kebag-logic/shish-lan/documentation/U1-LAN96455F-I_8MW_pin_out.md

# U1: LAN96455F-I/8MW

| Pin No | Pin Name | Connected to net |
| - | - | - |
| 1 | P2.A_P | /switch/switch_phys/RJ45_Connector_Port2/TRD1+_2 |
| 2 | P2.A_N | /switch/switch_phys/RJ45_Connector_Port2/TRD1-_2 |
| 3 | VDD_AL | /switch/switch_power/VDD_PHYS |
| 4 | P2.B_P | /switch/switch_phys/RJ45_Connector_Port2/TRD2+_2 |
| 5 | P2.B_N | /switch/switch_phys/RJ45_Connector_Port2/TRD2-_2 |
| 6 | VDD_AH | /switch/switch_power/VDDIO_PHY_AH |
| 7 | P2.C_P | /switch/switch_phys/RJ45_Connector_Port2/TRD3+_2 |
| 8 | P2.C_N | /switch/switch_phys/RJ45_Connector_Port2/TRD3-_2 |
| 9 | P2.D_P | /switch/switch_phys/RJ45_Connector_Port2/TRD4+_2 |
| 10 | P2.D_N | /switch/switch_phys/RJ45_Connector_Port2/TRD4-_2 |
| 11 | P3.A_P | /switch/switch_phys/RJ45_Connector_Port3/TRD1+_3 |
| 12 | P3.A_N | /switch/switch_phys/RJ45_Connector_Port3/TRD1-_3 |
| 13 | P3.B_P | /switch/switch_phys/RJ45_Connector_Port3/TRD2+_3 |
| 14 | P3.B_N | /switch/switch_phys/RJ45_Connector_Port3/TRD2-_3 |
| 15 | VDD_AL | /switch/switch_power/VDD_PHYS |
| 16 | VDD_AH | /switch/switch_power/VDDIO_PHY_AH |
| 17 | P3.C_P | /switch/switch_phys/RJ45_Connector_Port3/TRD3+_3 |
| 18 | P3.C_N | /switch/switch_phys/RJ45_Connector_Port3/TRD3-_3 |
| 19 | P3.D_P | /switch/switch_phys/RJ45_Connector_Port3/TRD4+_3 |
| 20 | P3.D_N | /switch/switch_phys/RJ45_Connector_Port3/TRD4-_3 |
| 21 | P4.A_P | n.c. |
| 22 | P4.A_N | n.c. |
| 23 | P4.B_P | n.c. |
| 24 | P4.B_N | n.c. |
| 25 | VDD_AH | /switch/switch_power/VDDIO_PHY_AH |
| 26 | P4.C_P | n.c. |
| 27 | P4.C_N | n.c. |
| 28 | VDD_AL | /switch/switch_power/VDD_PHYS |
| 29 | P4.D_P | n.c. |
| 30 | P4.D_N | n.c. |
| 31 | GPIO_43/SI_CLK/PHY0_LED1/SG0_LD/IRQ3/MAC_LED8/SD1/TMS | /switch/switch_gpios/PHY0_LED1 |
| 32 | VDD_IO_E | /switch/switch_power/VDDIO |
| 33 | GPIO_42/SI_nCS/PHY0_LED0/SG0_DI/IRQ2/MAC_LED7/SD0/NTRST | /switch/switch_gpios/PHY0_LED0 |
| 34 | GPIO_41/SI_DO/PHY1_LED1/SG0_DO/IRQ1/MAC_LED6/-/TDO|XMII_MODE0 | /switch/switch_gpios/XMII_MODE0 |
| 35 | GPIO_40/SI_DI/PHY1_LED0/SG0_CLK/-/MAC_LED5/-/TCK|SD_MODE1 | /switch/switch_gpios/SD_MODE1 |
| 36 | GPIO_39/UART_TXD/PHY2_LED1/-/-/MAC_LED4/-/TDI|SD_MODE0 | /switch/switch_gpios/SD_MODE0 |
| 37 | VDD | /switch/1V15_BUCK-OUT |
| 38 | GPIO_38/-/PHY2_LED0/PHY0_LED0/-/MAC_LED3/-/-|XMII_MODE1 | /switch/switch_gpios/XMII_MODE1 |
| 39 | VDD_IO_E | /switch/switch_power/VDDIO |
| 40 | GPIO_37/PTP1/PHY3_LED1/PHY1_LED0/-/MAC_LED2/-/-|GPIO_MODE1 | /switch/switch_gpios/GPIO_MODE1 |
| 41 | GPIO_36/PTP0/PHY3_LED0/PHY2_LED0/-/MAC_LED1/-/-|GPIO_MODE0 | /switch/switch_gpios/GPIO_MODE0 |
| 42 | GPIO_35/RCLK1/PHY4_LED1/PHY3_LED0/-/MAC_LED0/-/-|LOOP_EN | /switch/switch_gpios/LOOP_EN |
| 43 | GPIO_34/RCLK0/PHY4_LED0/PHY4_LED0/-/-/-/-|JTAG_EN | /switch/switch_gpios/JTAG_EN |
| 44 | VDD_AHS | /switch/switch_power/VDDIO_PHY_AHS |
| 45 | S0.CLKP | n.c. |
| 46 | S0.TX_N | n.c. |
| 47 | VDD_ALS0 | /switch/switch_power/VDD_SERDES |
| 48 | S0.TX_P | n.c. |
| 49 | S0.RX_N | n.c. |
| 50 | S0.RX_P | n.c. |
| 51 | RESREF | n.c. |
| 52 | VDD_AHS | /switch/switch_power/VDDIO_PHY_AHS |
| 53 | S1.TX_N | n.c. |
| 54 | VDD_ALS1 | /switch/switch_power/VDD_SERDES |
| 55 | S1.TX_P | n.c. |
| 56 | S1.RX_N | n.c. |
| 57 | S1.RX_P | n.c. |
| 58 | VDD_IO_D | /switch/switch_power/VDDIO |
| 59 | VDD | /switch/1V15_BUCK-OUT |
| 60 | GPIO_33/PTP3/IRQ0/|EEPROM_SIZE | /switch/switch_gpios/EEPROM_SIZE |
| 61 | GPIO_32/PTP2/I2C0_SCL1/-/-/-/-/- | /switch/switch_gpios/PTP2 |
| 62 | GPIO_31/PTP1/I2C0_SCL0/UART_TXD/-/-/-/- | /switch/switch_gpios/PTP1 |
| 63 | GPIO_30/PTP0/I2C0_SDA/UART_RXD/-/-/-/- | /switch/switch_gpios/PTP0 |
| 64 | GPIO_29/RCLK1/MIIM0_MDIO/-/-/-/-/- | /switch/switch_gpios/SYNCE_1 |
| 65 | GPIO_28/RCLK0/MIIM0_MDC/-/-/-/-/-|MGMT_MODE1 | /switch/switch_gpios/MGMT_MODE1 |
| 66 | GPIO_27/RGMII0_TXD3/-/-/-/-/-/-|MGMT_MODE0 | /switch/switch_gpios/MGMT_MODE0 |
| 67 | GPIO_26/RGMII0_TXD2/-/-/-/-/-/-|BOOT_MODE2 | /switch/switch_gpios/BOOT_MODE2 |
| 68 | GPIO_25/RGMII0_TXD1/-/-/-/-/-/-|BOOT_MODE1 | /switch/switch_gpios/BOOT_MODE1 |
| 69 | VDD_IO_C | /switch/switch_power/VDDIO |
| 70 | GPIO_24/RGMII0_TXD0/-/-/-/-/-/-|BOOT_MODE0 | /switch/switch_gpios/BOOT_MODE0 |
| 71 | GPIO_23/RGMII0_TXCTL-TX_DV/-/-/-/-/-/-|SD_125M | /switch/switch_gpios/SD_125M |
| 72 | GPIO_22/RGMII0_TXC-REFCLK/-/-/-/-/-/-|GPIO_EN | /switch/switch_gpios/SGPIO_EN |
| 73 | VDD | /switch/1V15_BUCK-OUT |
| 74 | GPIO_21/RGMII0_RXCTL-CRS_DV | /switch/switch_gpios/RGMII0.RX_CTLR |
| 75 | GPIO_20/RGMII0_RXC-REFCLK | /switch/switch_gpios/RGMII0.RX_CLK |
| 76 | GPIO_19/RGMII0_RXD3 | /switch/switch_gpios/RGMII0.RXD3 |
| 77 | VDD_IO_C | /switch/switch_power/VDDIO |
| 78 | GPIO_18/RGMII0_RXD2-RXER | /switch/switch_gpios/RGMII0.RXD2 |
| 79 | GPIO_17/RGMII0_RXD1 | /switch/switch_gpios/RGMII0.RXD1 |
| 80 | GPIO_16/RGMII0_RXD0 | /switch/switch_gpios/RGMII0.RXD0 |
| 81 | GPIO_15/RGMII1_TXD3/I2C0_SCL13/-/PTP3/-/-/-|SFP_EN | /switch/switch_gpios/SFP_EN |
| 82 | GPIO_14/RGMII1_TXD2/I2C0_SCL12/-/PTP2/-/MAC_LED5/-/-|_CUPHY_MODE | /switch/switch_gpios/CUPHY_MODE |
| 83 | GPIO_13/RGMII1_TXD1/I2C0_SCL11/-/PTP1/MAC_LED6/-/-|LED_MODE | /switch/switch_gpios/LED_MODE |
| 84 | VDD_IO_B | /switch/switch_power/VDDIO |
| 85 | GPIO_12/RGMII1_TXD0/I2C0_SCL10/MIIM1_MDIO/PTP0/-/-/-|EEE_EN | /switch/switch_gpios/EEE_EN |
| 86 | GPIO_11/RGMII1_TXCTL-TX_DV/I2C0_SCL9/MIIM1_MDC/-/IRQ3/-/-|_FLOW_EN | /switch/switch_gpios/FLOW_EN |
| 87 | GPIO_10/RGMII1_TXC-REFCLK/I2C0_SCL8/RCLK1/SG0_LD/IRQ2/UART_TXD/-|_E2E_CLOCK_EN | /switch/switch_gpios/E2E_CLOCK_EN |
| 88 | VDD | /switch/1V15_BUCK-OUT |
| 89 | GPIO_9/RGMII1_RXCTL-CRS_DV/I2C0_SCL7/RCLK0/SG0_DI/IRQ1/UART_RXD/- | /controller/RGMII1_SWITCH_STM.RXCTL-CRS_DV |
| 90 | GPIO_8/RGMII1_RXC-REFCLK/I2C0_SCL6/SD1/SG0_DO/MIIM1_MDIO/-/- | /controller/RGMII1_SWITCH_STM.RX_CLK |
| 91 | GPIO_7/RGMII1_RXD3/I2C0_SCL5/SD0/SG0_CLK/MIIM1_MDC/SI_SLV_CLK/- | /controller/RGMII1_SWITCH_STM.RXD3 |
| 92 | VDD_IO_B | /switch/switch_power/VDDIO |
| 93 | GPIO_6/RGMII1_RXD2-RXER/I2C0_SCL4/-/-/-/SI_SLV_nCS/- | /controller/RGMII1_SWITCH_STM.RXD2 |
| 94 | GPIO_5/RGMII1_RXD1/I2C0_SCL3/I2C1_SCL/-/-/SI_SLV_DO/- | /controller/RGMII1_SWITCH_STM.RXD1 |
| 95 | GPIO_4/RGMII1_RXD0/I2C0_SCL2/I2C1_SDA/-/-/SI_SVL_DI/- | /controller/RGMII1_SWITCH_STM.RXD0 |
| 96 | VDD_IO_A | /switch/switch_power/VDDIO |
| 97 | GPIO_3/SI_CLK//SI_SLV_CLK/I2C1_SCL/MIIM_SLV_MDIO/-/-/- | <unnamed> |
| 98 | GPIO_2/SI_nCS/SI_SLV_nCS/I2C1_SDA/-/-/-/- | /controller/SPI2_STM_SWITCH.nCS |
| 99 | GPIO_1/SI_DO/SI_SLV_DO/I2C_SLV_SCL/MIIM_SLV_MDC/UART_TXD/MIIM_MDIO/- | <unnamed> |
| 100 | GPIO_0/SI_DI/SI_SLV_DI/I2C_SLV_SDA/MIIM_SLV_ADDR/UART_RXD/MIIM1_MDC/- | <unnamed> |
| 101 | nRST | /switch/nRST_STM_TO_SWITCH |
| 102 | P0.A_P | /switch/switch_phys/RJ45_Connector_Port0/TRD1+_0 |
| 103 | P0.A_N | /switch/switch_phys/RJ45_Connector_Port0/TRD1-_0 |
| 104 | VDD_AL | /switch/switch_power/VDD_PHYS |
| 105 | P0.B_P | /switch/switch_phys/RJ45_Connector_Port0/TRD2+_0 |
| 106 | P0.B_N | /switch/switch_phys/RJ45_Connector_Port0/TRD2-_0 |
| 107 | VDD_AH | /switch/switch_power/VDDIO_PHY_AH |
| 108 | P0.C_P | /switch/switch_phys/RJ45_Connector_Port0/TRD3+_0 |
| 109 | P0.C_N | /switch/switch_phys/RJ45_Connector_Port0/TRD3-_0 |
| 110 | P0.D_P | /switch/switch_phys/RJ45_Connector_Port0/TRD4+_0 |
| 111 | P0.D_N | /switch/switch_phys/RJ45_Connector_Port0/TRD4-_0 |
| 112 | P1.A_P | /switch/switch_phys/RJ45_Connector_Port1/TRD1+_1 |
| 113 | P1.A_N | /switch/switch_phys/RJ45_Connector_Port1/TRD1-_1 |
| 114 | P1.B_P | /switch/switch_phys/RJ45_Connector_Port1/TRD2+_1 |
| 115 | P1.B_N | /switch/switch_phys/RJ45_Connector_Port1/TRD2-_1 |
| 116 | VDD_AH | /switch/switch_power/VDDIO_PHY_AH |
| 117 | P1.C_P | /switch/switch_phys/RJ45_Connector_Port1/TRD3+_1 |
| 118 | P1.C_N | /switch/switch_phys/RJ45_Connector_Port1/TRD3-_1 |
| 119 | VDD_AL | /switch/switch_power/VDD_PHYS |
| 120 | P1.D_P | /switch/switch_phys/RJ45_Connector_Port1/TRD4+_1 |
| 121 | P1.D_N | /switch/switch_phys/RJ45_Connector_Port1/TRD4-_1 |
| 122 | VDD | /switch/1V15_BUCK-OUT |
| 123 | XO | Net-(U1A-XO) |
| 124 | XI | Net-(U1A-XI) |
| 125 | RTN_PLL | Net-(U1A-RTN_PLL) |
| 126 | VDD_PLL | Net-(U1A-VDD_PLL) |
| 127 | ISET | Net-(U1C-ISET) |
| 128 | VDD_AH | /switch/switch_power/VDDIO_PHY_AH |
| EPAD | GND_PAD | GND |
