kebag-logic/shish-lan/documentation/U4-STM32H742VGT6_pin_out.md

# U4: STM32H742VGT6

| Pin No | Pin Name | Connected to net |
| - | - | - |
| 1 | PE2 | /controller/debug_header/P3 |
| 2 | PE3 | /controller/debug_header/P4 |
| 3 | PE4 | /controller/debug_header/P5 |
| 4 | PE5 | /controller/debug_header/P6 |
| 5 | PE6 | /controller/debug_header/P7 |
| 6 | VBAT | Net-(U4-VBAT) |
| 7 | PC13 | n.c. |
| 8 | PC14 | n.c. |
| 9 | PC15 | n.c. |
| 10 | VSS | GND |
| 11 | VDD | Net-(U4-VBAT) |
| 12 | PH0 | /controller/xtal_stm/Pin1 |
| 13 | PH1 | /controller/xtal_stm/Pin2 |
| 14 | NRST | /controller/RST_STM_JTAG |
| 15 | PC0 | n.c. |
| 16 | PC1 | /controller/MIIM0_STM_SWITCH.SLV_MDC |
| 17 | PC2_C | n.c. |
| 18 | PC3_C | n.c. |
| 19 | VSSA | GND |
| 20 | VREF+ | +3V3 |
| 21 | VDDA | Net-(U4-VBAT) |
| 22 | PA0 | n.c. |
| 23 | PA1 | /controller/RGMII1_SWITCH_STM.TXC-REFCLK |
| 24 | PA2 | /controller/MIIM0_STM_SWITCH.SLV_MDIO |
| 25 | PA3 | n.c. |
| 26 | VSS | GND |
| 27 | VDD | Net-(U4-VBAT) |
| 28 | PA4 | /controller/I2S3_WS |
| 29 | PA5 | n.c. |
| 30 | PA6 | n.c. |
| 31 | PA7 | /controller/RGMII1_SWITCH_STM.RXCTL-CRS_DV |
| 32 | PC4 | /controller/RGMII1_SWITCH_STM.TXD0 |
| 33 | PC5 | /controller/RGMII1_SWITCH_STM.TXD1 |
| 34 | PB0 | n.c. |
| 35 | PB1 | n.c. |
| 36 | PB2 | /controller/I2S3_SDO |
| 37 | PE7 | /controller/debug_header/P8 |
| 38 | PE8 | /controller/debug_header/P9 |
| 39 | PE9 | /controller/debug_header/P10 |
| 40 | PE10 | /controller/debug_header/P11 |
| 41 | PE11 | /controller/debug_header/P12 |
| 42 | PE12 | /controller/debug_header/P13 |
| 43 | PE13 | /controller/debug_header/P14 |
| 44 | PE14 | /controller/debug_header/P15 |
| 45 | PE15 | /controller/debug_header/P16 |
| 46 | PB10 | n.c. |
| 47 | PB11 | Net-(U4-PB11) |
| 48 | VCAP | Net-(C81-Pad2) |
| 49 | VSS | GND |
| 50 | VDD | Net-(U4-VBAT) |
| 51 | PB12 | Net-(U4-PB12) |
| 52 | PB13 | Net-(U4-PB13) |
| 53 | PB14 | /controller/SPI2_STM_SWITCH.MISO |
| 54 | PB15 | /controller/SPI2_STM_SWITCH.MOSI |
| 55 | PD8 | n.c. |
| 56 | PD9 | n.c. |
| 57 | PD10 | n.c. |
| 58 | PD11 | n.c. |
| 59 | PD12 | n.c. |
| 60 | PD13 | n.c. |
| 61 | PD14 | n.c. |
| 62 | PD15 | n.c. |
| 63 | PC6 | n.c. |
| 64 | PC7 | /controller/I2S3_MCK |
| 65 | PC8 | n.c. |
| 66 | PC9 | n.c. |
| 67 | PA8 | n.c. |
| 68 | PA9 | /controller/USART1_STM_SWITCH.TX |
| 69 | PA10 | /controller/USART1_STM_SWITCH.RX |
| 70 | PA11 | /controller/SPI2_STM_SWITCH.nCS |
| 71 | PA12 | /controller/SPI2_STM_SWITCH.CLK |
| 72 | PA13 | /controller/SWDIO_TMS_JTM_JTAG |
| 73 | VCAP | Net-(C83-Pad2) |
| 74 | VSS | GND |
| 75 | VDD | Net-(U4-VBAT) |
| 76 | PA14 | /controller/SWCLK_TCLK_STM_JTAG |
| 77 | PA15 | /controller/TDI_STM_JTAG |
| 78 | PC10 | /controller/I2S3_CK |
| 79 | PC11 | /controller/I2S_SDI |
| 80 | PC12 | n.c. |
| 81 | PD0 | /switch/EN-1V15_STM_TO_BUCK |
| 82 | PD1 | /switch/EN-2V5_STM_TO_BUCK |
| 83 | PD2 | /switch/nRST_STM_TO_SWITCH |
| 84 | PD3 | /switch/IRQ0_SWITCH_TO_STM |
| 85 | PD4 | n.c. |
| 86 | PD5 | n.c. |
| 87 | PD6 | n.c. |
| 88 | PD7 | n.c. |
| 89 | PB3 | /controller/SWO_TDO_STM_JTAG |
| 90 | PB4 | /controller/TRST_STM_JTAG |
| 91 | PB5 | n.c. |
| 92 | PB6 | /controller/I2C1.SCL |
| 93 | PB7 | /controller/I2C1.SDA |
| 94 | BOOT0 | Net-(J6-Pin_2) |
| 95 | PB8 | n.c. |
| 96 | PB9 | n.c. |
| 97 | PE0 | /controller/debug_header/P1 |
| 98 | PE1 | /controller/debug_header/P2 |
| 99 | VSS | GND |
| 100 | VDD | Net-(U4-VBAT) |
