kebag-logic/shish-lan/documentation/current_consumption.md

| Identifier | Name | I_DD_1V15_max_A | I_DD_AH25_2V5_max_A | I_DD_AH33_3V3_max_A | I_DD_ALSx_1V15_max_A | I_DD_AL_1V15_max_A | I_DD_IO25_2V5_max_A | I_DD_IO33_3V3_max_A | I_DD_IOD | I_DD_max_A | I_OUT_A | I_VIN_A |
|---|---|---|---|---|---|---|---|---|---|---|---|---|
| U1 | LAN96455F-I/8MW | 0.935 | 0.475 | 0.505 | 0.025 | 0.4 | 0.045 | 0.075 | 0.005 |  |  |  |
| U2 | TPS564257DRLR |  |  |  |  |  |  |  |  |  | 4.0 | 0.00037 |
| U3 | TPS564257DRLR |  |  |  |  |  |  |  |  |  | 4.0 | 0.00037 |
| U4 | STM32H742VGT6 |  |  |  |  |  |  |  |  | 0.544 |  |  |
| U5 | TPS564257DRLR |  |  |  |  |  |  |  |  |  | 4.0 | 0.00037 |
| Sum |  | 0.935 | 0.475 | 0.505 | 0.025 | 0.4 | 0.045 | 0.075 | 0.005 | 0.544 | 12.0 | 0.00111 |
