kebag-logic/shish-lan/documentation/pcb.pdf

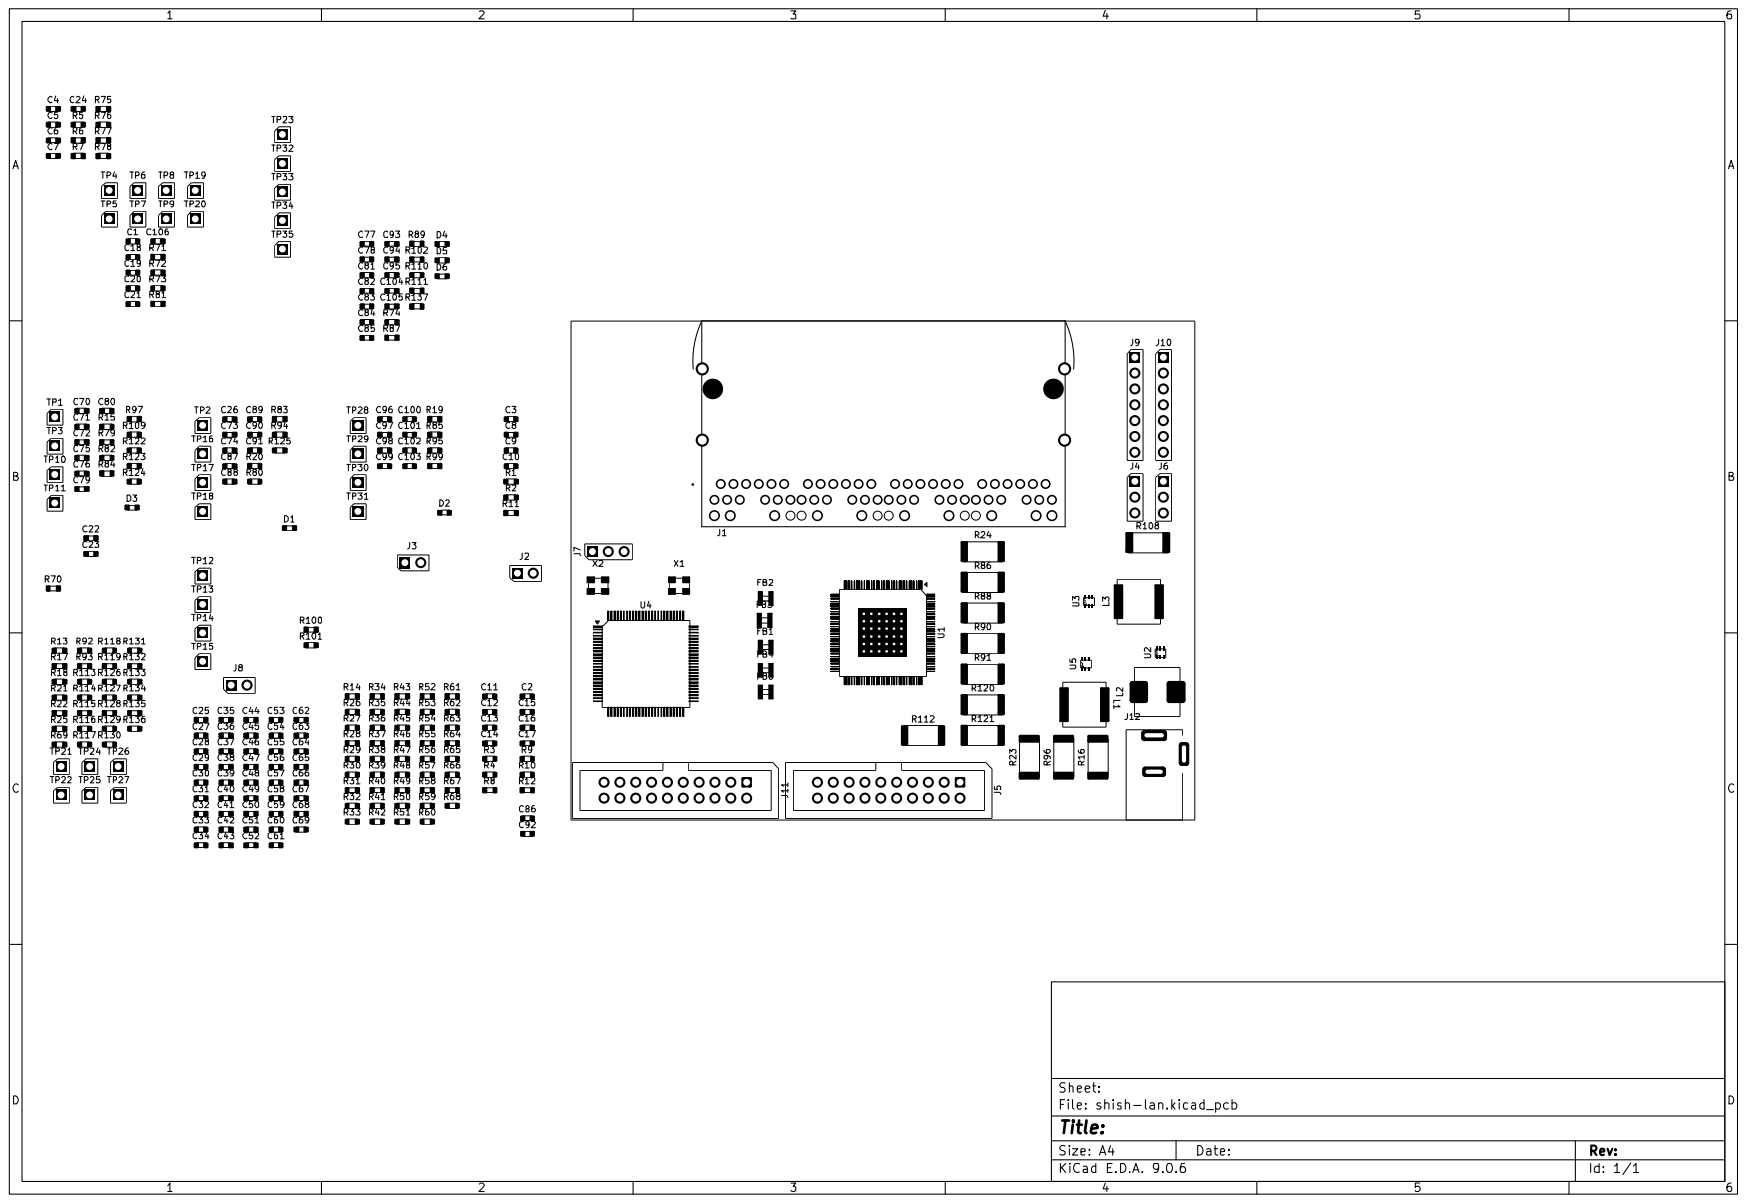
[picture p4: page 1]
