kebag-logic/shish-lan/shish-lan.kicad_pcb

## KiCad design shish-lan.kicad_pcb (2026-09-29)

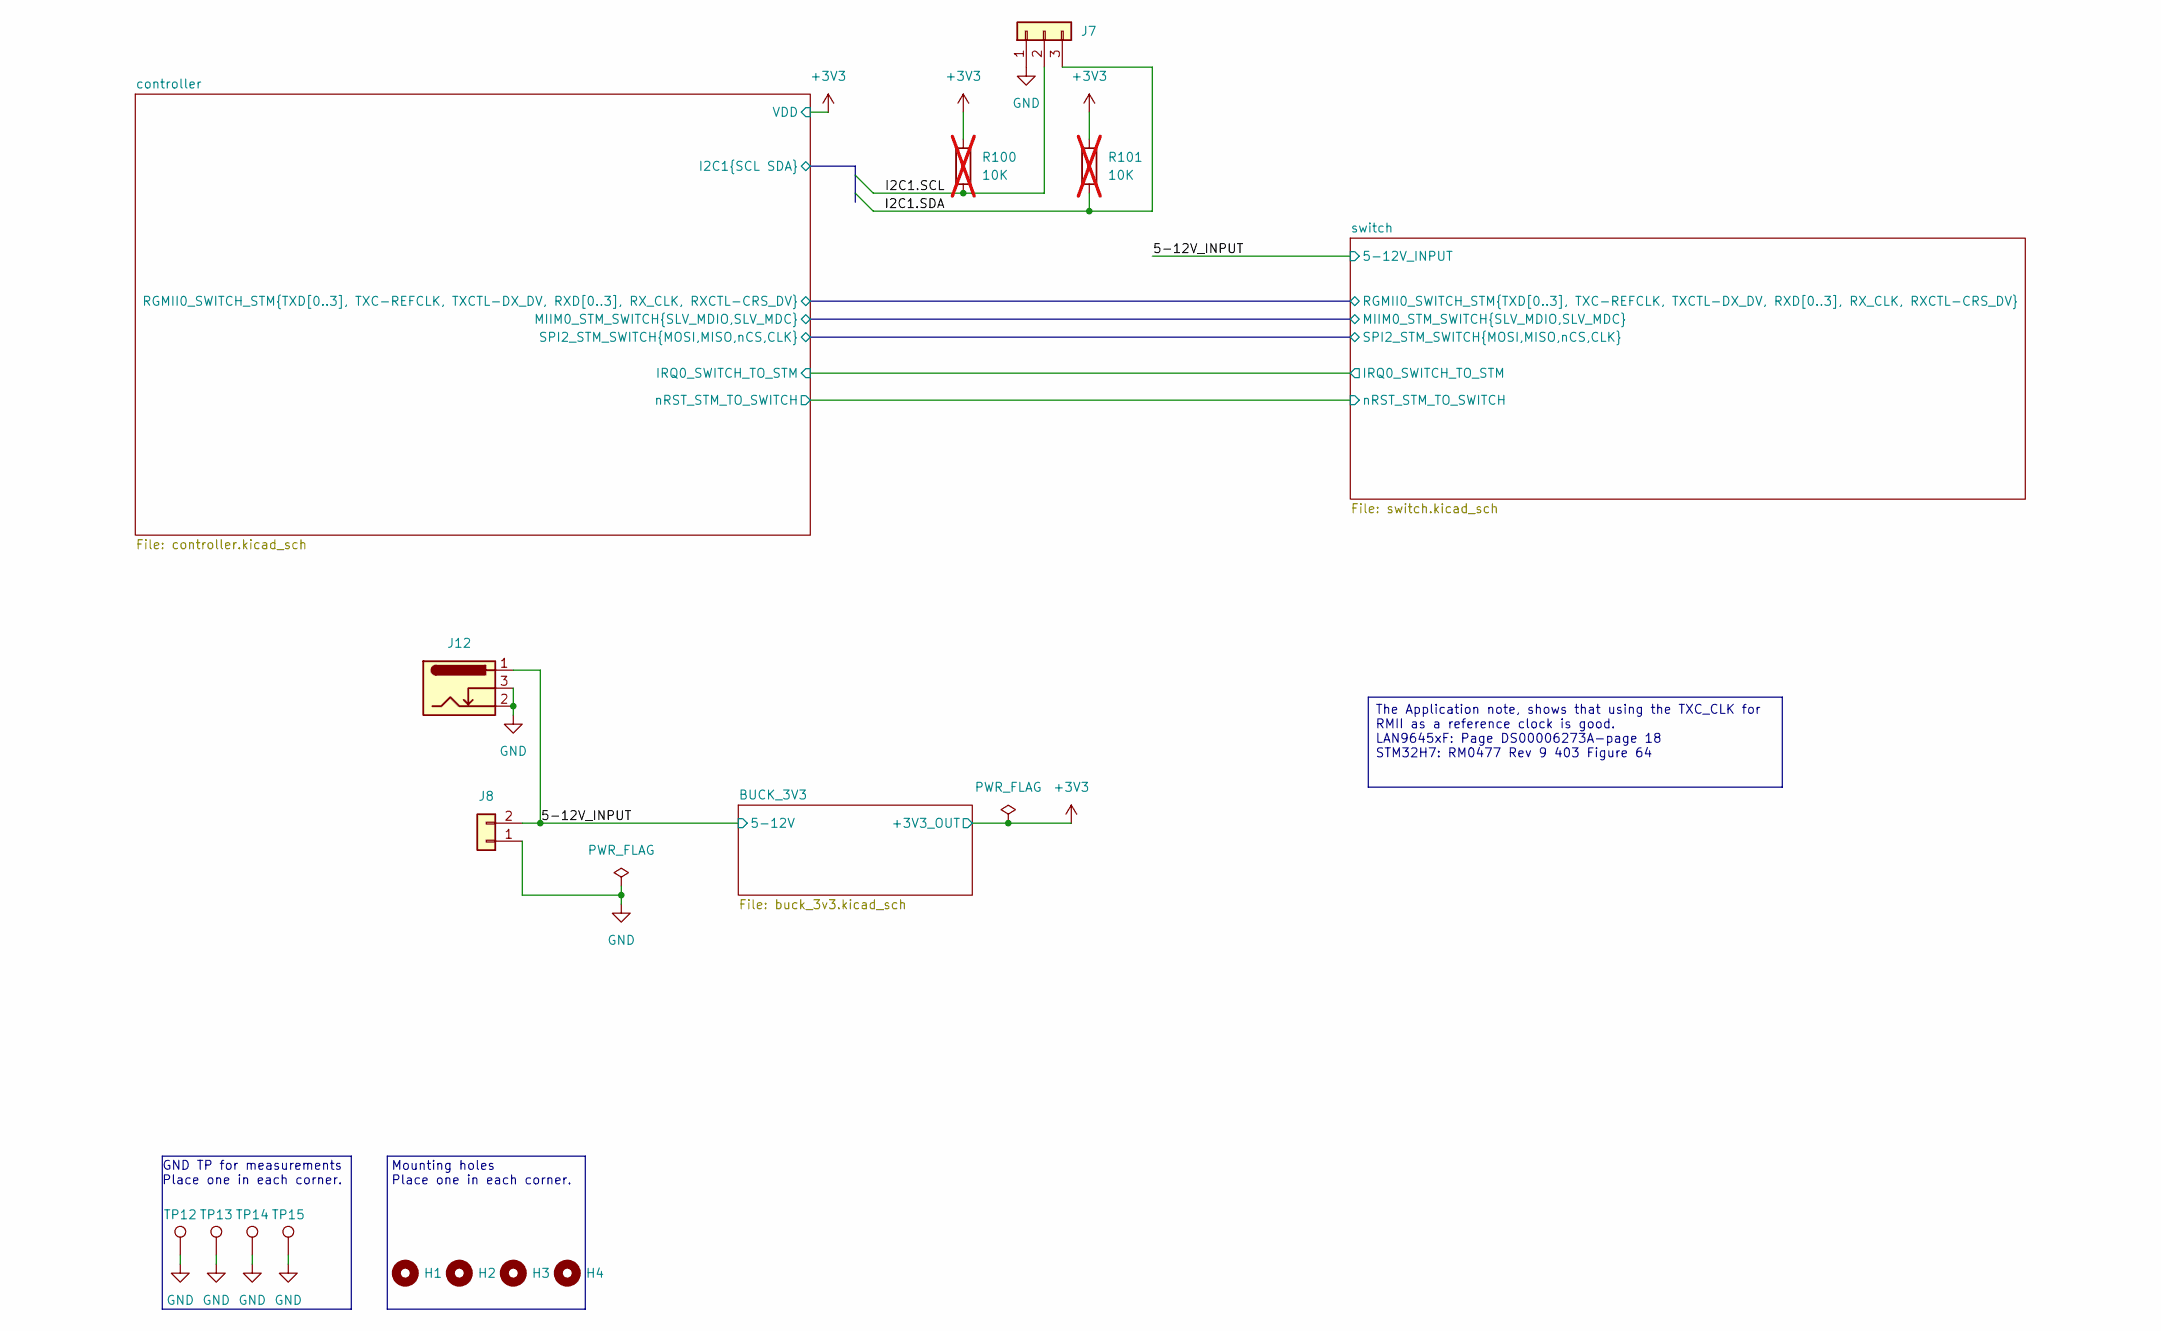
[picture p5: schematic shish-lan.kicad_sch, TOP level overview]

Parts:
H1, H2, H3, H4: MountingHole_M3; MountingHole_3.2mm_M3_Pad
J7: Header_03x01_2.54mm_0mm_Straight; 03x01_2.54mm_Header; MPN 87224-3; Mouser 571-872243
J8: Header_02x01_2.54mm_0mm_Straight; 02x01_2.54mm_Header; MPN 87224-2; Mouser 571-872242
J12: DC-Jack_Wuerth_694108301002; MPN 694108301002; Mouser 710-694108301002
R100, R101: 10K; R_0603; Tolerance_in_pct 5; MPN CRCW060310K0JNEC; Mouser 71-CRCW060310K0JNEC; not fitted
TP12, TP13, TP14, TP15: TestPoint

Connections:
+3V3: R100.1, R101.1; also elsewhere on the board
/5-12V_INPUT: J8.2, J12.1; also elsewhere on the board
/controller/I2C1.SCL: J7.2, R100.2; also elsewhere on the board
/controller/I2C1.SDA: J7.3, R101.2; also elsewhere on the board
GND: J7.1, J8.1, J12.2, J12.3, TP12.1 (1_1), TP13.1 (1_1), TP14.1 (1_1), TP15.1 (1_1); also elsewhere on the board

Notes on the sheet:
Mounting holes Place one in each corner.
GND TP for measurements Place one in each corner.
The Application note, shows that using the TXC_CLK for RMII as a reference clock is good. LAN9645xF: Page DS00006273A-page 18 STM32H7: RM0477 Rev 9 403 Figure 64

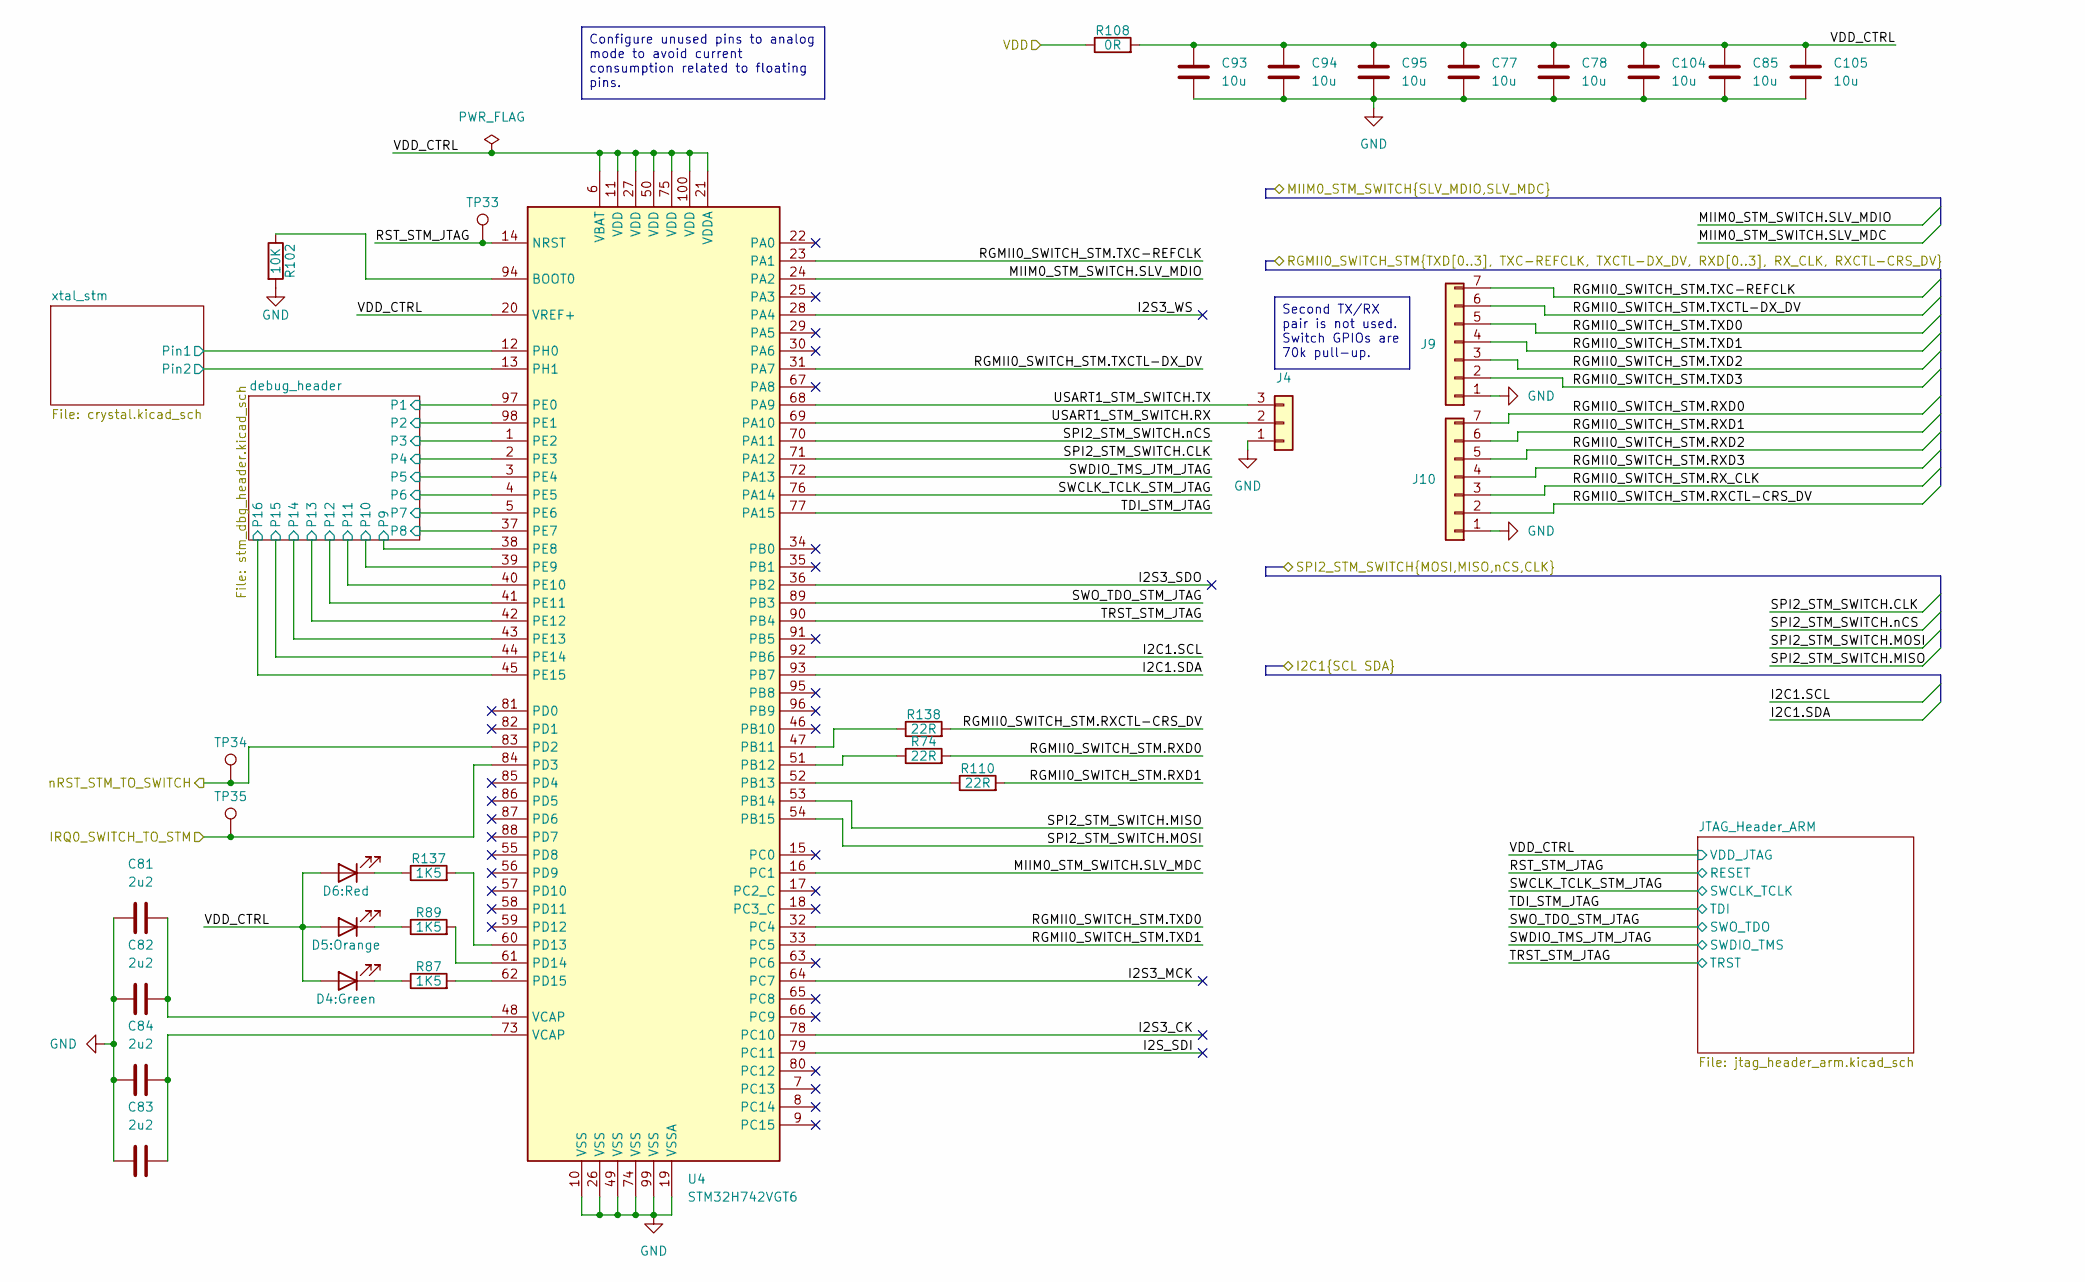
[picture p6: schematic controller.kicad_sch]

Parts:
C77, C78, C85, C93, C94, C95, C104, C105: 10u; C_0603; Voltage_in_V 25; Tolerance_in_pct 20; MPN CL10A106MA8NRNC; Mouser 187-CL10A106MA8NRNC
C81, C82, C83, C84: 2u2; C_0603; Voltage_in_V 35; Tolerance_in_pct 20; MPN GRM188R6YA225MA12D; Mouser 81-GRM188R6YA225MA2D
D4: LED_{color}_{U_F}_{I_F}; LED_0603; MPN LTST-C190GKT; Mouser 859-LTST-C190GKT
D5: LED_{color}_{U_F}_{I_F}; LED_0603; MPN LTST-C190KFKT; Mouser 859-LTST-C190KFKT
D6: LED_{color}_{U_F}_{I_F}; LED_0603; MPN LTST-C194KRKT; Mouser 859-LTST-C194KRKT
J4: Header_03x01_2.54mm_0mm_Straight; 03x01_2.54mm_Header; MPN 87224-3; Mouser 571-872243
J9, J10: Header_07x01_2.54mm_0mm_Straight; 07x01_2.54mm_Header; MPN TLW-107-06-G-S; Mouser 200-TLW10706GS
R74, R110, R138: 22R; R_0603; Tolerance_in_pct 1; MPN RC0603FR-1022RL; Mouser 603-RC0603FR-1022RL
R87, R89, R137: 1K5; R_0603; Tolerance_in_pct 5; MPN AC0603JR-071K5L; Mouser 603-AC0603JR-071K5L
R102: 10K; R_0603; Tolerance_in_pct 5; MPN CRCW060310K0JNEC; Mouser 71-CRCW060310K0JNEC
R108: 0R; R_2512; Tolerance_in_pct 5; MPN CRF2512-J/-000ELF; Mouser 652-CRF2512-J-000ELF
TP33, TP34, TP35: TestPoint
U4: STM32H742VGT6; LQFP-100_14x14mm_P0.5mm; MPN STM32H742VGT6; Mouser 511-STM32H742VGT6

Connections:
+3V3: R108.1; also elsewhere on the board
/controller/I2C1.SCL: U4.92 (PB6); also elsewhere on the board
/controller/I2C1.SDA: U4.93 (PB7); also elsewhere on the board
/controller/I2S3_CK: U4.78 (PC10)
/controller/I2S3_MCK: U4.64 (PC7)
/controller/I2S3_SDO: U4.36 (PB2)
/controller/I2S3_WS: U4.28 (PA4)
/controller/I2S_SDI: U4.79 (PC11)
/controller/MIIM0_STM_SWITCH.SLV_MDC: U4.16 (PC1); also elsewhere on the board
/controller/MIIM0_STM_SWITCH.SLV_MDIO: U4.24 (PA2); also elsewhere on the board
/controller/RGMII0_SWITCH_STM.RXCTL-CRS_DV: J10.2, R138.2; also elsewhere on the board
/controller/RGMII0_SWITCH_STM.RXD0: J10.7 (Pin_3), R74.2; also elsewhere on the board
/controller/RGMII0_SWITCH_STM.RXD1: J10.6 (Pin_3), R110.2; also elsewhere on the board
/controller/RGMII0_SWITCH_STM.RXD2: J10.5 (Pin_2); also elsewhere on the board
/controller/RGMII0_SWITCH_STM.RXD3: J10.4 (Pin_1); also elsewhere on the board
/controller/RGMII0_SWITCH_STM.RX_CLK: J10.3; also elsewhere on the board
/controller/RGMII0_SWITCH_STM.TXC-REFCLK: J9.7 (Pin_3), U4.23 (PA1); also elsewhere on the board
/controller/RGMII0_SWITCH_STM.TXCTL-DX_DV: J9.6 (Pin_3), U4.31 (PA7); also elsewhere on the board
/controller/RGMII0_SWITCH_STM.TXD0: J9.5 (Pin_2), U4.32 (PC4); also elsewhere on the board
/controller/RGMII0_SWITCH_STM.TXD1: J9.4 (Pin_1), U4.33 (PC5); also elsewhere on the board
/controller/RGMII0_SWITCH_STM.TXD2: J9.3; also elsewhere on the board
/controller/RGMII0_SWITCH_STM.TXD3: J9.2; also elsewhere on the board
/controller/RST_STM_JTAG: TP33.1 (1_1), U4.14 (NRST); also elsewhere on the board
/controller/SPI2_STM_SWITCH.CLK: U4.71 (PA12); also elsewhere on the board
/controller/SPI2_STM_SWITCH.MISO: U4.53 (PB14); also elsewhere on the board
/controller/SPI2_STM_SWITCH.MOSI: U4.54 (PB15); also elsewhere on the board
/controller/SPI2_STM_SWITCH.nCS: U4.70 (PA11); also elsewhere on the board
/controller/SWCLK_TCLK_STM_JTAG: U4.76 (PA14); also elsewhere on the board
/controller/SWDIO_TMS_JTM_JTAG: U4.72 (PA13); also elsewhere on the board
/controller/SWO_TDO_STM_JTAG: U4.89 (PB3); also elsewhere on the board
/controller/TDI_STM_JTAG: U4.77 (PA15); also elsewhere on the board
/controller/TRST_STM_JTAG: U4.90 (PB4); also elsewhere on the board
/controller/USART1_STM_SWITCH.RX: J4.2, U4.69 (PA10)
/controller/USART1_STM_SWITCH.TX: J4.3, U4.68 (PA9)
/controller/VDD_CTRL: C77.1, C78.1, C85.1, C93.1, C94.1, C95.1, C104.1, C105.1, D4.2 (A), D5.2 (A), D6.2 (A), R108.2, U4.6 (VBAT), U4.11 (VDD), U4.20 (VREF+), U4.21 (VDDA), U4.27 (VDD), U4.50 (VDD), U4.75 (VDD), U4.100 (VDD); also elsewhere on the board
/controller/debug_header/P1: U4.97 (PE0); also elsewhere on the board
/controller/debug_header/P2: U4.98 (PE1); also elsewhere on the board
/controller/debug_header/P3: U4.1 (PE2); also elsewhere on the board
/controller/debug_header/P4: U4.2 (PE3); also elsewhere on the board
/controller/debug_header/P5: U4.3 (PE4); also elsewhere on the board
/controller/debug_header/P6: U4.4 (PE5); also elsewhere on the board
/controller/debug_header/P7: U4.5 (PE6); also elsewhere on the board
/controller/debug_header/P8: U4.37 (PE7); also elsewhere on the board
/controller/debug_header/P9: U4.38 (PE8); also elsewhere on the board
/controller/debug_header/P10: U4.39 (PE9); also elsewhere on the board
/controller/debug_header/P11: U4.40 (PE10); also elsewhere on the board
/controller/debug_header/P12: U4.41 (PE11); also elsewhere on the board
/controller/debug_header/P13: U4.42 (PE12); also elsewhere on the board
/controller/debug_header/P14: U4.43 (PE13); also elsewhere on the board
/controller/debug_header/P15: U4.44 (PE14); also elsewhere on the board
/controller/debug_header/P16: U4.45 (PE15); also elsewhere on the board
/controller/xtal_stm/Pin1: U4.12 (PH0); also elsewhere on the board
/controller/xtal_stm/Pin2: U4.13 (PH1); also elsewhere on the board
/switch/IRQ0_SWITCH_TO_STM: TP35.1 (1_1), U4.84 (PD3); also elsewhere on the board
/switch/nRST_STM_TO_SWITCH: TP34.1 (1_1), U4.83 (PD2); also elsewhere on the board
GND: C77.2, C78.2, C81.1, C82.1, C83.1, C84.1, C85.2, C93.2, C94.2, C95.2, C104.2, C105.2, J4.1, J9.1, J10.1, R102.2, U4.10 (VSS), U4.19 (VSSA), U4.26 (VSS), U4.49 (VSS), U4.74 (VSS), U4.99 (VSS); also elsewhere on the board
unnamed: C81.2, C82.2, U4.48 (VCAP)
unnamed: C83.2, C84.2, U4.73 (VCAP)
unnamed: D4.1 (K), R87.1
unnamed: D5.1 (K), R89.1
unnamed: D6.1 (K), R137.1
unnamed: R102.1, U4.94 (BOOT0)
unnamed: R138.1, U4.47 (PB11)
unnamed: R74.1, U4.51 (PB12)
unnamed: R110.1, U4.52 (PB13)
unnamed: R137.2, U4.60 (PD13)
unnamed: R89.2, U4.61 (PD14)
unnamed: R87.2, U4.62 (PD15)

Notes on the sheet:
Second TX/RX pair is not used. Switch GPIOs are 70k pull-up.
Configure unused pins to analog mode to avoid current consumption related to floating pins.

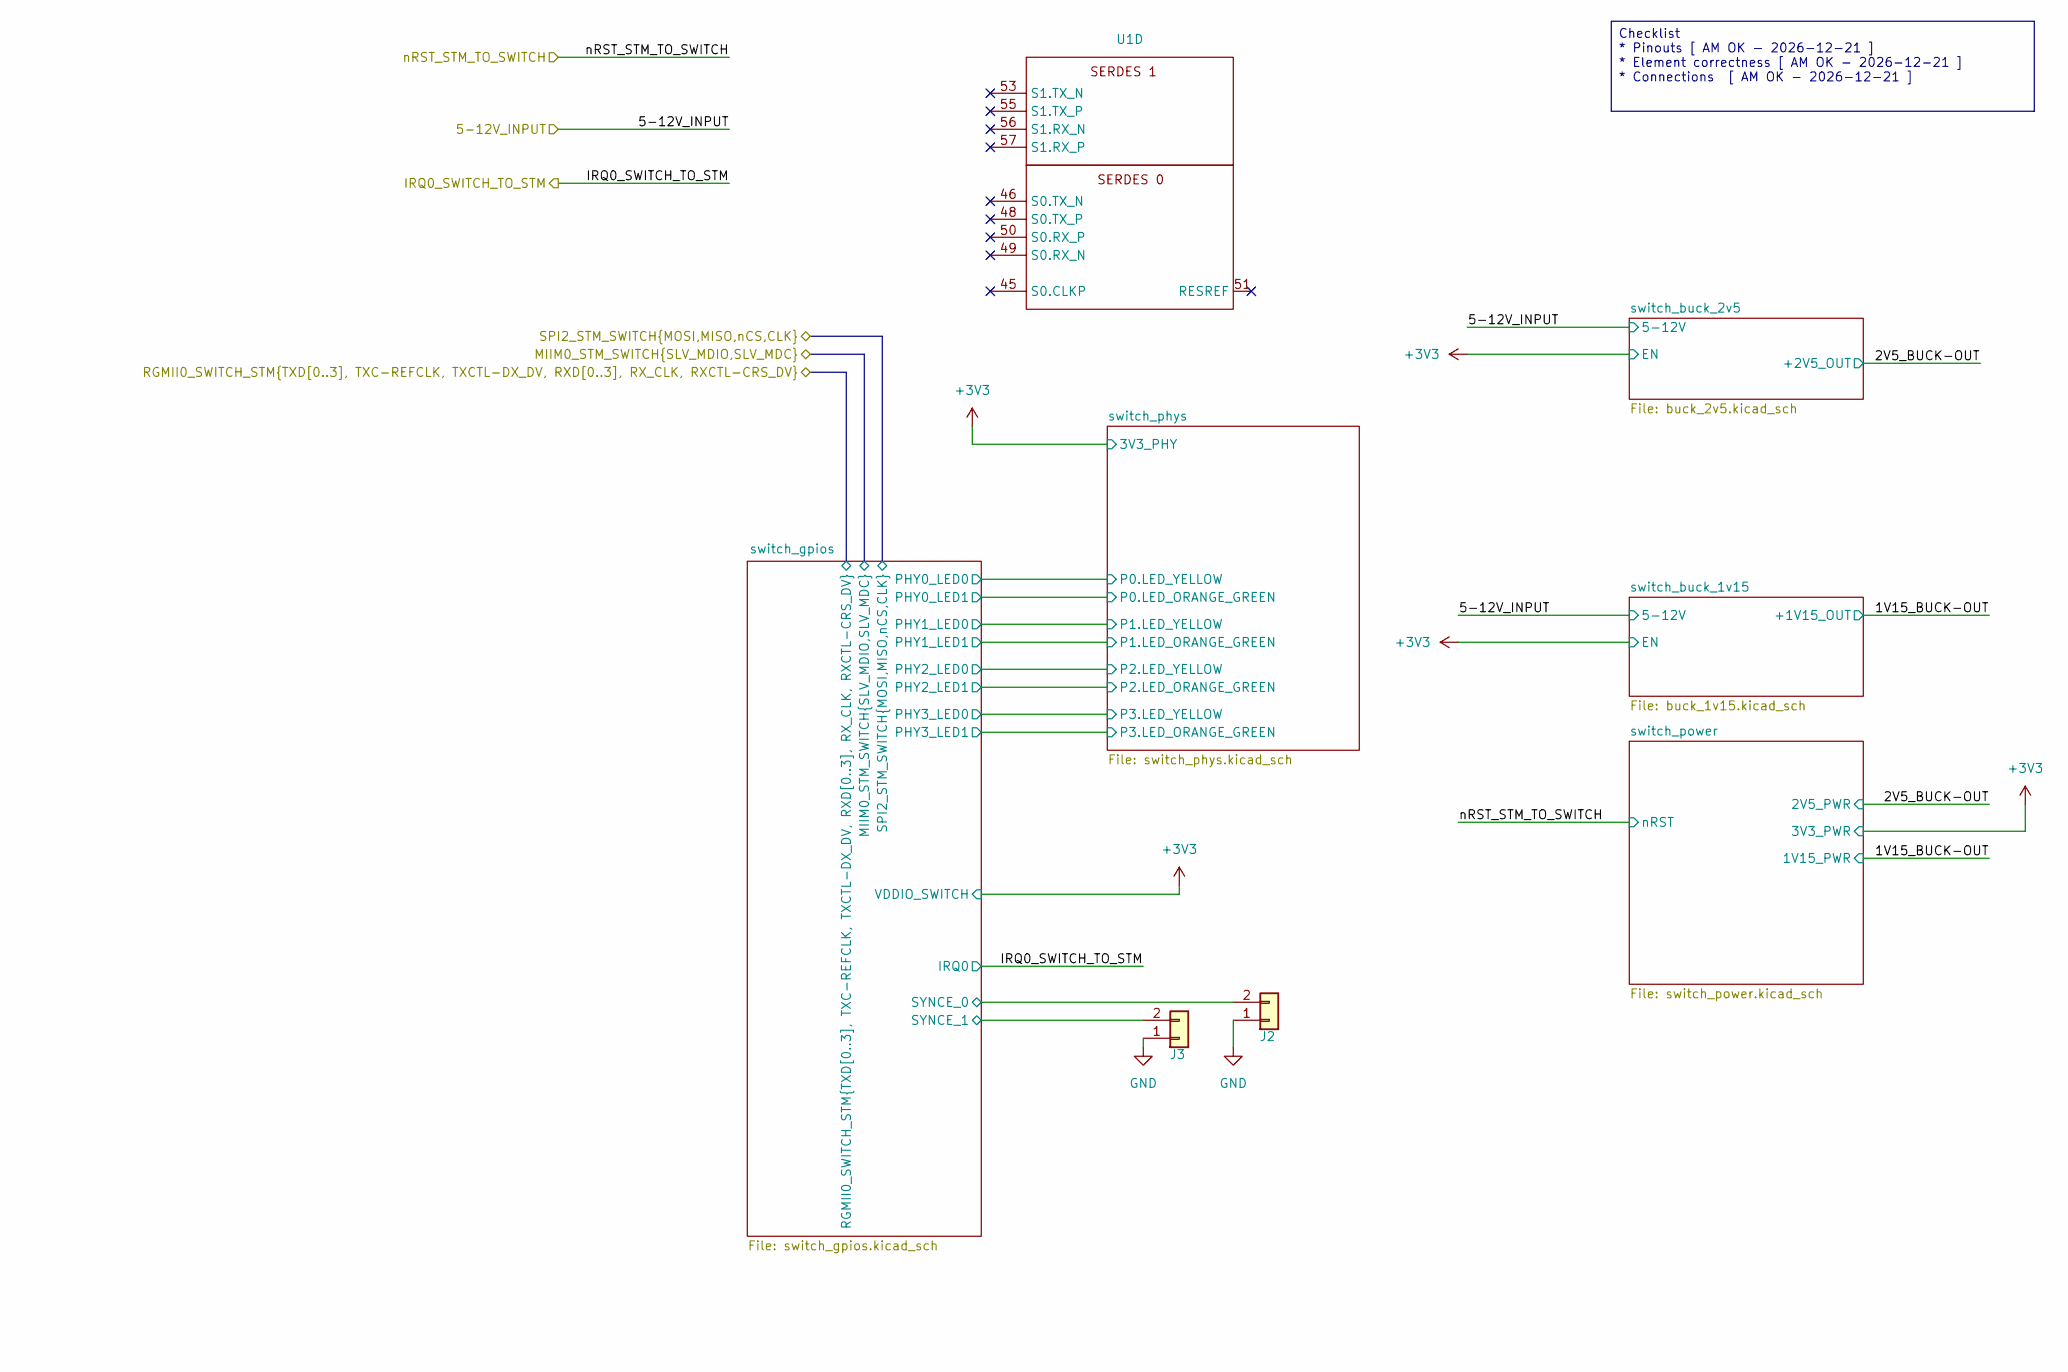
[picture p7: schematic switch.kicad_sch, Switch Top Level]

Parts:
J2, J3: Header_02x01_2.54mm_0mm_Straight; 02x01_2.54mm_Header; MPN 87224-2; Mouser 571-872242
U1: LAN96455F-I/8MW; TQFP-128_14x14mm_P0.4mm; MPN LAN96455F-I/8MW; Mouser 579-LAN96455FI8MW

Connections:
/switch/switch_gpios/SYNCE_0: J2.2; also elsewhere on the board
/switch/switch_gpios/SYNCE_1: J3.2; also elsewhere on the board
GND: J2.1, J3.1; also elsewhere on the board

Notes on the sheet:
Checklist * Pinouts [ AM OK - 2026-12-21 ] * Element correctness [ AM OK - 2026-12-21 ] * Connections [ AM OK - 2026-12-21 ]

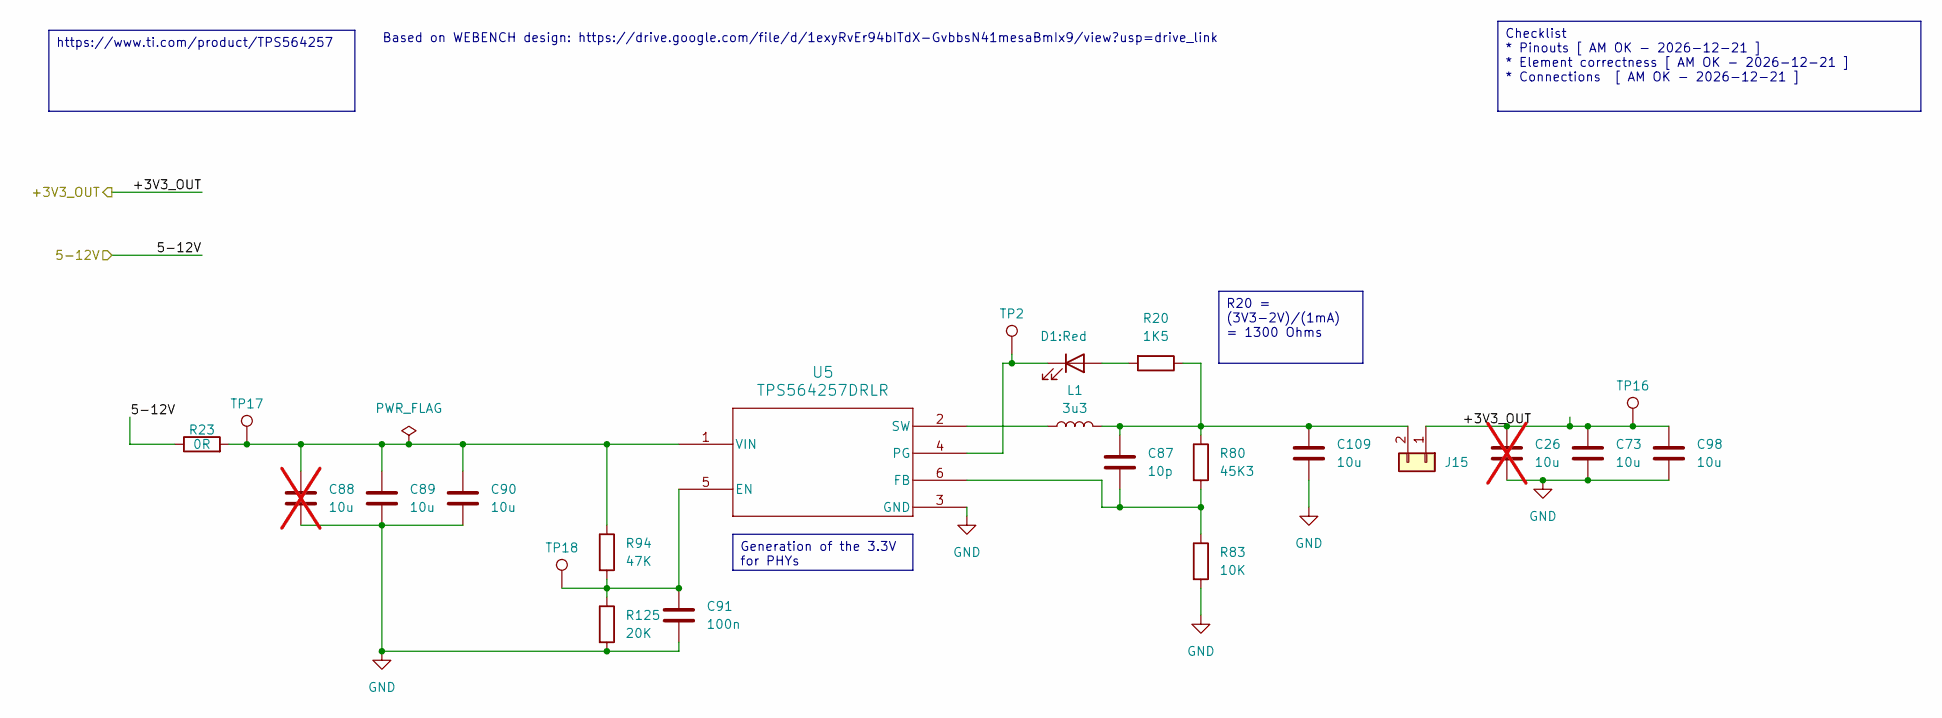
[picture p8: schematic buck_3v3.kicad_sch, Switch 3V3 Power Rail]

Parts:
C26, C88: 10u; C_0603; Voltage_in_V 25; Tolerance_in_pct 20; MPN CL10A106MA8NRNC; Mouser 187-CL10A106MA8NRNC; not fitted
C73, C89, C90, C98, C109: 10u; C_0603; Voltage_in_V 25; Tolerance_in_pct 20; MPN CL10A106MA8NRNC; Mouser 187-CL10A106MA8NRNC
C87: 10p; C_0603; Voltage_in_V 25; Tolerance_in_pct 5; MPN CC0603JRNPO8BN100; Mouser 603-CC0603JRNP8BN100
C91: 100n; C_0603; Voltage_in_V 50; Tolerance_in_pct 10; MPN CL10B104KB8NNNC; Mouser 187-CL10B104KB8NNNC
D1: LED_{color}_{U_F}_{I_F}; LED_0603; MPN LTST-C194KRKT; Mouser 859-LTST-C194KRKT
J15: Header_02x01_2.54mm_0mm_Straight; 02x01_2.54mm_Header; MPN 87224-2; Mouser 571-872242
L1: 3u3; EXLA1V0603; Tolerance_in_pct 20; MPN EXLA1V0603-3R3-R; Digikey 283-EXLA1V0603-3R3-RCT-ND
R20: 1K5; R_0603; Tolerance_in_pct 5; MPN AC0603JR-071K5L; Mouser 603-AC0603JR-071K5L
R23: 0R; R_2512; Tolerance_in_pct 5; MPN CRF2512-J/-000ELF; Mouser 652-CRF2512-J-000ELF
R80: 45K3; R_0603; Tolerance_in_pct 1; MPN RC0603FR-0745K3L; Mouser 603-RC0603FR-0745K3L
R83: 10K; R_0603; Tolerance_in_pct 1; MPN RC0603FR-0710KL; Mouser 603-RC0603FR-0710KL
R94: 47K; R_0603; Tolerance_in_pct 1; MPN RC0603FR-0747KP; Mouser 603-RC0603FR-0747KP
R125: 20K; R_0603; Tolerance_in_pct 1; MPN RC0603FR-1320KL; Mouser 603-RC0603FR-1320KL
TP2, TP16, TP17, TP18: TestPoint
U5: TPS564257DRLR; SOT-563; MPN TPS564257DRLR; Mouser 595-TPS564257DRLR

Connections:
+3V3: C26.1, C73.1, C98.1, J15.1, TP16.1 (1_1); also elsewhere on the board
/5-12V_INPUT: R23.1; also elsewhere on the board
GND: C26.2, C73.2, C88.2, C89.2, C90.2, C91.2, C98.2, C109.2, R83.2, R125.2, U5.3 (GND); also elsewhere on the board
unnamed: D1.2 (A), R20.2
unnamed: D1.1 (K), TP2.1 (1_1), U5.4 (PG)
unnamed: C87.1, C109.1, J15.2, L1.2, R20.1, R80.1
unnamed: C91.1, R94.2, R125.1, TP18.1 (1_1), U5.5 (EN)
unnamed: C87.2, R80.2, R83.1, U5.6 (FB)
unnamed: L1.1, U5.2 (SW)
unnamed: C88.1, C89.1, C90.1, R23.2, R94.1, TP17.1 (1_1), U5.1 (VIN)

Notes on the sheet:
Based on WEBENCH design: https://drive.google.com/file/d/1exyRvEr94bITdX-GvbbsN41mesaBmIx9/view?usp=drive_link
R20 = (3V3-2V)/(1mA) = 1300 Ohms
https://www.ti.com/product/TPS564257
Checklist * Pinouts [ AM OK - 2026-12-21 ] * Element correctness [ AM OK - 2026-12-21 ] * Connections [ AM OK - 2026-12-21 ]
Generation of the 3.3V for PHYs

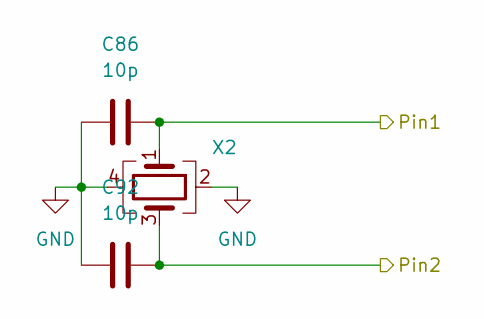
[picture p9: schematic crystal.kicad_sch, Oscillator 25MHz]

Parts:
C86, C92: 10p; C_0603; Voltage_in_V 25; Tolerance_in_pct 5; MPN CC0603JRNPO8BN100; Mouser 603-CC0603JRNP8BN100
X2: 25M; VXM7; MPN VXM7-9032-25M0000000; Digikey 150-VXM7-9032-25M0000000CT-ND

Connections:
/controller/xtal_stm/Pin1: C86.1, X2.1; also elsewhere on the board
/controller/xtal_stm/Pin2: C92.1, X2.3; also elsewhere on the board
GND: C86.2, C92.2, X2.2, X2.4; also elsewhere on the board

Parts of its further copies:
C22, C23: 10p; C_0603; Voltage_in_V 25; Tolerance_in_pct 5; MPN CC0603JRNPO8BN100; Mouser 603-CC0603JRNP8BN100
X1: 25M; VXM7; MPN VXM7-9032-25M0000000; Digikey 150-VXM7-9032-25M0000000CT-ND

Connections of its further copies:
/switch/switch_power/xtal_switch/Pin1: C22.1, X1.1; also elsewhere on the board
/switch/switch_power/xtal_switch/Pin2: C23.1, X1.3; also elsewhere on the board
GND: C22.2, C23.2, X1.2, X1.4; also elsewhere on the board

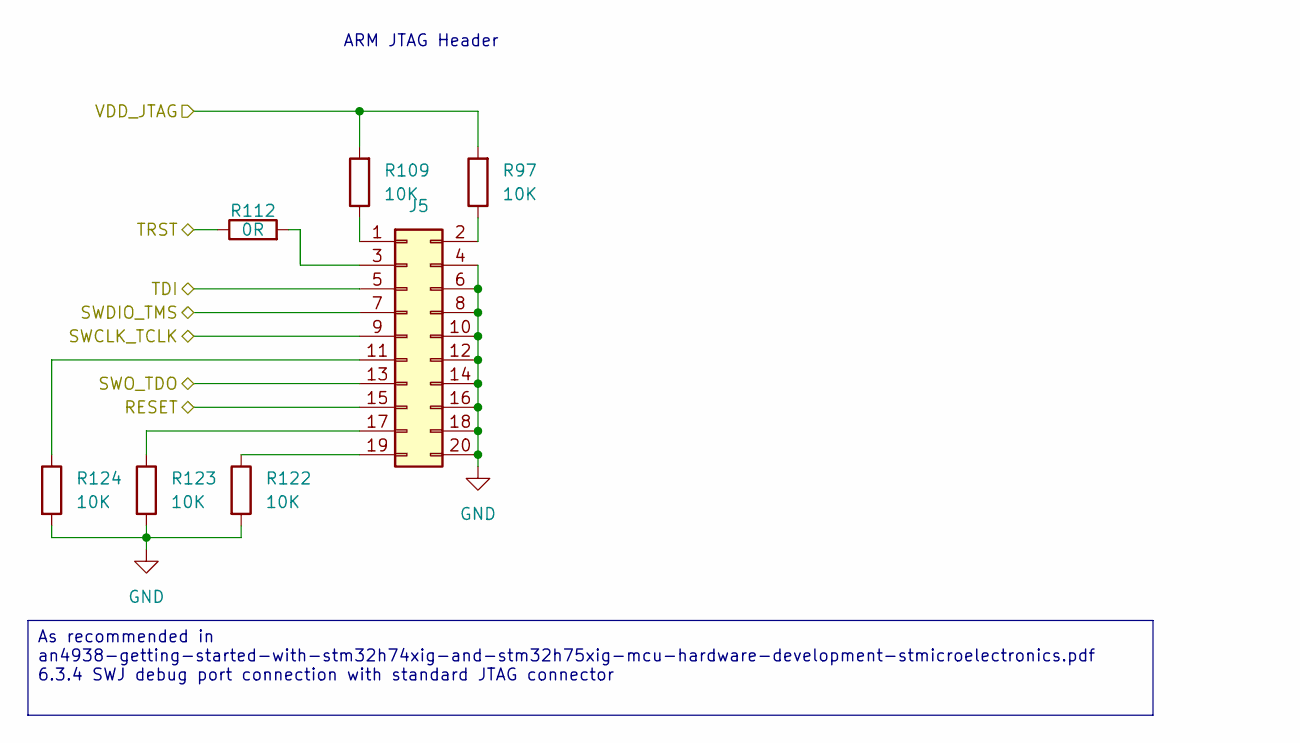
[picture p10: schematic jtag_header_arm.kicad_sch, STM32 JTAG Header]

Parts:
J5: Header_10x02_2.54mm_2.54mm_Straight; 10x02_2.54mm_Header; MPN BHR-20-VUA; Mouser 737-BHR-20-VUA
R97, R109, R122, R123, R124: 10K; R_0603; Tolerance_in_pct 5; MPN CRCW060310K0JNEC; Mouser 71-CRCW060310K0JNEC
R112: 0R; R_0603; Tolerance_in_pct 5; MPN RC0603JR-070RP; Mouser 603-RC0603JR-070RP

Connections:
/controller/RST_STM_JTAG: J5.15; also elsewhere on the board
/controller/SWCLK_TCLK_STM_JTAG: J5.9; also elsewhere on the board
/controller/SWDIO_TMS_JTM_JTAG: J5.7; also elsewhere on the board
/controller/SWO_TDO_STM_JTAG: J5.13; also elsewhere on the board
/controller/TDI_STM_JTAG: J5.5; also elsewhere on the board
/controller/TRST_STM_JTAG: R112.1; also elsewhere on the board
/controller/VDD_CTRL: R97.2, R109.2; also elsewhere on the board
GND: J5.4, J5.6, J5.8, J5.10, J5.12, J5.14, J5.16, J5.18, J5.20, R122.2, R123.2, R124.2; also elsewhere on the board
unnamed: J5.1, R109.1
unnamed: J5.2, R97.1
unnamed: J5.3, R112.2
unnamed: J5.11, R124.1
unnamed: J5.17, R123.1
unnamed: J5.19, R122.1

Notes on the sheet:
ARM JTAG Header
As recommended in an4938-getting-started-with-stm32h74xig-and-stm32h75xig-mcu-hardware-development-stmicroelectronics.pdf 6.3.4 SWJ debug port connection with standard JTAG connector

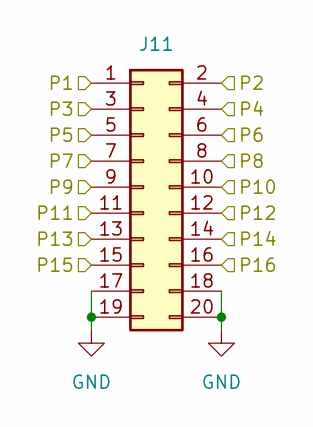
[picture p11: schematic stm_dbg_header.kicad_sch]

Parts:
J11: Header_10x02_2.54mm_2.54mm_Straight; 10x02_2.54mm_Header; MPN BHR-20-VUA; Mouser 737-BHR-20-VUA

Connections:
/controller/debug_header/P1: J11.1; also elsewhere on the board
/controller/debug_header/P2: J11.2; also elsewhere on the board
/controller/debug_header/P3: J11.3; also elsewhere on the board
/controller/debug_header/P4: J11.4; also elsewhere on the board
/controller/debug_header/P5: J11.5; also elsewhere on the board
/controller/debug_header/P6: J11.6; also elsewhere on the board
/controller/debug_header/P7: J11.7; also elsewhere on the board
/controller/debug_header/P8: J11.8; also elsewhere on the board
/controller/debug_header/P9: J11.9; also elsewhere on the board
/controller/debug_header/P10: J11.10; also elsewhere on the board
/controller/debug_header/P11: J11.11; also elsewhere on the board
/controller/debug_header/P12: J11.12; also elsewhere on the board
/controller/debug_header/P13: J11.13; also elsewhere on the board
/controller/debug_header/P14: J11.14; also elsewhere on the board
/controller/debug_header/P15: J11.15; also elsewhere on the board
/controller/debug_header/P16: J11.16; also elsewhere on the board
GND: J11.17, J11.18, J11.19, J11.20; also elsewhere on the board

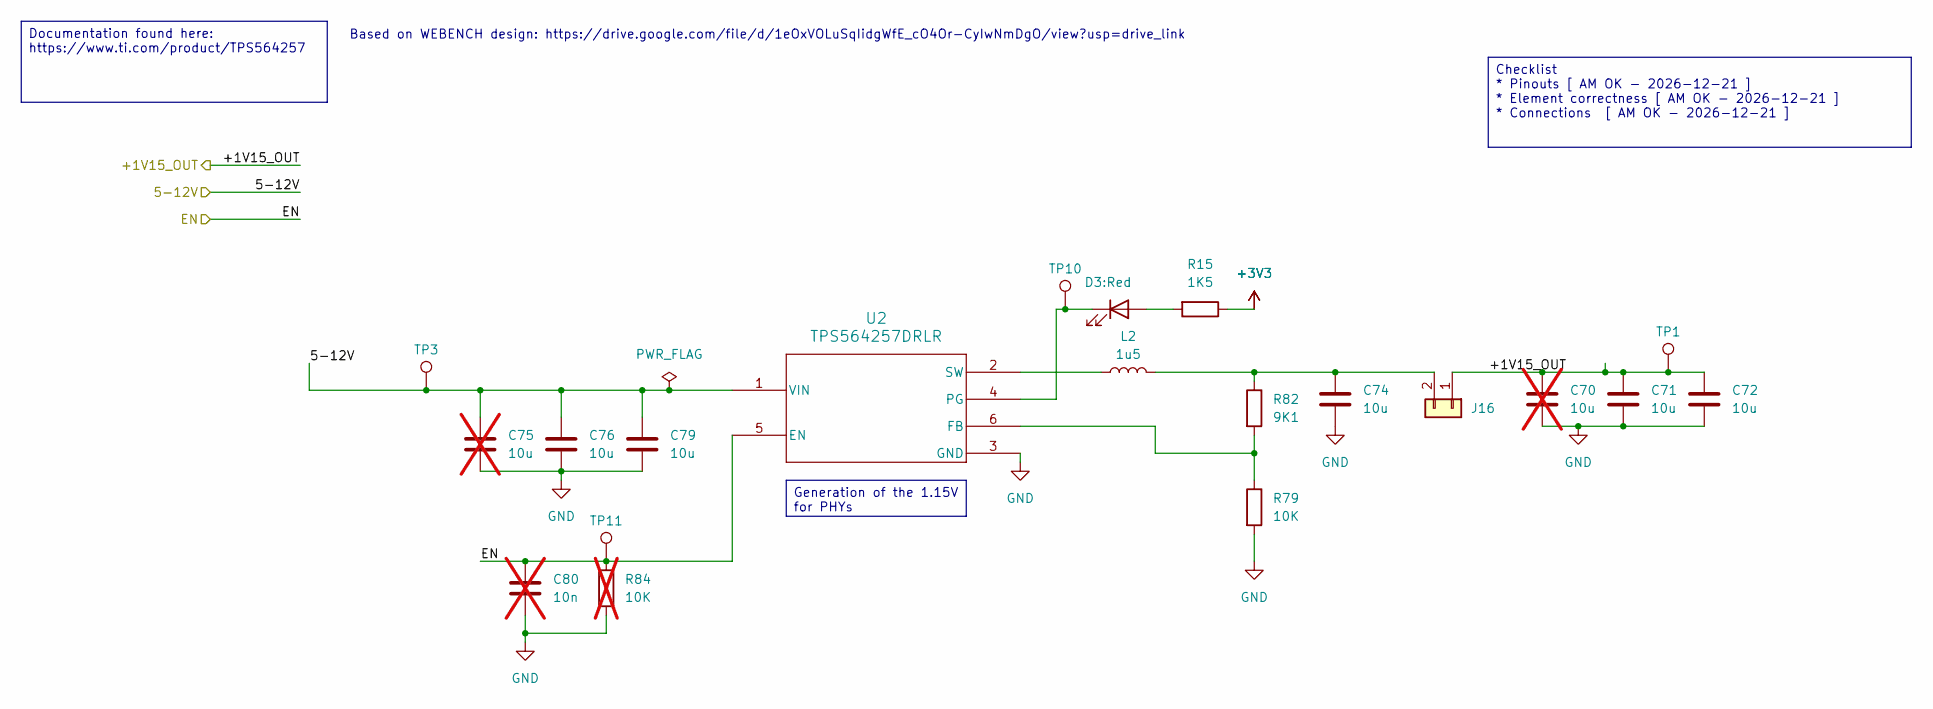
[picture p12: schematic buck_1v15.kicad_sch, Switch 1V15 Power Rail]

Parts:
C70, C75: 10u; C_0603; Voltage_in_V 25; Tolerance_in_pct 20; MPN CL10A106MA8NRNC; Mouser 187-CL10A106MA8NRNC; not fitted
C71, C72, C74, C76, C79: 10u; C_0603; Voltage_in_V 25; Tolerance_in_pct 20; MPN CL10A106MA8NRNC; Mouser 187-CL10A106MA8NRNC
C80: 10n; C_0603; Voltage_in_V 50; Tolerance_in_pct 10; MPN CL10B103KB8WPND; Mouser 187-CL10B103KB8WPND; not fitted
D3: LED_{color}_{U_F}_{I_F}; LED_0603; MPN LTST-C194KRKT; Mouser 859-LTST-C194KRKT
J16: Header_02x01_2.54mm_0mm_Straight; 02x01_2.54mm_Header; MPN 87224-2; Mouser 571-872242
L2: 1u5; SRP7050WA-1R5M; Tolerance_in_pct 20; MPN SRP7050WA-1R5M; Digikey 118-SRP7050WA-1R5MCT-ND
R15: 1K5; R_0603; Tolerance_in_pct 5; MPN AC0603JR-071K5L; Mouser 603-AC0603JR-071K5L
R79: 10K; R_0603; Tolerance_in_pct 5; MPN CRCW060310K0JNEC; Mouser 71-CRCW060310K0JNEC
R82: 9K1; R_0603; Tolerance_in_pct 1; MPN RC0603FR-079K1L; Mouser 603-RC0603FR-079K1L
R84: 10K; R_0603; Tolerance_in_pct 5; MPN CRCW060310K0JNEC; Mouser 71-CRCW060310K0JNEC; not fitted
TP1, TP3, TP10, TP11: TestPoint
U2: TPS564257DRLR; SOT-563; MPN TPS564257DRLR; Mouser 595-TPS564257DRLR

Connections:
+3V3: C80.1, R15.1, R84.1, TP11.1 (1_1), U2.5 (EN); also elsewhere on the board
/5-12V_INPUT: C75.1, C76.1, C79.1, TP3.1 (1_1), U2.1 (VIN); also elsewhere on the board
/switch/1V15_BUCK-OUT: C70.1, C71.1, C72.1, J16.1, TP1.1 (1_1); also elsewhere on the board
GND: C70.2, C71.2, C72.2, C74.2, C75.2, C76.2, C79.2, C80.2, R79.2, R84.2, U2.3 (GND); also elsewhere on the board
unnamed: D3.2 (A), R15.2
unnamed: D3.1 (K), TP10.1 (1_1), U2.4 (PG)
unnamed: C74.1, J16.2, L2.2, R82.1
unnamed: R79.1, R82.2, U2.6 (FB)
unnamed: L2.1, U2.2 (SW)

Notes on the sheet:
Based on WEBENCH design: https://drive.google.com/file/d/1eOxVOLuSqIidgWfE_cO4Or-CyIwNmDgO/view?usp=drive_link
Documentation found here: https://www.ti.com/product/TPS564257
Generation of the 1.15V for PHYs
Checklist * Pinouts [ AM OK - 2026-12-21 ] * Element correctness [ AM OK - 2026-12-21 ] * Connections [ AM OK - 2026-12-21 ]
