kebag-logic/shish-lan/shish-lan.kicad_pcb

## KiCad design shish-lan.kicad_pcb (continued)

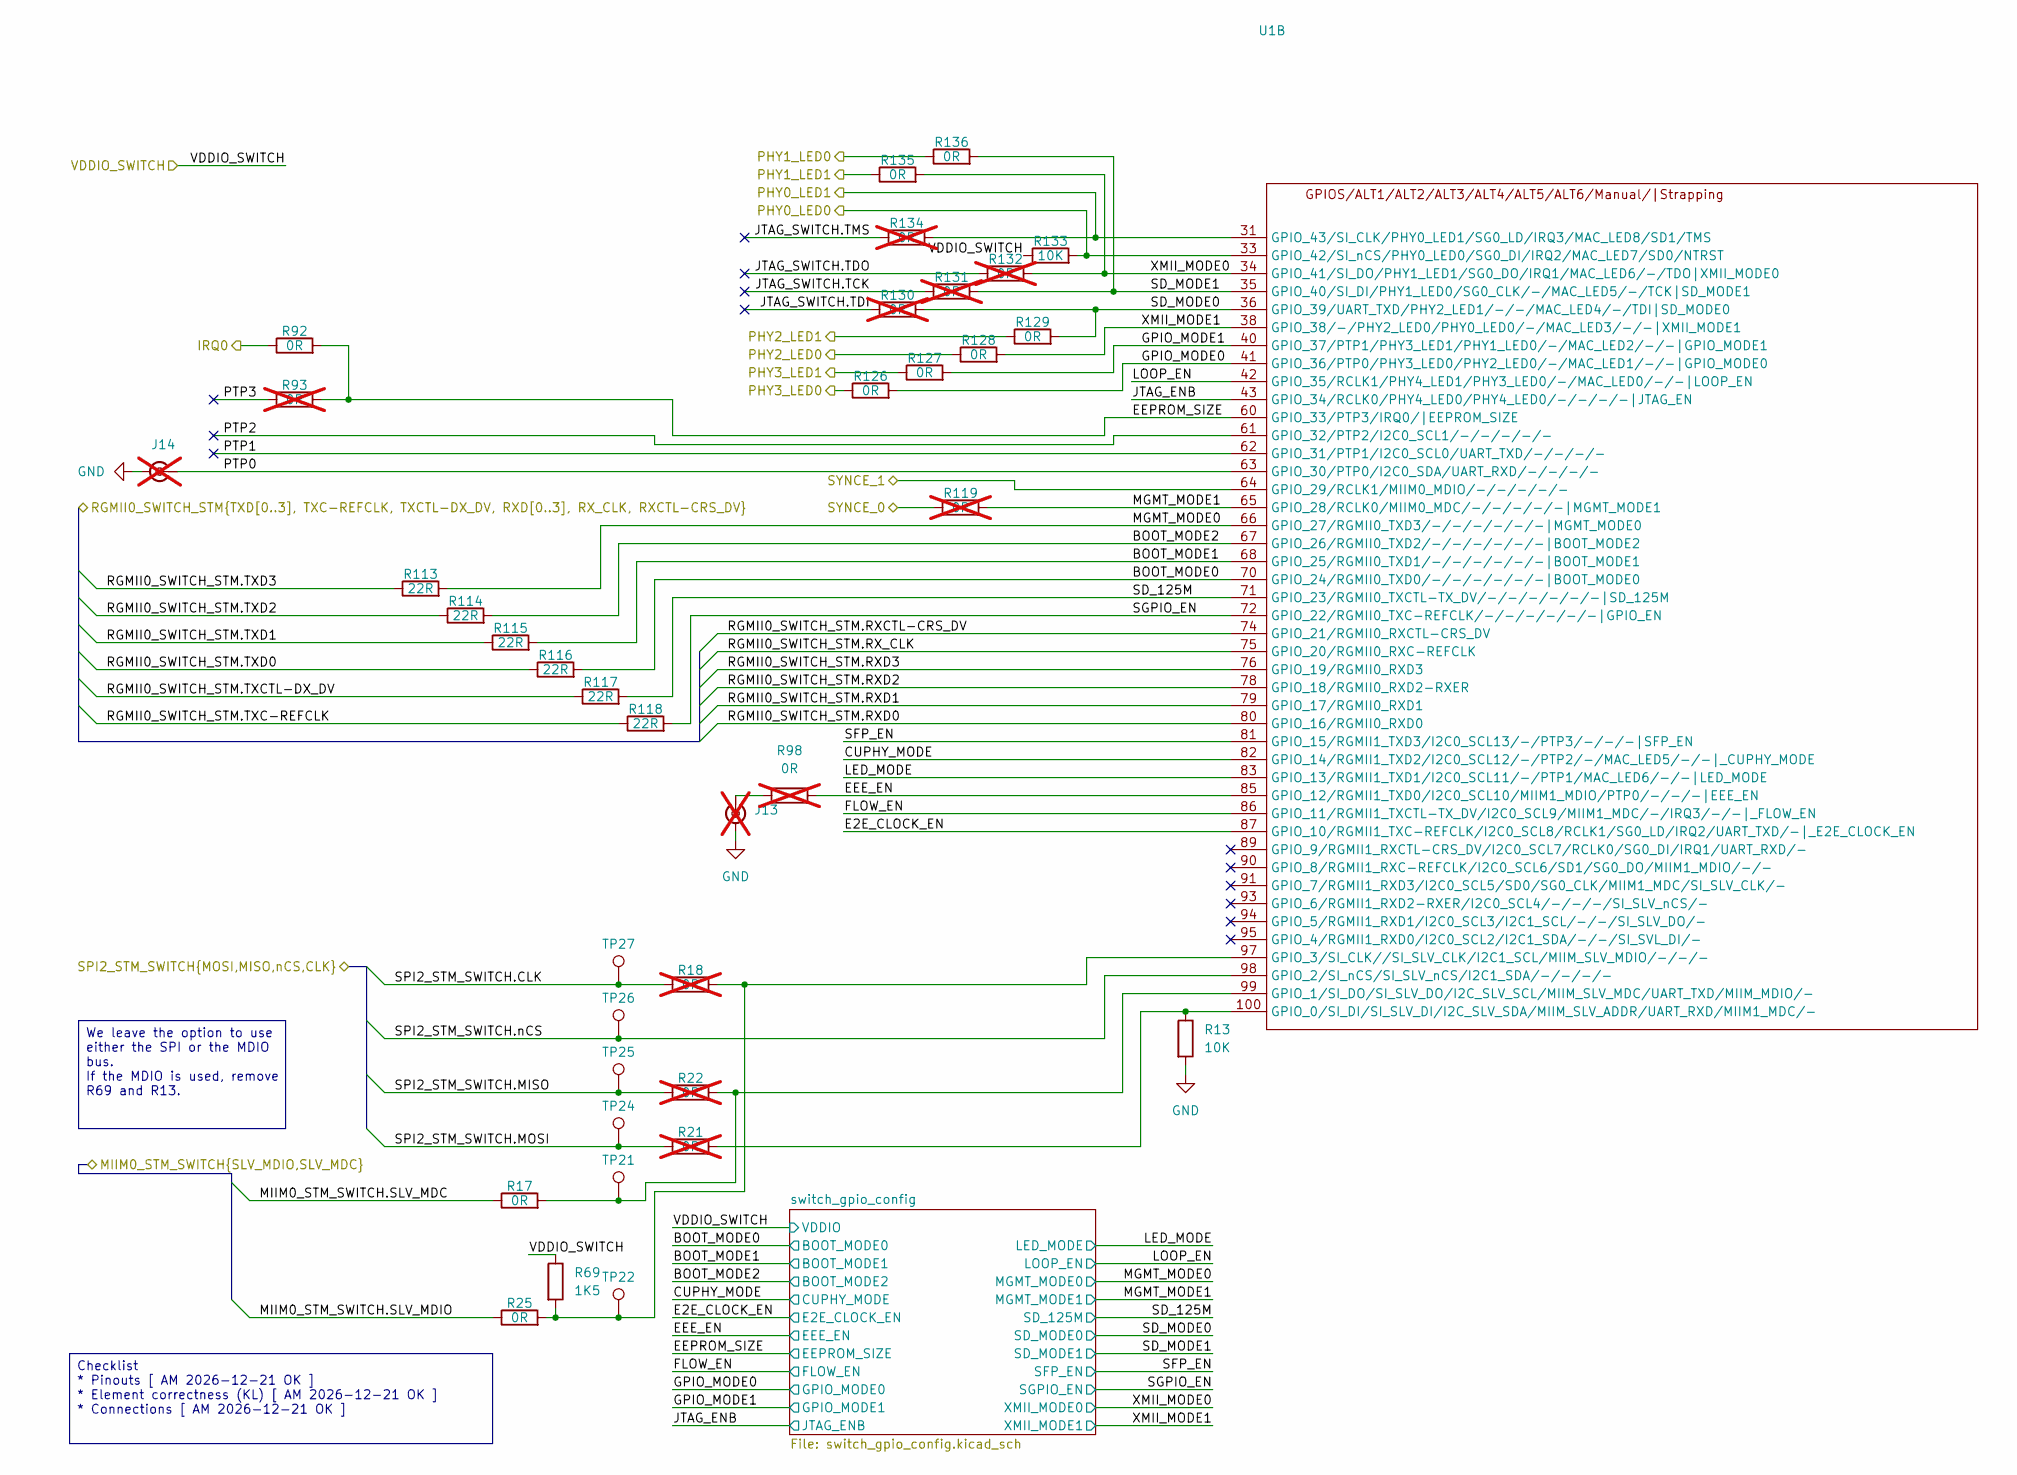
[picture p13: schematic switch_gpios.kicad_sch, Switch GPIOs and Strapping]

Parts:
J13, J14: SMA; SMA_Right_Angle; MPN RFPC-SMA27-F; Mouser 640-RFPCSMA27F; not fitted
R13, R133: 10K; R_0603; Tolerance_in_pct 5; MPN CRCW060310K0JNEC; Mouser 71-CRCW060310K0JNEC
R17, R25, R92, R126, R127, R128, R129, R135, R136: 0R; R_0603; Tolerance_in_pct 5; MPN RC0603JR-070RP; Mouser 603-RC0603JR-070RP
R18, R21, R22, R93, R98, R119, R130, R131, R132, R134: 0R; R_0603; Tolerance_in_pct 5; MPN RC0603JR-070RP; Mouser 603-RC0603JR-070RP; not fitted
R69: 1K5; R_0603; Tolerance_in_pct 5; MPN AC0603JR-071K5L; Mouser 603-AC0603JR-071K5L
R113, R114, R115, R116, R117, R118: 22R; R_0603; Tolerance_in_pct 1; MPN RC0603FR-1022RL; Mouser 603-RC0603FR-1022RL
TP21, TP22, TP24, TP25, TP26, TP27: TestPoint
U1: LAN96455F-I/8MW; TQFP-128_14x14mm_P0.4mm; MPN LAN96455F-I/8MW; Mouser 579-LAN96455FI8MW

Connections:
+3V3: R69.1, R133.1; also elsewhere on the board
/controller/MIIM0_STM_SWITCH.SLV_MDC: R17.1; also elsewhere on the board
/controller/MIIM0_STM_SWITCH.SLV_MDIO: R25.1; also elsewhere on the board
/controller/RGMII0_SWITCH_STM.RXCTL-CRS_DV: U1.74 (GPIO_21/RGMII0_RXCTL-CRS_DV); also elsewhere on the board
/controller/RGMII0_SWITCH_STM.RXD0: U1.80 (GPIO_16/RGMII0_RXD0); also elsewhere on the board
/controller/RGMII0_SWITCH_STM.RXD1: U1.79 (GPIO_17/RGMII0_RXD1); also elsewhere on the board
/controller/RGMII0_SWITCH_STM.RXD2: U1.78 (GPIO_18/RGMII0_RXD2-RXER); also elsewhere on the board
/controller/RGMII0_SWITCH_STM.RXD3: U1.76 (GPIO_19/RGMII0_RXD3); also elsewhere on the board
/controller/RGMII0_SWITCH_STM.RX_CLK: U1.75 (GPIO_20/RGMII0_RXC-REFCLK); also elsewhere on the board
/controller/RGMII0_SWITCH_STM.TXC-REFCLK: R118.1; also elsewhere on the board
/controller/RGMII0_SWITCH_STM.TXCTL-DX_DV: R117.1; also elsewhere on the board
/controller/RGMII0_SWITCH_STM.TXD0: R116.1; also elsewhere on the board
/controller/RGMII0_SWITCH_STM.TXD1: R115.1; also elsewhere on the board
/controller/RGMII0_SWITCH_STM.TXD2: R114.1; also elsewhere on the board
/controller/RGMII0_SWITCH_STM.TXD3: R113.1; also elsewhere on the board
/controller/SPI2_STM_SWITCH.CLK: R18.1, TP27.1 (1_1); also elsewhere on the board
/controller/SPI2_STM_SWITCH.MISO: R22.1, TP25.1 (1_1); also elsewhere on the board
/controller/SPI2_STM_SWITCH.MOSI: R21.1, TP24.1 (1_1); also elsewhere on the board
/controller/SPI2_STM_SWITCH.nCS: TP26.1 (1_1), U1.98 (GPIO_2/SI_nCS/SI_SLV_nCS/I2C1_SDA/-/-/-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); also elsewhere on the board
/switch/IRQ0_SWITCH_TO_STM: R92.1; also elsewhere on the board
/switch/switch_gpios/BOOT_MODE0: R116.2, U1.70 (GPIO_24/RGMII0_TXD0/-/-/-/-/-/-|BOOT_MO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); also elsewhere on the board
/switch/switch_gpios/BOOT_MODE1: R115.2, U1.68 (GPIO_25/RGMII0_TXD1/-/-/-/-/-/-|BOOT_MO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); also elsewhere on the board
/switch/switch_gpios/BOOT_MODE2: R114.2, U1.67 (GPIO_26/RGMII0_TXD2/-/-/-/-/-/-|BOOT_MO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); also elsewhere on the board
/switch/switch_gpios/CUPHY_MODE: U1.82 (GPIO_14/RGMII1_TXD2/I2C0_SCL12/-/PTP2/-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); also elsewhere on the board
/switch/switch_gpios/E2E_CLOCK_EN: U1.87 (GPIO_10/RGMII1_TXC-REFCLK/I2C0_SCL8/RCL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); also elsewhere on the board
/switch/switch_gpios/EEE_EN: R98.2, U1.85 (GPIO_12/RGMII1_TXD0/I2C0_SCL10/MIIM1_MD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); also elsewhere on the board
/switch/switch_gpios/EEPROM_SIZE: R92.2, R93.2, U1.60 (GPIO_33/PTP3/IRQ0/|EEPROM_SIZE); also elsewhere on the board
/switch/switch_gpios/FLOW_EN: U1.86 (GPIO_11/RGMII1_TXCTL-TX_DV/I2C0_SCL9/MI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); also elsewhere on the board
/switch/switch_gpios/GPIO_MODE0: R126.2, U1.41 (GPIO_36/PTP0/PHY3_LED0/PHY2_LED0/-/MAC_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); also elsewhere on the board
/switch/switch_gpios/GPIO_MODE1: R127.2, U1.40 (GPIO_37/PTP1/PHY3_LED1/PHY1_LED0/-/MAC_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); also elsewhere on the board
/switch/switch_gpios/JTAG_ENB: U1.43 (GPIO_34/RCLK0/PHY4_LED0/PHY4_LED0/-/-/-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); also elsewhere on the board
/switch/switch_gpios/JTAG_SWITCH.TCK: R131.1
/switch/switch_gpios/JTAG_SWITCH.TDI: R130.1
/switch/switch_gpios/JTAG_SWITCH.TDO: R132.1
/switch/switch_gpios/JTAG_SWITCH.TMS: R134.1
/switch/switch_gpios/LED_MODE: U1.83 (GPIO_13/RGMII1_TXD1/I2C0_SCL11/-/PTP1/M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); also elsewhere on the board
/switch/switch_gpios/LOOP_EN: U1.42 (GPIO_35/RCLK1/PHY4_LED1/PHY3_LED0/-/MAC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); also elsewhere on the board
/switch/switch_gpios/MGMT_MODE0: R113.2, U1.66 (GPIO_27/RGMII0_TXD3/-/-/-/-/-/-|MGMT_MO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); also elsewhere on the board
/switch/switch_gpios/MGMT_MODE1: R119.2, U1.65 (GPIO_28/RCLK0/MIIM0_MDC/-/-/-/-/-|MGMT_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); also elsewhere on the board
/switch/switch_gpios/PHY0_LED0: R133.2, U1.33 (GPIO_42/SI_nCS/PHY0_LED0/SG0_DI/IRQ2/MA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); also elsewhere on the board
/switch/switch_gpios/PHY0_LED1: R134.2, U1.31 (GPIO_43/SI_CLK/PHY0_LED1/SG0_LD/IRQ3/MA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); also elsewhere on the board
/switch/switch_gpios/PHY1_LED0: R136.1; also elsewhere on the board
/switch/switch_gpios/PHY1_LED1: R135.1; also elsewhere on the board
/switch/switch_gpios/PHY2_LED0: R128.1; also elsewhere on the board
/switch/switch_gpios/PHY2_LED1: R129.1; also elsewhere on the board
/switch/switch_gpios/PHY3_LED0: R126.1; also elsewhere on the board
/switch/switch_gpios/PHY3_LED1: R127.1; also elsewhere on the board
/switch/switch_gpios/PTP0: J14.1 (In), U1.63 (GPIO_30/PTP0/I2C0_SDA/UART_RXD/-/-/-/-)
/switch/switch_gpios/PTP1: U1.62 (GPIO_31/PTP1/I2C0_SCL0/UART_TXD/-/-/-/-)
/switch/switch_gpios/PTP2: U1.61 (GPIO_32/PTP2/I2C0_SCL1/-/-/-/-/-)
/switch/switch_gpios/PTP3: R93.1
/switch/switch_gpios/SD_125M: R117.2, U1.71 (GPIO_23/RGMII0_TXCTL-TX_DV/-/-/-/-/-/-|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); also elsewhere on the board
/switch/switch_gpios/SD_MODE0: R129.2, R130.2, U1.36 (GPIO_39/UART_TXD/PHY2_LED1/-/-/MAC_LED4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); also elsewhere on the board
/switch/switch_gpios/SD_MODE1: R131.2, R136.2, U1.35 (GPIO_40/SI_DI/PHY1_LED0/SG0_CLK/-/MAC_L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); also elsewhere on the board
/switch/switch_gpios/SFP_EN: U1.81 (GPIO_15/RGMII1_TXD3/I2C0_SCL13/-/PTP3/-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); also elsewhere on the board
/switch/switch_gpios/SGPIO_EN: R118.2, U1.72 (GPIO_22/RGMII0_TXC-REFCLK/-/-/-/-/-/-|G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); also elsewhere on the board
/switch/switch_gpios/SYNCE_0: R119.1; also elsewhere on the board
/switch/switch_gpios/SYNCE_1: U1.64 (GPIO_29/RCLK1/MIIM0_MDIO/-/-/-/-/-); also elsewhere on the board
/switch/switch_gpios/XMII_MODE0: R132.2, R135.2, U1.34 (GPIO_41/SI_DO/PHY1_LED1/SG0_DO/IRQ1/MAC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); also elsewhere on the board
/switch/switch_gpios/XMII_MODE1: R128.2, U1.38 (GPIO_38/-/PHY2_LED0/PHY0_LED0/-/MAC_LED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); also elsewhere on the board
GND: J13.2 (Ext), J14.2 (Ext), R13.2; also elsewhere on the board
unnamed: J13.1 (In), R98.1
unnamed: R13.1, R21.2, U1.100 (GPIO_0/SI_DI/SI_SLV_DI/I2C_SLV_SDA/MIIM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)
unnamed: R17.2, R22.2, TP21.1 (1_1), U1.99 (GPIO_1/SI_DO/SI_SLV_DO/I2C_SLV_SCL/MIIM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)
unnamed: R18.2, R25.2, R69.2, TP22.1 (1_1), U1.97 (GPIO_3/SI_CLK//SI_SLV_CLK/I2C1_SCL/MIIM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)

Notes on the sheet:
Checklist * Pinouts [ AM 2026-12-21 OK ] * Element correctness (KL) [ AM 2026-12-21 OK ] * Connections [ AM 2026-12-21 OK ]
We leave the option to use either the SPI or the MDIO bus. If the MDIO is used, remove R69 and R13.

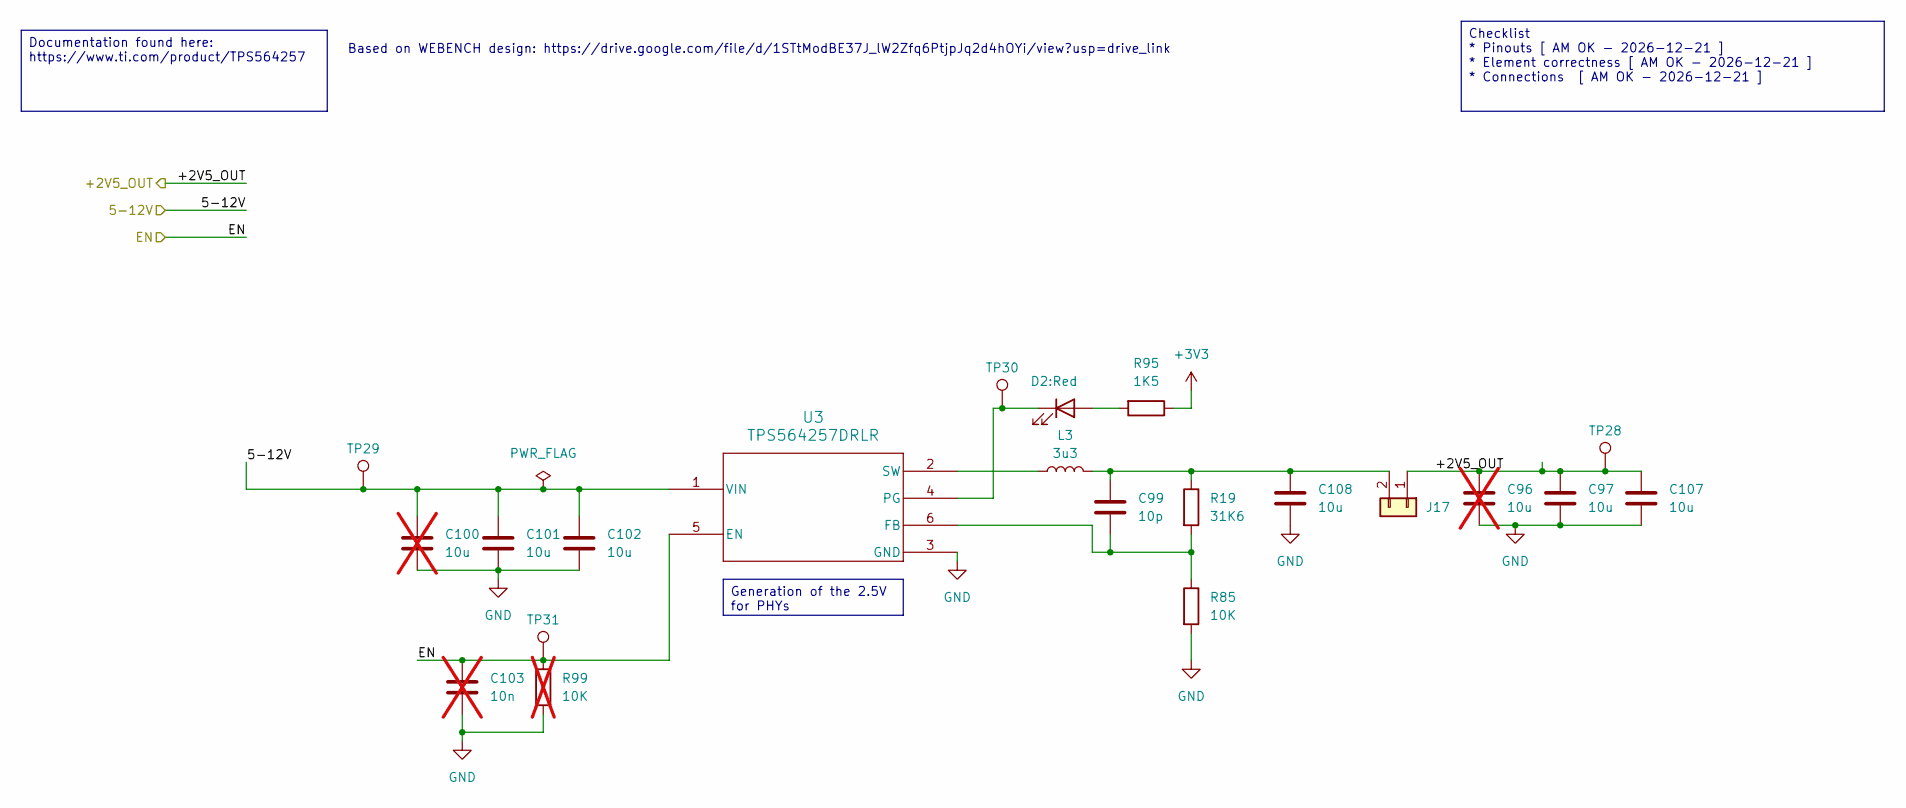
[picture p14: schematic buck_2v5.kicad_sch, Switch 2.5V Power Rail]

Parts:
C96, C100: 10u; C_0603; Voltage_in_V 25; Tolerance_in_pct 20; MPN CL10A106MA8NRNC; Mouser 187-CL10A106MA8NRNC; not fitted
C97, C101, C102, C107, C108: 10u; C_0603; Voltage_in_V 25; Tolerance_in_pct 20; MPN CL10A106MA8NRNC; Mouser 187-CL10A106MA8NRNC
C99: 10p; C_0603; Voltage_in_V 25; Tolerance_in_pct 5; MPN CC0603JRNPO8BN100; Mouser 603-CC0603JRNP8BN100
C103: 10n; C_0603; Voltage_in_V 50; Tolerance_in_pct 10; MPN CL10B103KB8WPND; Mouser 187-CL10B103KB8WPND; not fitted
D2: LED_{color}_{U_F}_{I_F}; LED_0603; MPN LTST-C194KRKT; Mouser 859-LTST-C194KRKT
J17: Header_02x01_2.54mm_0mm_Straight; 02x01_2.54mm_Header; MPN 87224-2; Mouser 571-872242
L3: 3u3; EXLA1V0603; Tolerance_in_pct 20; MPN EXLA1V0603-3R3-R; Digikey 283-EXLA1V0603-3R3-RCT-ND
R19: 31K6; R_0603; Tolerance_in_pct 1; MPN CRCW060331K6FKEA; Mouser 71-CRCW0603-31.6K-E3
R85: 10K; R_0603; Tolerance_in_pct 1; MPN RC0603FR-0710KL; Mouser 603-RC0603FR-0710KL
R95: 1K5; R_0603; Tolerance_in_pct 5; MPN AC0603JR-071K5L; Mouser 603-AC0603JR-071K5L
R99: 10K; R_0603; Tolerance_in_pct 5; MPN CRCW060310K0JNEC; Mouser 71-CRCW060310K0JNEC; not fitted
TP28, TP29, TP30, TP31: TestPoint
U3: TPS564257DRLR; SOT-563; MPN TPS564257DRLR; Mouser 595-TPS564257DRLR

Connections:
+3V3: C103.1, R95.1, R99.1, TP31.1 (1_1), U3.5 (EN); also elsewhere on the board
/5-12V_INPUT: C100.1, C101.1, C102.1, TP29.1 (1_1), U3.1 (VIN); also elsewhere on the board
/switch/2V5_BUCK-OUT: C96.1, C97.1, C107.1, J17.1, TP28.1 (1_1); also elsewhere on the board
GND: C96.2, C97.2, C100.2, C101.2, C102.2, C103.2, C107.2, C108.2, R85.2, R99.2, U3.3 (GND); also elsewhere on the board
unnamed: D2.2 (A), R95.2
unnamed: D2.1 (K), TP30.1 (1_1), U3.4 (PG)
unnamed: C99.1, C108.1, J17.2, L3.2, R19.1
unnamed: C99.2, R19.2, R85.1, U3.6 (FB)
unnamed: L3.1, U3.2 (SW)

Notes on the sheet:
Based on WEBENCH design: https://drive.google.com/file/d/1STtModBE37J_lW2Zfq6PtjpJq2d4hOYi/view?usp=drive_link
Checklist * Pinouts [ AM OK - 2026-12-21 ] * Element correctness [ AM OK - 2026-12-21 ] * Connections [ AM OK - 2026-12-21 ]
Documentation found here: https://www.ti.com/product/TPS564257
Generation of the 2.5V for PHYs

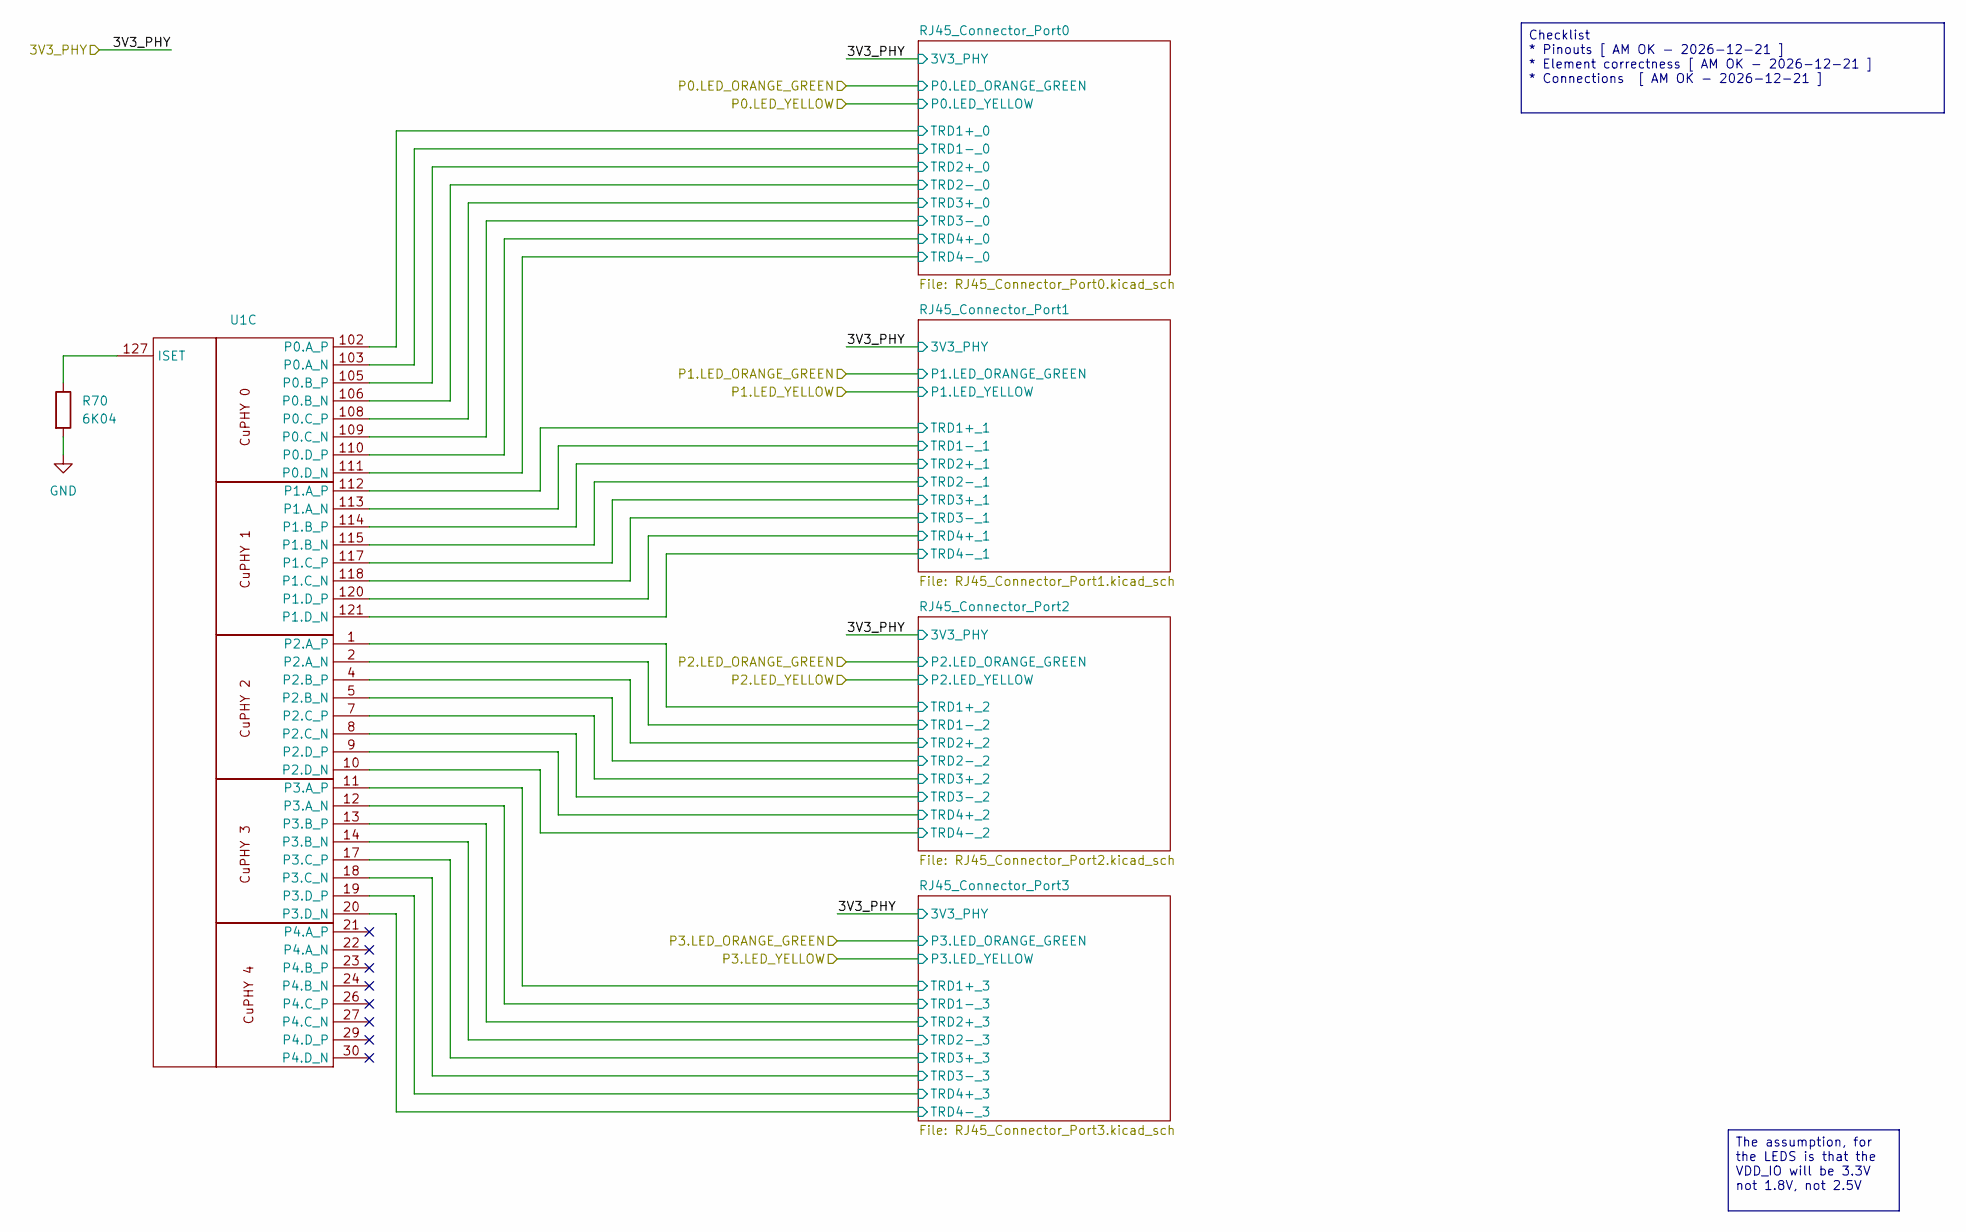
[picture p15: schematic switch_phys.kicad_sch, Switch CuPHys to Jack Connections]

Parts:
R70: 6K04; R_0603; Tolerance_in_pct 1; MPN RMCF0603FT6K04; Mouser 708-RMCF0603FT6K04
U1: LAN96455F-I/8MW; TQFP-128_14x14mm_P0.4mm; MPN LAN96455F-I/8MW; Mouser 579-LAN96455FI8MW

Connections:
/switch/switch_phys/RJ45_Connector_Port0/TRD1+_0: U1.102 (P0.A_P); also elsewhere on the board
/switch/switch_phys/RJ45_Connector_Port0/TRD1-_0: U1.103 (P0.A_N); also elsewhere on the board
/switch/switch_phys/RJ45_Connector_Port0/TRD2+_0: U1.105 (P0.B_P); also elsewhere on the board
/switch/switch_phys/RJ45_Connector_Port0/TRD2-_0: U1.106 (P0.B_N); also elsewhere on the board
/switch/switch_phys/RJ45_Connector_Port0/TRD3+_0: U1.108 (P0.C_P); also elsewhere on the board
/switch/switch_phys/RJ45_Connector_Port0/TRD3-_0: U1.109 (P0.C_N); also elsewhere on the board
/switch/switch_phys/RJ45_Connector_Port0/TRD4+_0: U1.110 (P0.D_P); also elsewhere on the board
/switch/switch_phys/RJ45_Connector_Port0/TRD4-_0: U1.111 (P0.D_N); also elsewhere on the board
/switch/switch_phys/RJ45_Connector_Port1/TRD1+_1: U1.112 (P1.A_P); also elsewhere on the board
/switch/switch_phys/RJ45_Connector_Port1/TRD1-_1: U1.113 (P1.A_N); also elsewhere on the board
/switch/switch_phys/RJ45_Connector_Port1/TRD2+_1: U1.114 (P1.B_P); also elsewhere on the board
/switch/switch_phys/RJ45_Connector_Port1/TRD2-_1: U1.115 (P1.B_N); also elsewhere on the board
/switch/switch_phys/RJ45_Connector_Port1/TRD3+_1: U1.117 (P1.C_P); also elsewhere on the board
/switch/switch_phys/RJ45_Connector_Port1/TRD3-_1: U1.118 (P1.C_N); also elsewhere on the board
/switch/switch_phys/RJ45_Connector_Port1/TRD4+_1: U1.120 (P1.D_P); also elsewhere on the board
/switch/switch_phys/RJ45_Connector_Port1/TRD4-_1: U1.121 (P1.D_N); also elsewhere on the board
/switch/switch_phys/RJ45_Connector_Port2/TRD1+_2: U1.1 (P2.A_P); also elsewhere on the board
/switch/switch_phys/RJ45_Connector_Port2/TRD1-_2: U1.2 (P2.A_N); also elsewhere on the board
/switch/switch_phys/RJ45_Connector_Port2/TRD2+_2: U1.4 (P2.B_P); also elsewhere on the board
/switch/switch_phys/RJ45_Connector_Port2/TRD2-_2: U1.5 (P2.B_N); also elsewhere on the board
/switch/switch_phys/RJ45_Connector_Port2/TRD3+_2: U1.7 (P2.C_P); also elsewhere on the board
/switch/switch_phys/RJ45_Connector_Port2/TRD3-_2: U1.8 (P2.C_N); also elsewhere on the board
/switch/switch_phys/RJ45_Connector_Port2/TRD4+_2: U1.9 (P2.D_P); also elsewhere on the board
/switch/switch_phys/RJ45_Connector_Port2/TRD4-_2: U1.10 (P2.D_N); also elsewhere on the board
/switch/switch_phys/RJ45_Connector_Port3/TRD1+_3: U1.11 (P3.A_P); also elsewhere on the board
/switch/switch_phys/RJ45_Connector_Port3/TRD1-_3: U1.12 (P3.A_N); also elsewhere on the board
/switch/switch_phys/RJ45_Connector_Port3/TRD2+_3: U1.13 (P3.B_P); also elsewhere on the board
/switch/switch_phys/RJ45_Connector_Port3/TRD2-_3: U1.14 (P3.B_N); also elsewhere on the board
/switch/switch_phys/RJ45_Connector_Port3/TRD3+_3: U1.17 (P3.C_P); also elsewhere on the board
/switch/switch_phys/RJ45_Connector_Port3/TRD3-_3: U1.18 (P3.C_N); also elsewhere on the board
/switch/switch_phys/RJ45_Connector_Port3/TRD4+_3: U1.19 (P3.D_P); also elsewhere on the board
/switch/switch_phys/RJ45_Connector_Port3/TRD4-_3: U1.20 (P3.D_N); also elsewhere on the board
GND: R70.2; also elsewhere on the board
unnamed: R70.1, U1.127 (ISET)

Notes on the sheet:
Checklist * Pinouts [ AM OK - 2026-12-21 ] * Element correctness [ AM OK - 2026-12-21 ] * Connections [ AM OK - 2026-12-21 ]
The assumption, for the LEDS is that the VDD_IO will be 3.3V not 1.8V, not 2.5V

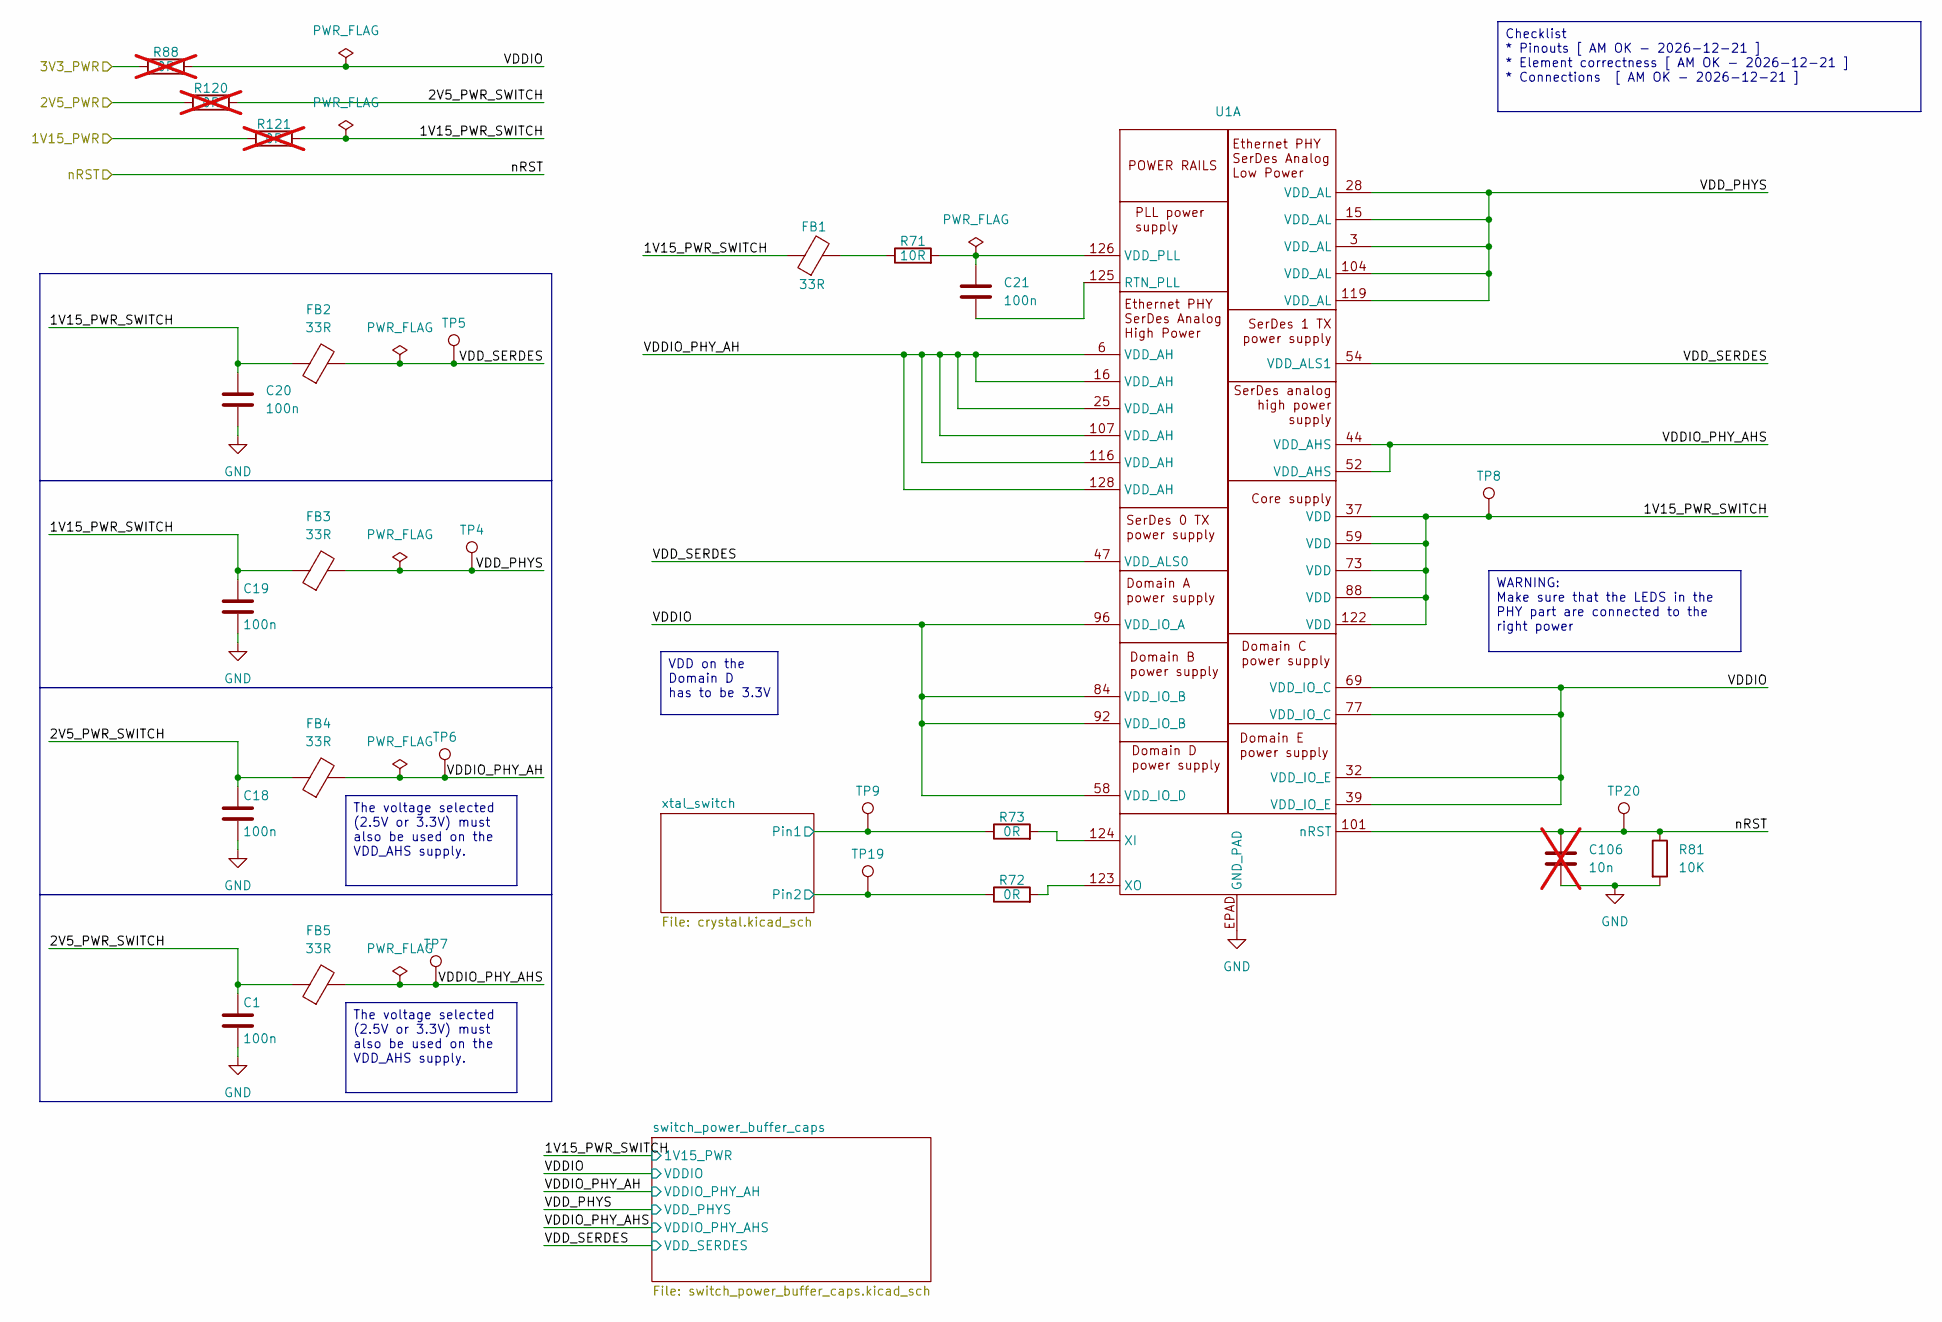
[picture p16: schematic switch_power.kicad_sch, Switch Power Sourcing]

Parts:
C1, C18, C19, C20, C21: 100n; C_0603; Voltage_in_V 50; Tolerance_in_pct 10; MPN CL10B104KB8NNNC; Mouser 187-CL10B104KB8NNNC
C106: 10n; C_0603; Voltage_in_V 50; Tolerance_in_pct 10; MPN CL10B103KB8WPND; Mouser 187-CL10B103KB8WPND; not fitted
FB1, FB2, FB3, FB4, FB5: 33R; FB_0603; MPN BLM18PG330SN1D; Mouser 81-BLM18PG330SN1D
R71: 10R; R_0603; Tolerance_in_pct 0.1; MPN RNCE0603BTE10R0; Mouser 708-RNCE0603BTE10R0
R72, R73: 0R; R_0603; Tolerance_in_pct 5; MPN RC0603JR-070RP; Mouser 603-RC0603JR-070RP
R81: 10K; R_0603; Tolerance_in_pct 5; MPN CRCW060310K0JNEC; Mouser 71-CRCW060310K0JNEC
R88, R120, R121: 0R; R_2512; Tolerance_in_pct 5; MPN CRF2512-J/-000ELF; Mouser 652-CRF2512-J-000ELF; not fitted
TP4, TP5, TP6, TP7, TP8, TP9, TP19, TP20: TestPoint
U1: LAN96455F-I/8MW; TQFP-128_14x14mm_P0.4mm; MPN LAN96455F-I/8MW; Mouser 579-LAN96455FI8MW

Connections:
+3V3: R88.1; also elsewhere on the board
/switch/1V15_BUCK-OUT: R121.1; also elsewhere on the board
/switch/2V5_BUCK-OUT: R120.1; also elsewhere on the board
/switch/nRST_STM_TO_SWITCH: C106.1, R81.1, TP20.1 (1_1), U1.101 (nRST); also elsewhere on the board
/switch/switch_power/1V15_PWR_SWITCH: C19.1, C20.1, FB1.1, FB2.1, FB3.1, R121.2, TP8.1 (1_1), U1.37 (VDD), U1.59 (VDD), U1.73 (VDD), U1.88 (VDD), U1.122 (VDD); also elsewhere on the board
/switch/switch_power/2V5_PWR_SWITCH: C1.1, C18.1, FB4.1, FB5.1, R120.2
/switch/switch_power/VDDIO: R88.2, U1.32 (VDD_IO_E), U1.39 (VDD_IO_E), U1.58 (VDD_IO_D), U1.69 (VDD_IO_C), U1.77 (VDD_IO_C), U1.84 (VDD_IO_B), U1.92 (VDD_IO_B), U1.96 (VDD_IO_A); also elsewhere on the board
/switch/switch_power/VDDIO_PHY_AH: FB4.2, TP6.1 (1_1), U1.6 (VDD_AH), U1.16 (VDD_AH), U1.25 (VDD_AH), U1.107 (VDD_AH), U1.116 (VDD_AH), U1.128 (VDD_AH); also elsewhere on the board
/switch/switch_power/VDDIO_PHY_AHS: FB5.2, TP7.1 (1_1), U1.44 (VDD_AHS), U1.52 (VDD_AHS); also elsewhere on the board
/switch/switch_power/VDD_PHYS: FB3.2, TP4.1 (1_1), U1.3 (VDD_AL), U1.15 (VDD_AL), U1.28 (VDD_AL), U1.104 (VDD_AL), U1.119 (VDD_AL); also elsewhere on the board
/switch/switch_power/VDD_SERDES: FB2.2, TP5.1 (1_1), U1.47 (VDD_ALS0), U1.54 (VDD_ALS1); also elsewhere on the board
/switch/switch_power/xtal_switch/Pin1: R73.1, TP9.1 (1_1); also elsewhere on the board
/switch/switch_power/xtal_switch/Pin2: R72.1, TP19.1 (1_1); also elsewhere on the board
GND: C1.2, C18.2, C19.2, C20.2, C106.2, R81.2, U1.EPAD (GND_PAD); also elsewhere on the board
unnamed: FB1.2, R71.1
unnamed: C21.2, U1.125 (RTN_PLL)
unnamed: C21.1, R71.2, U1.126 (VDD_PLL)
unnamed: R73.2, U1.124 (XI)
unnamed: R72.2, U1.123 (XO)

Notes on the sheet:
WARNING: Make sure that the LEDS in the PHY part are connected to the right power
The voltage selected (2.5V or 3.3V) must also be used on the VDD_AHS supply.
Checklist * Pinouts [ AM OK - 2026-12-21 ] * Element correctness [ AM OK - 2026-12-21 ] * Connections [ AM OK - 2026-12-21 ]
VDD on the Domain D has to be 3.3V

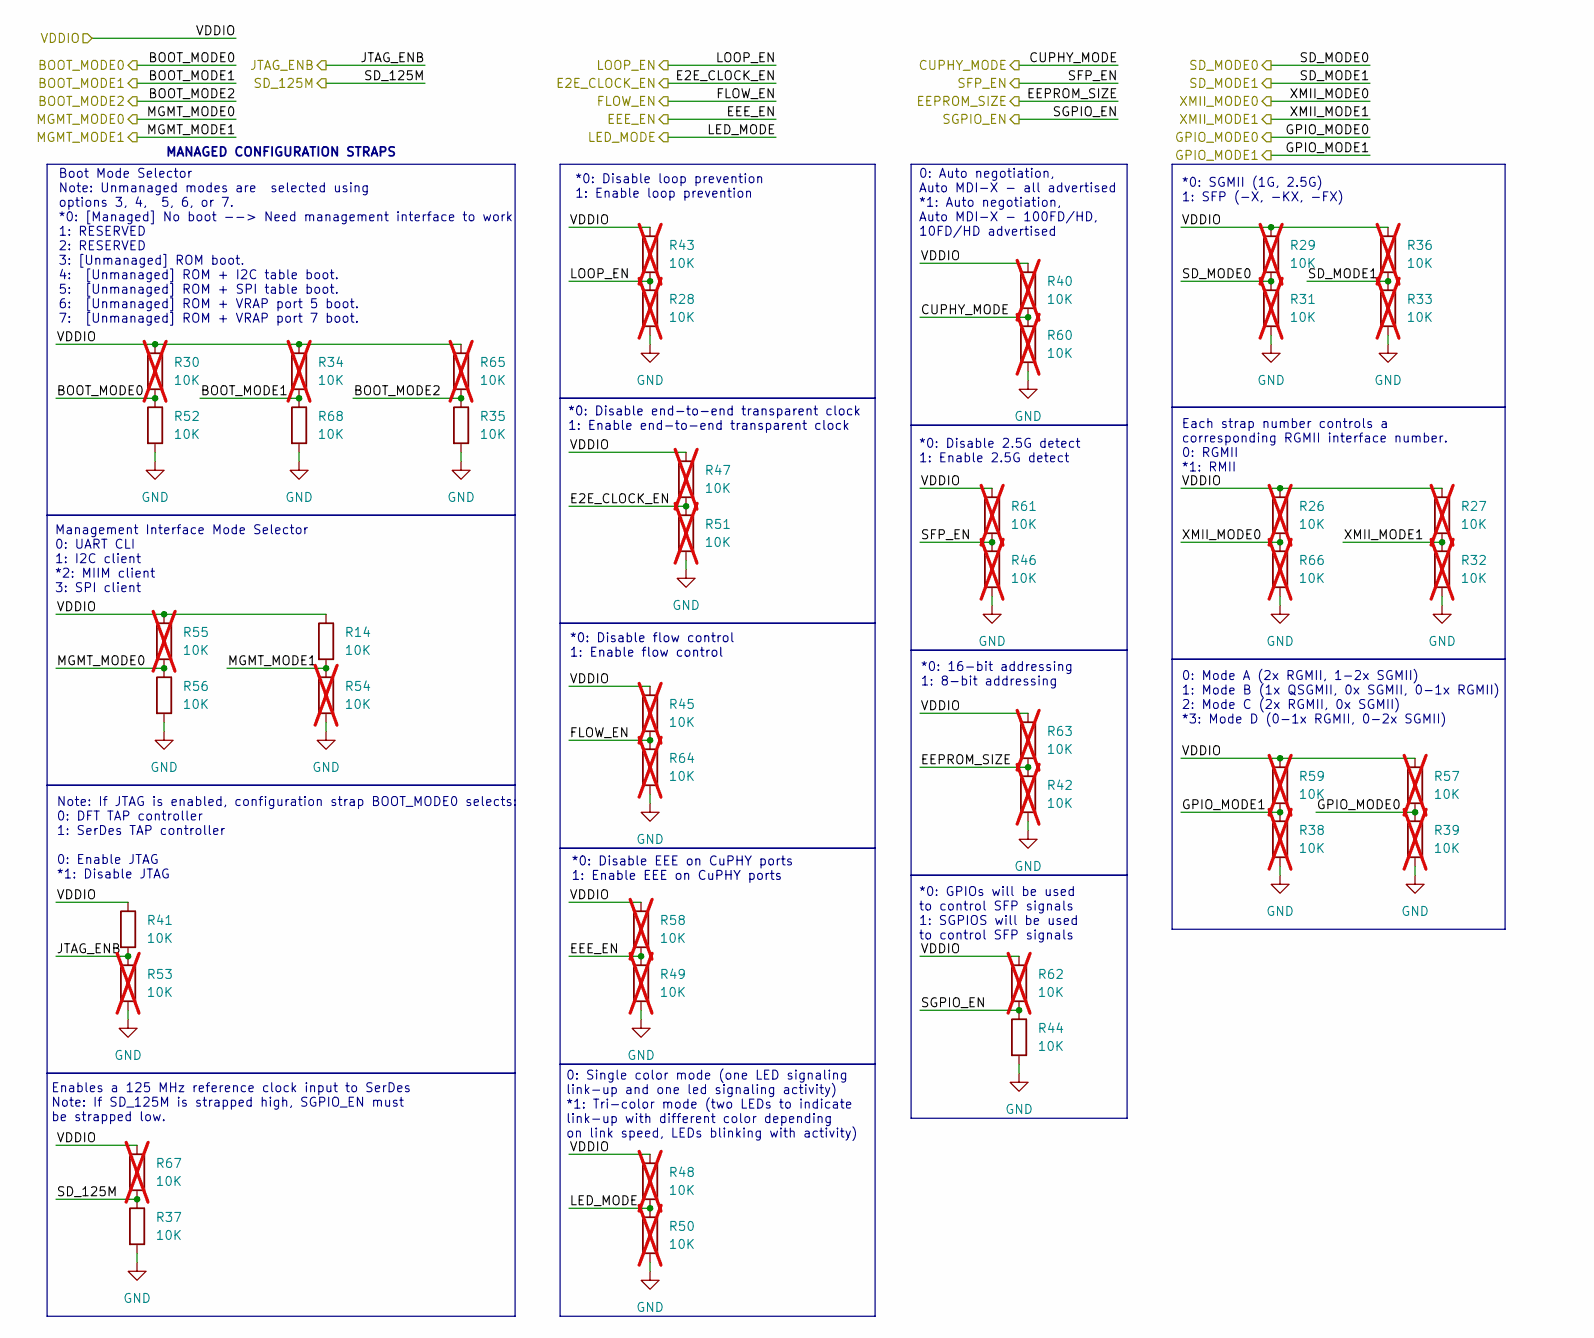
[picture p17: schematic switch_gpio_config.kicad_sch, Switch GPIOs strapping configuration]

Parts:
R14, R35, R37, R41, R44, R52, R56, R68: 10K; R_0603; Tolerance_in_pct 5; MPN CRCW060310K0JNEC; Mouser 71-CRCW060310K0JNEC
R26, R27, R28, R29, R30, R31, R32, R33, R34, R36, R38, R39, R40, R42, R43, R45, R46, R47, R48, R49, R50, R51, R53, R54, R55, R57, R58, R59, R60, R61, R62, R63, R64, R65, R66, R67: 10K; R_0603; Tolerance_in_pct 5; MPN CRCW060310K0JNEC; Mouser 71-CRCW060310K0JNEC; not fitted

Connections:
+3V3: R14.1, R26.1, R27.1, R29.1, R30.1, R34.1, R36.1, R40.1, R41.1, R43.1, R45.1, R47.1, R48.1, R55.1, R57.1, R58.1, R59.1, R61.1, R62.1, R63.1, R65.1, R67.1; also elsewhere on the board
/switch/switch_gpios/BOOT_MODE0: R30.2, R52.1; also elsewhere on the board
/switch/switch_gpios/BOOT_MODE1: R34.2, R68.1; also elsewhere on the board
/switch/switch_gpios/BOOT_MODE2: R35.1, R65.2; also elsewhere on the board
/switch/switch_gpios/CUPHY_MODE: R40.2, R60.1; also elsewhere on the board
/switch/switch_gpios/E2E_CLOCK_EN: R47.2, R51.1; also elsewhere on the board
/switch/switch_gpios/EEE_EN: R49.1, R58.2; also elsewhere on the board
/switch/switch_gpios/EEPROM_SIZE: R42.1, R63.2; also elsewhere on the board
/switch/switch_gpios/FLOW_EN: R45.2, R64.1; also elsewhere on the board
/switch/switch_gpios/GPIO_MODE0: R39.1, R57.2; also elsewhere on the board
/switch/switch_gpios/GPIO_MODE1: R38.1, R59.2; also elsewhere on the board
/switch/switch_gpios/JTAG_ENB: R41.2, R53.1; also elsewhere on the board
/switch/switch_gpios/LED_MODE: R48.2, R50.1; also elsewhere on the board
/switch/switch_gpios/LOOP_EN: R28.1, R43.2; also elsewhere on the board
/switch/switch_gpios/MGMT_MODE0: R55.2, R56.1; also elsewhere on the board
/switch/switch_gpios/MGMT_MODE1: R14.2, R54.1; also elsewhere on the board
/switch/switch_gpios/SD_125M: R37.1, R67.2; also elsewhere on the board
/switch/switch_gpios/SD_MODE0: R29.2, R31.1; also elsewhere on the board
/switch/switch_gpios/SD_MODE1: R33.1, R36.2; also elsewhere on the board
/switch/switch_gpios/SFP_EN: R46.1, R61.2; also elsewhere on the board
/switch/switch_gpios/SGPIO_EN: R44.1, R62.2; also elsewhere on the board
/switch/switch_gpios/XMII_MODE0: R26.2, R66.1; also elsewhere on the board
/switch/switch_gpios/XMII_MODE1: R27.2, R32.1; also elsewhere on the board
GND: R28.2, R31.2, R32.2, R33.2, R35.2, R37.2, R38.2, R39.2, R42.2, R44.2, R46.2, R49.2, R50.2, R51.2, R52.2, R53.2, R54.2, R56.2, R60.2, R64.2, R66.2, R68.2; also elsewhere on the board

Notes on the sheet:
*0: Disable EEE on CuPHY ports 1: Enable EEE on CuPHY ports
MANAGED CONFIGURATION STRAPS
*0: GPIOs will be used to control SFP signals 1: SGPIOS will be used to control SFP signals
Enables a 125 MHz reference clock input to SerDes Note: If SD_125M is strapped high, SGPIO_EN must be strapped low.
0: Single color mode (one LED signaling link-up and one led signaling activity) *1: Tri-color mode (two LEDs to indicate link-up with different color depending on link speed, LEDs blinking with activity)
*0: 16-bit addressing 1: 8-bit addressing
Management Interface Mode Selector 0: UART CLI 1: I2C client *2: MIIM client 3: SPI client
*0: Disable flow control 1: Enable flow control
*0: SGMII (1G, 2.5G) 1: SFP (-X, -KX, -FX)
*0: Disable end-to-end transparent clock 1: Enable end-to-end transparent clock
0: Auto negotiation, Auto MDI-X - all advertised *1: Auto negotiation, Auto MDI-X - 100FD/HD, 10FD/HD advertised
*0: Disable loop prevention 1: Enable loop prevention
Note: If JTAG is enabled, configuration strap BOOT_MODE0 selects: 0: DFT TAP controller 1: SerDes TAP controller 0: Enable JTAG *1: Disable JTAG
Each strap number controls a corresponding RGMII interface number. 0: RGMII *1: RMII
*0: Disable 2.5G detect 1: Enable 2.5G detect
0: Mode A (2x RGMII, 1-2x SGMII) 1: Mode B (1x QSGMII, 0x SGMII, 0-1x RGMII) 2: Mode C (2x RGMII, 0x SGMII) *3: Mode D (0-1x RGMII, 0-2x SGMII)
Boot Mode Selector Note: Unmanaged modes are selected using options 3, 4, 5, 6, or 7. *0: [Managed] No boot --> Need management interface to work 1: RESERVED 2: RESERVED 3: [Unmanaged] ROM boot. 4: [Unmanaged] ROM + I2C table boot. 5: [Unmanaged] ROM + SPI table boot. 6: [Unmanaged] ROM + VRAP port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
