kebag-logic/shish-lan/shish-lan.kicad_pcb

## KiCad design shish-lan.kicad_pcb (continued)

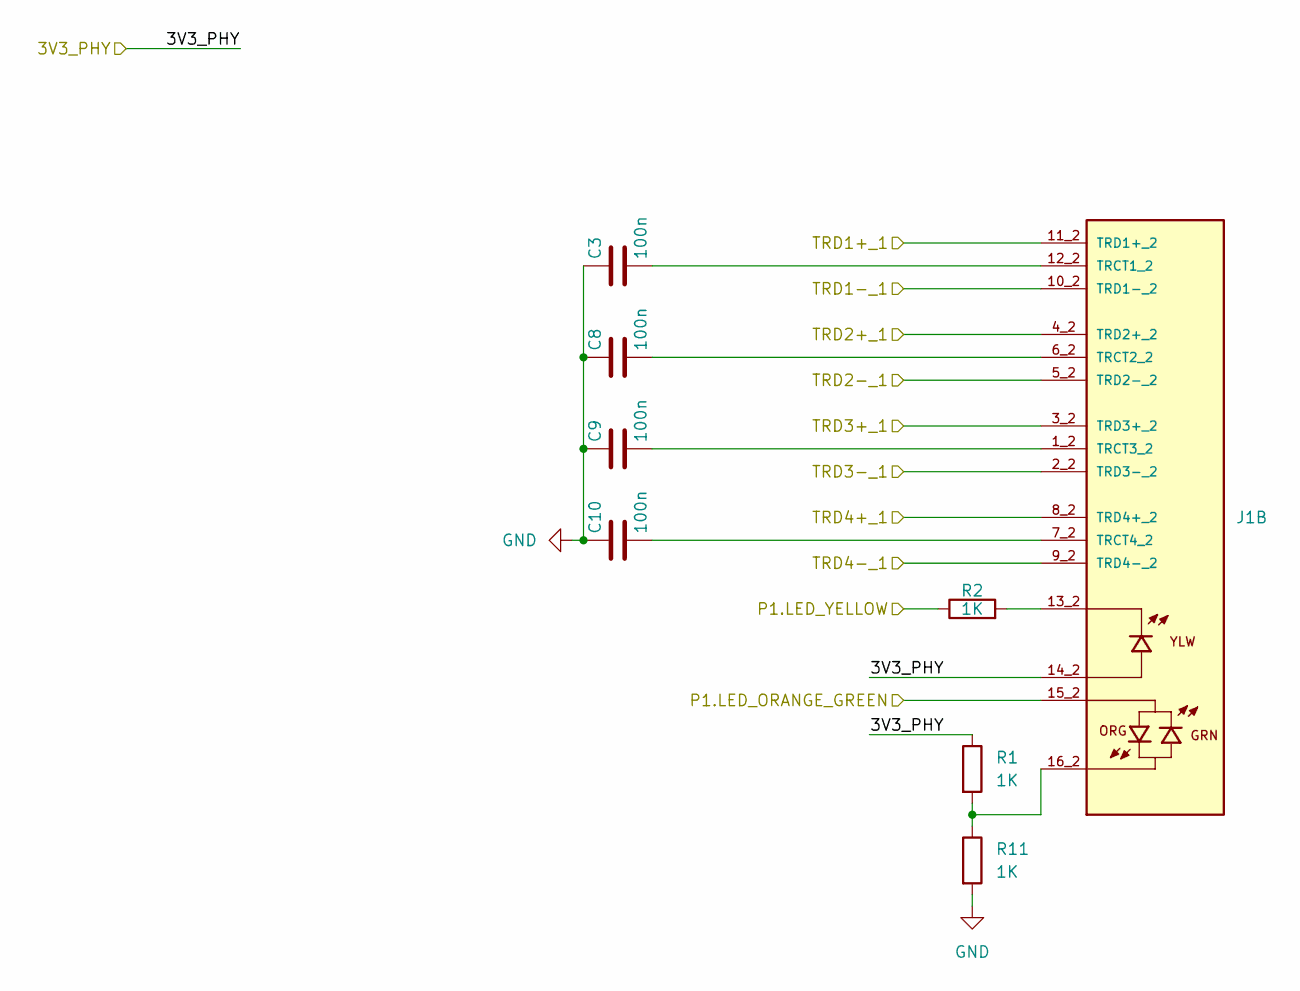
[picture p18: schematic RJ45_Connector_Port1.kicad_sch, RJ45 Connector Port 1]

Parts:
C3, C8, C9, C10: 100n; C_0603; Voltage_in_V 50; Tolerance_in_pct 10; MPN CL10B104KB8NNNC; Mouser 187-CL10B104KB8NNNC
J1: RJ45_0826-1X4T-43-F; BEL_0826-1X4T-43-F; MPN 0826-1X4T-43-F; Mouser 530-0826-1X4T-43-F
R1, R2, R11: 1K; R_0603; Tolerance_in_pct 5; MPN CRGCQ0603J1K0; Mouser 279-CRGCQ0603J1K0

Connections:
+3V3: J1.14_2, R1.1; also elsewhere on the board
/switch/switch_gpios/PHY1_LED0: R2.1; also elsewhere on the board
/switch/switch_gpios/PHY1_LED1: J1.15_2; also elsewhere on the board
/switch/switch_phys/RJ45_Connector_Port1/TRD1+_1: J1.11_2 (TRD1+_2); also elsewhere on the board
/switch/switch_phys/RJ45_Connector_Port1/TRD1-_1: J1.10_2 (TRD1-_2); also elsewhere on the board
/switch/switch_phys/RJ45_Connector_Port1/TRD2+_1: J1.4_2 (TRD2+_2); also elsewhere on the board
/switch/switch_phys/RJ45_Connector_Port1/TRD2-_1: J1.5_2 (TRD2-_2); also elsewhere on the board
/switch/switch_phys/RJ45_Connector_Port1/TRD3+_1: J1.3_2 (TRD3+_2); also elsewhere on the board
/switch/switch_phys/RJ45_Connector_Port1/TRD3-_1: J1.2_2 (TRD3-_2); also elsewhere on the board
/switch/switch_phys/RJ45_Connector_Port1/TRD4+_1: J1.8_2 (TRD4+_2); also elsewhere on the board
/switch/switch_phys/RJ45_Connector_Port1/TRD4-_1: J1.9_2 (TRD4-_2); also elsewhere on the board
GND: C3.1, C8.1, C9.1, C10.1, R11.2; also elsewhere on the board
unnamed: J1.13_2, R2.2
unnamed: J1.16_2, R1.2, R11.1
unnamed: C3.2, J1.12_2 (TRCT1_2)
unnamed: C8.2, J1.6_2 (TRCT2_2)
unnamed: C9.2, J1.1_2 (TRCT3_2)
unnamed: C10.2, J1.7_2 (TRCT4_2)

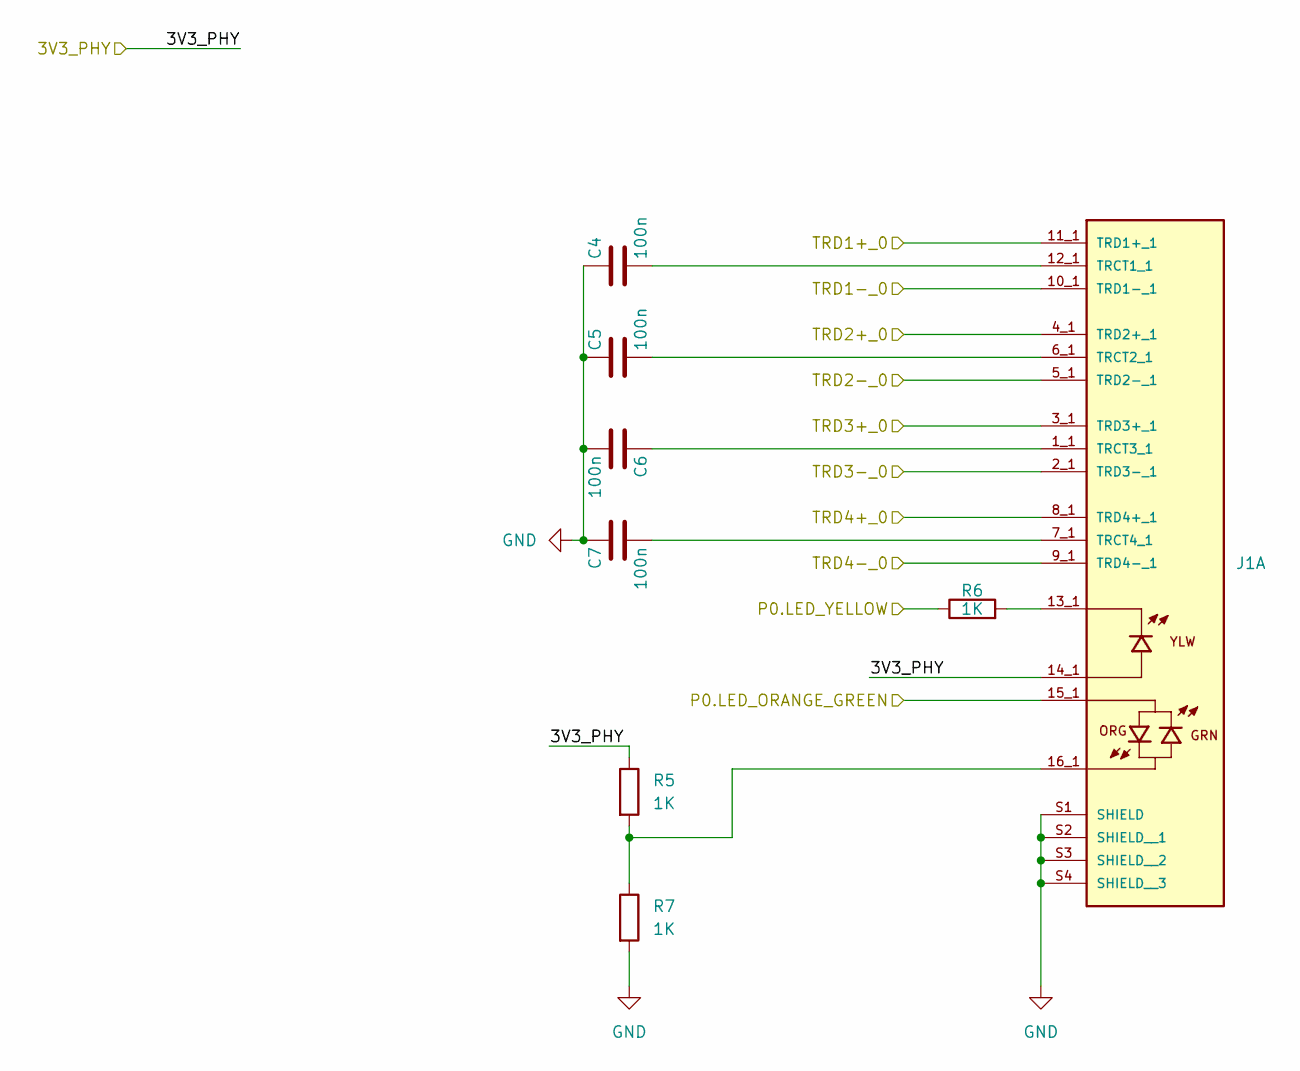
[picture p19: schematic RJ45_Connector_Port0.kicad_sch, RJ45 Connector Port 0]

Parts:
C4, C5, C6, C7: 100n; C_0603; Voltage_in_V 50; Tolerance_in_pct 10; MPN CL10B104KB8NNNC; Mouser 187-CL10B104KB8NNNC
J1: RJ45_0826-1X4T-43-F; BEL_0826-1X4T-43-F; MPN 0826-1X4T-43-F; Mouser 530-0826-1X4T-43-F
R5, R6, R7: 1K; R_0603; Tolerance_in_pct 5; MPN CRGCQ0603J1K0; Mouser 279-CRGCQ0603J1K0

Connections:
+3V3: J1.14_1, R5.1; also elsewhere on the board
/switch/switch_gpios/PHY0_LED0: R6.1; also elsewhere on the board
/switch/switch_gpios/PHY0_LED1: J1.15_1; also elsewhere on the board
/switch/switch_phys/RJ45_Connector_Port0/TRD1+_0: J1.11_1 (TRD1+_1); also elsewhere on the board
/switch/switch_phys/RJ45_Connector_Port0/TRD1-_0: J1.10_1 (TRD1-_1); also elsewhere on the board
/switch/switch_phys/RJ45_Connector_Port0/TRD2+_0: J1.4_1 (TRD2+_1); also elsewhere on the board
/switch/switch_phys/RJ45_Connector_Port0/TRD2-_0: J1.5_1 (TRD2-_1); also elsewhere on the board
/switch/switch_phys/RJ45_Connector_Port0/TRD3+_0: J1.3_1 (TRD3+_1); also elsewhere on the board
/switch/switch_phys/RJ45_Connector_Port0/TRD3-_0: J1.2_1 (TRD3-_1); also elsewhere on the board
/switch/switch_phys/RJ45_Connector_Port0/TRD4+_0: J1.8_1 (TRD4+_1); also elsewhere on the board
/switch/switch_phys/RJ45_Connector_Port0/TRD4-_0: J1.9_1 (TRD4-_1); also elsewhere on the board
GND: C4.1, C5.1, C6.2, C7.1, J1.S1 (SHIELD), J1.S2 (SHIELD__1), J1.S3 (SHIELD__2), J1.S4 (SHIELD__3), R7.2; also elsewhere on the board
unnamed: J1.13_1, R6.2
unnamed: J1.16_1, R5.2, R7.1
unnamed: C4.2, J1.12_1 (TRCT1_1)
unnamed: C5.2, J1.6_1 (TRCT2_1)
unnamed: C6.1, J1.1_1 (TRCT3_1)
unnamed: C7.2, J1.7_1 (TRCT4_1)

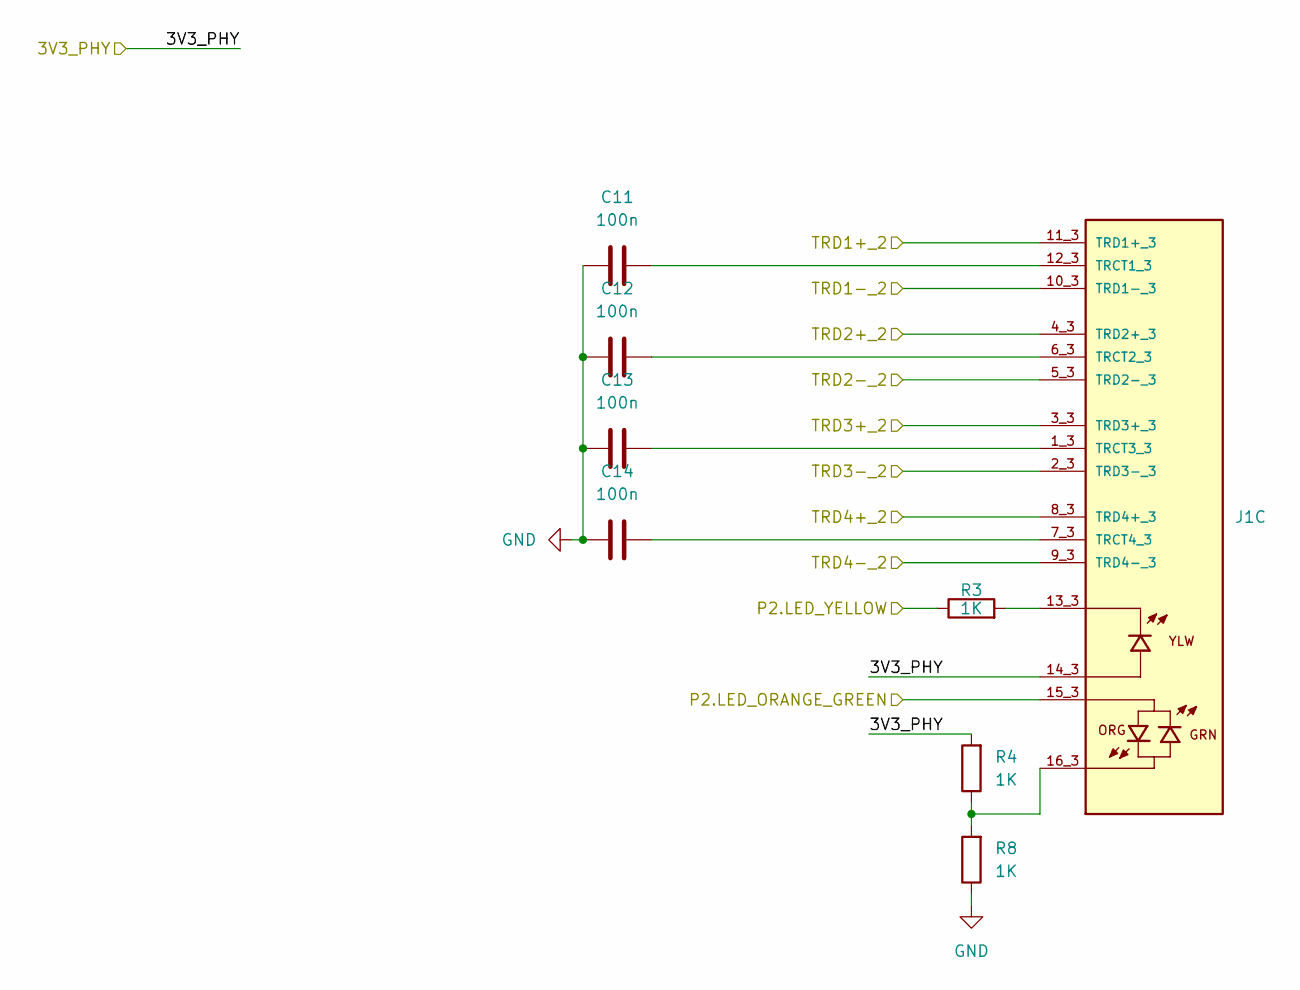
[picture p20: schematic RJ45_Connector_Port2.kicad_sch, RJ45 Connector Port 2]

Parts:
C11, C12, C13, C14: 100n; C_0603; Voltage_in_V 50; Tolerance_in_pct 10; MPN CL10B104KB8NNNC; Mouser 187-CL10B104KB8NNNC
J1: RJ45_0826-1X4T-43-F; BEL_0826-1X4T-43-F; MPN 0826-1X4T-43-F; Mouser 530-0826-1X4T-43-F
R3, R4, R8: 1K; R_0603; Tolerance_in_pct 5; MPN CRGCQ0603J1K0; Mouser 279-CRGCQ0603J1K0

Connections:
+3V3: J1.14_3, R4.2; also elsewhere on the board
/switch/switch_gpios/PHY2_LED0: R3.1; also elsewhere on the board
/switch/switch_gpios/PHY2_LED1: J1.15_3; also elsewhere on the board
/switch/switch_phys/RJ45_Connector_Port2/TRD1+_2: J1.11_3 (TRD1+_3); also elsewhere on the board
/switch/switch_phys/RJ45_Connector_Port2/TRD1-_2: J1.10_3 (TRD1-_3); also elsewhere on the board
/switch/switch_phys/RJ45_Connector_Port2/TRD2+_2: J1.4_3 (TRD2+_3); also elsewhere on the board
/switch/switch_phys/RJ45_Connector_Port2/TRD2-_2: J1.5_3 (TRD2-_3); also elsewhere on the board
/switch/switch_phys/RJ45_Connector_Port2/TRD3+_2: J1.3_3 (TRD3+_3); also elsewhere on the board
/switch/switch_phys/RJ45_Connector_Port2/TRD3-_2: J1.2_3 (TRD3-_3); also elsewhere on the board
/switch/switch_phys/RJ45_Connector_Port2/TRD4+_2: J1.8_3 (TRD4+_3); also elsewhere on the board
/switch/switch_phys/RJ45_Connector_Port2/TRD4-_2: J1.9_3 (TRD4-_3); also elsewhere on the board
GND: C11.2, C12.1, C13.1, C14.1, R8.1; also elsewhere on the board
unnamed: J1.13_3, R3.2
unnamed: J1.16_3, R4.1, R8.2
unnamed: C11.1, J1.12_3 (TRCT1_3)
unnamed: C12.2, J1.6_3 (TRCT2_3)
unnamed: C13.2, J1.1_3 (TRCT3_3)
unnamed: C14.2, J1.7_3 (TRCT4_3)

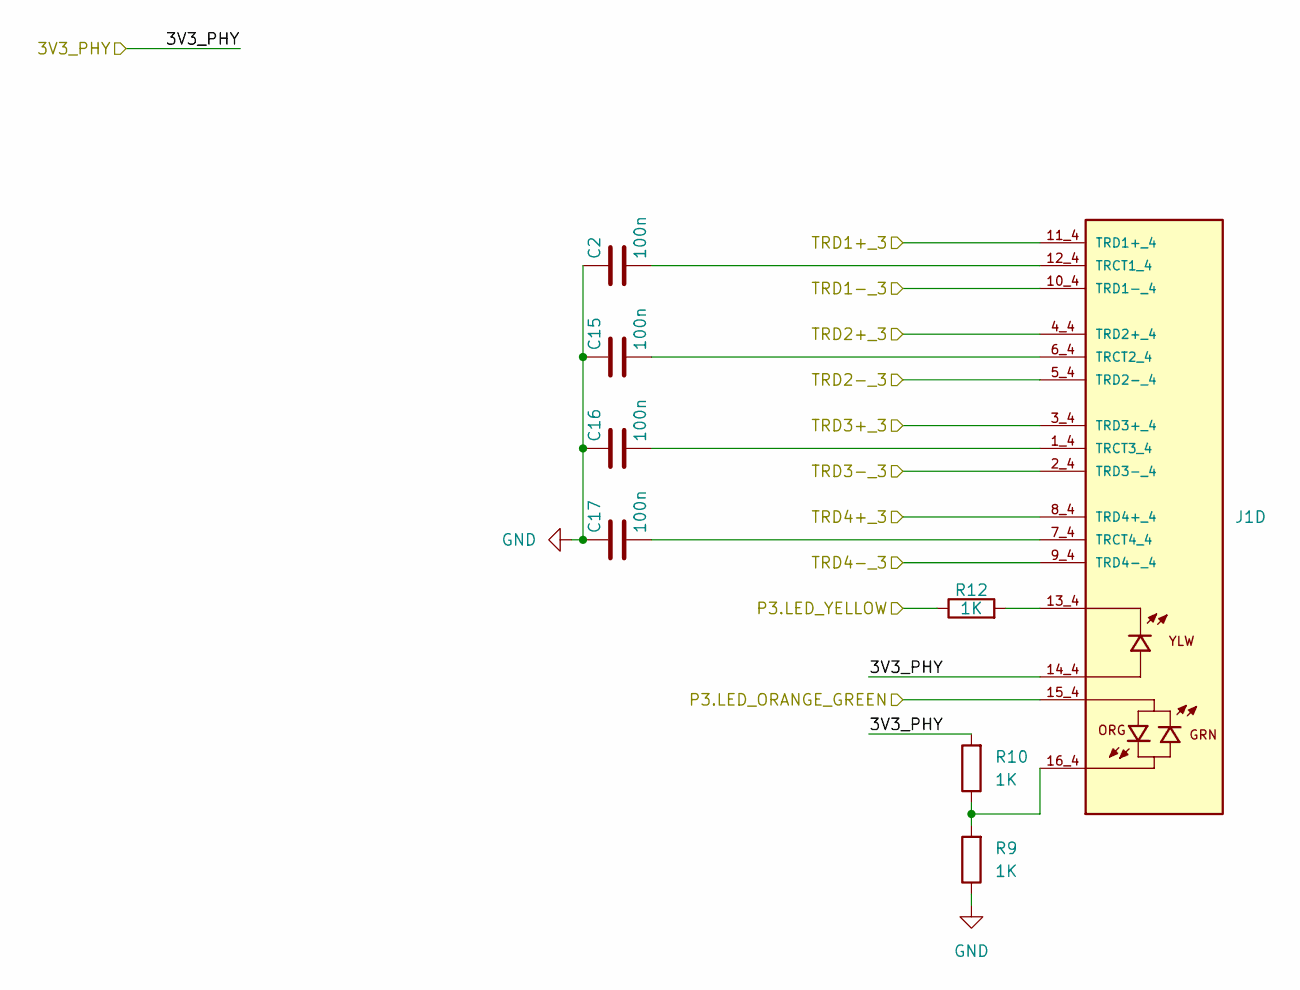
[picture p21: schematic RJ45_Connector_Port3.kicad_sch, RJ45 Connector Port 3]

Parts:
C2, C15, C16, C17: 100n; C_0603; Voltage_in_V 50; Tolerance_in_pct 10; MPN CL10B104KB8NNNC; Mouser 187-CL10B104KB8NNNC
J1: RJ45_0826-1X4T-43-F; BEL_0826-1X4T-43-F; MPN 0826-1X4T-43-F; Mouser 530-0826-1X4T-43-F
R9, R10, R12: 1K; R_0603; Tolerance_in_pct 5; MPN CRGCQ0603J1K0; Mouser 279-CRGCQ0603J1K0

Connections:
+3V3: J1.14_4, R10.2; also elsewhere on the board
/switch/switch_gpios/PHY3_LED0: R12.1; also elsewhere on the board
/switch/switch_gpios/PHY3_LED1: J1.15_4; also elsewhere on the board
/switch/switch_phys/RJ45_Connector_Port3/TRD1+_3: J1.11_4 (TRD1+_4); also elsewhere on the board
/switch/switch_phys/RJ45_Connector_Port3/TRD1-_3: J1.10_4 (TRD1-_4); also elsewhere on the board
/switch/switch_phys/RJ45_Connector_Port3/TRD2+_3: J1.4_4 (TRD2+_4); also elsewhere on the board
/switch/switch_phys/RJ45_Connector_Port3/TRD2-_3: J1.5_4 (TRD2-_4); also elsewhere on the board
/switch/switch_phys/RJ45_Connector_Port3/TRD3+_3: J1.3_4 (TRD3+_4); also elsewhere on the board
/switch/switch_phys/RJ45_Connector_Port3/TRD3-_3: J1.2_4 (TRD3-_4); also elsewhere on the board
/switch/switch_phys/RJ45_Connector_Port3/TRD4+_3: J1.8_4 (TRD4+_4); also elsewhere on the board
/switch/switch_phys/RJ45_Connector_Port3/TRD4-_3: J1.9_4 (TRD4-_4); also elsewhere on the board
GND: C2.1, C15.1, C16.1, C17.1, R9.1; also elsewhere on the board
unnamed: J1.13_4, R12.2
unnamed: J1.16_4, R9.2, R10.1
unnamed: C2.2, J1.12_4 (TRCT1_4)
unnamed: C15.2, J1.6_4 (TRCT2_4)
unnamed: C16.2, J1.1_4 (TRCT3_4)
unnamed: C17.2, J1.7_4 (TRCT4_4)

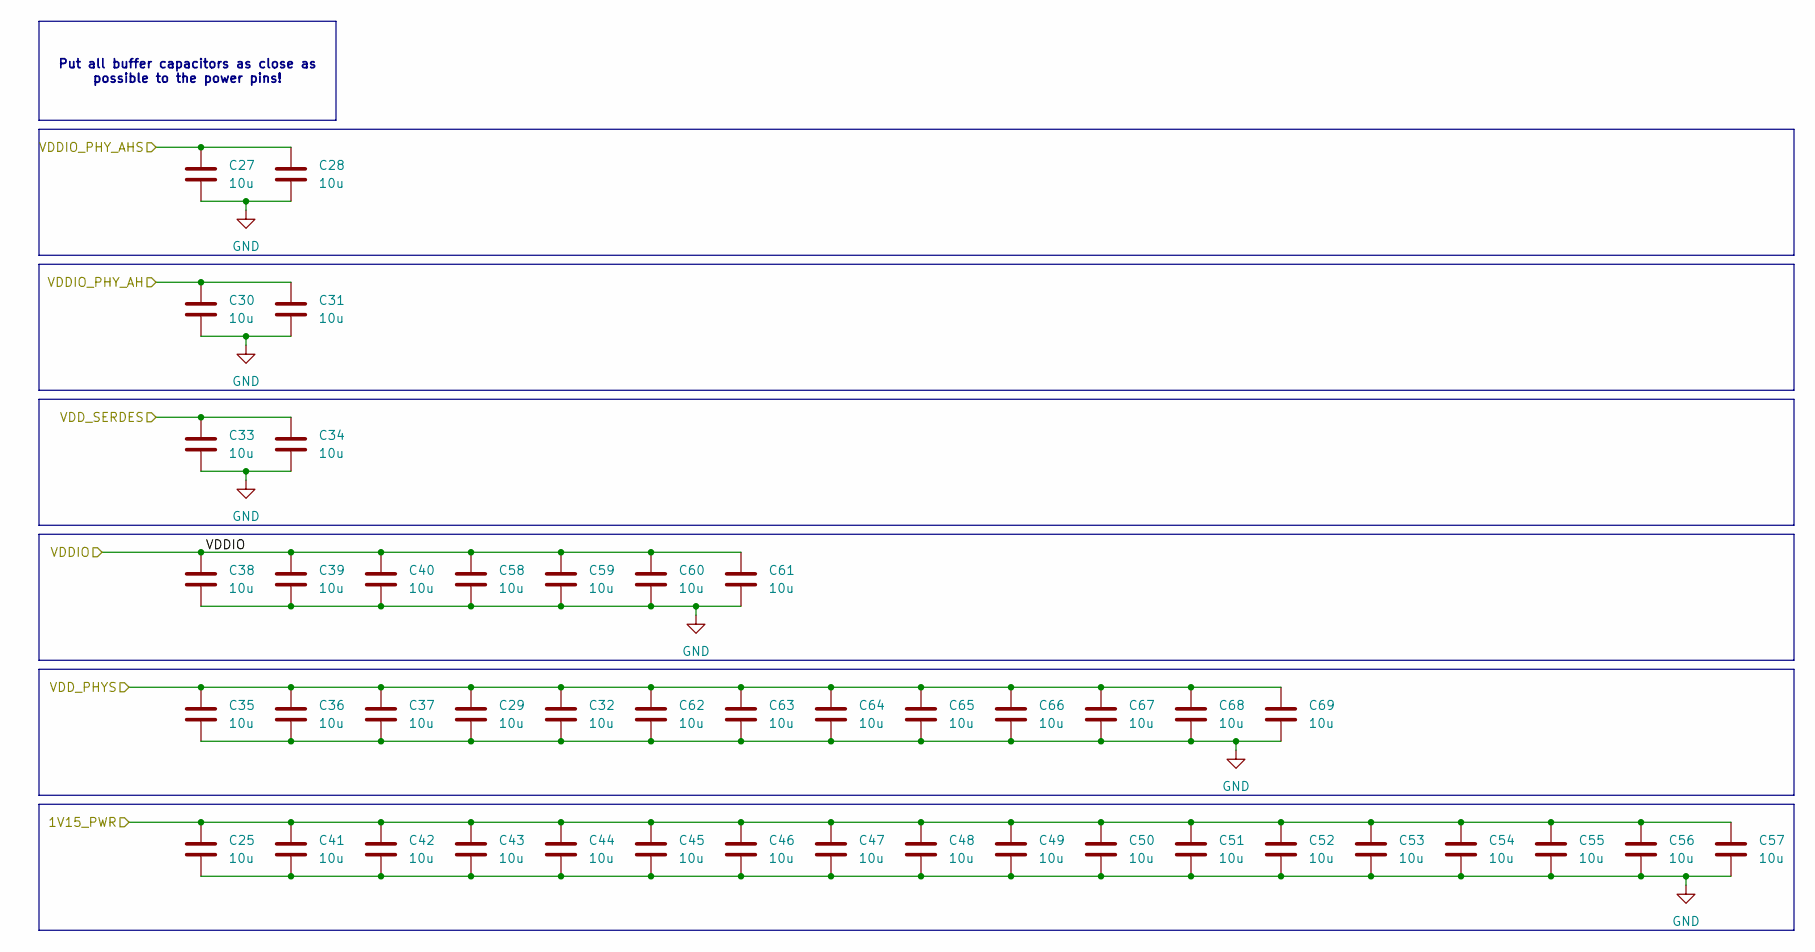
[picture p22: schematic switch_power_buffer_caps.kicad_sch, Power rail decoupling]

Parts:
C25, C27, C28, C29, C30, C31, C32, C33, C34, C35, C36, C37, C38, C39, C40, C41, C42, C43, C44, C45, C46, C47, C48, C49, C50, C51, C52, C53, C54, C55, C56, C57, C58, C59, C60, C61, C62, C63, C64, C65, C66, C67, C68, C69: 10u; C_0603; Voltage_in_V 25; Tolerance_in_pct 20; MPN CL10A106MA8NRNC; Mouser 187-CL10A106MA8NRNC

Connections:
/switch/switch_power/1V15_PWR_SWITCH: C25.1, C41.1, C42.1, C43.1, C44.1, C45.1, C46.1, C47.1, C48.1, C49.1, C50.1, C51.1, C52.1, C53.1, C54.1, C55.1, C56.1, C57.1; also elsewhere on the board
/switch/switch_power/VDDIO: C38.1, C39.1, C40.1, C58.1, C59.1, C60.1, C61.1; also elsewhere on the board
/switch/switch_power/VDDIO_PHY_AH: C30.1, C31.1; also elsewhere on the board
/switch/switch_power/VDDIO_PHY_AHS: C27.1, C28.1; also elsewhere on the board
/switch/switch_power/VDD_PHYS: C29.1, C32.1, C35.1, C36.1, C37.1, C62.1, C63.1, C64.1, C65.1, C66.1, C67.1, C68.1, C69.1; also elsewhere on the board
/switch/switch_power/VDD_SERDES: C33.1, C34.1; also elsewhere on the board
GND: C25.2, C27.2, C28.2, C29.2, C30.2, C31.2, C32.2, C33.2, C34.2, C35.2, C36.2, C37.2, C38.2, C39.2, C40.2, C41.2, C42.2, C43.2, C44.2, C45.2, C46.2, C47.2, C48.2, C49.2, C50.2, C51.2, C52.2, C53.2, C54.2, C55.2, C56.2, C57.2, C58.2, C59.2, C60.2, C61.2, C62.2, C63.2, C64.2, C65.2, C66.2, C67.2, C68.2, C69.2; also elsewhere on the board

Notes on the sheet:
Put all buffer capacitors as close as possible to the power pins!

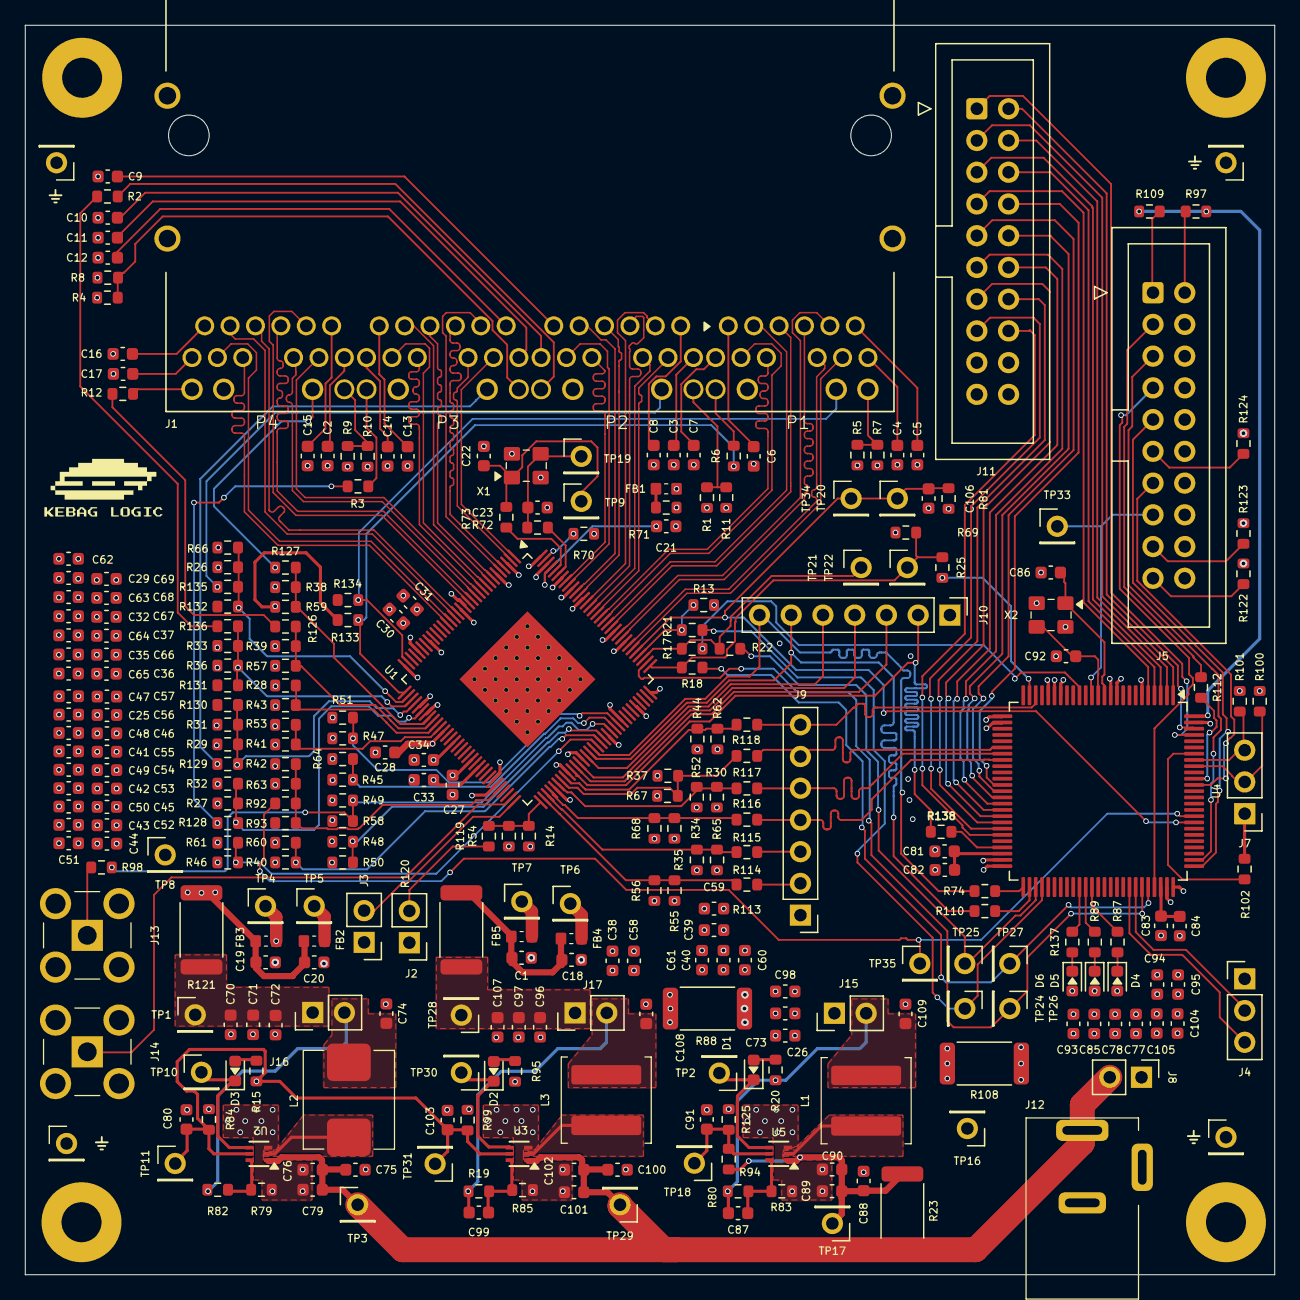
[picture p23: board shish-lan.kicad_pcb from above]

Board: 6 copper layers, 100.0 x 100.0 mm, 304 parts (0 on the bottom side), 197 nets.
