kebag-logic/shish-lan/(commit log)

2025-12-14 Initial commit of schematics
    [buck_1v1.kicad_sch, buck_2v5.kicad_sch, buck_3v3.kicad_sch, shish-lan.kicad_pcb, shish-lan.kicad_sch, switch_gpios.kicad_sch, switch_power.kicad_sch]
2025-12-14 switch: adding decoupling elements
    [switch_decoupling.kicad_sch]
2025-12-14 updating the shish-lan
    [shish-lan.kicad_sch]
2025-12-15 CuPhy: adding ports
    [buck_1v1.kicad_sch, buck_2v5.kicad_sch, buck_3v3.kicad_sch, shish-lan.kicad_sch, switch.kicad_sch, switch_decoupling.kicad_sch, switch_gpios.kicad_sch, switch_phys.kicad_sch]
2025-12-18 phys: adding resistor
    [switch_phys.kicad_sch]
2025-12-18 gpios: first version of the GPIOS and strapping schematics
    [switch_gpios.kicad_sch]
2025-12-18 switch: Connecting bucks/gpios/phys together
    [switch.kicad_sch]
2025-12-20 schematics: fixing the voltage rail and updating the files
    [buck_1v1.kicad_sch, buck_2v5.kicad_sch, buck_3v3.kicad_sch, switch.kicad_sch, switch_decoupling.kicad_sch, switch_gpios.kicad_sch, switch_phys.kicad_sch, switch_power.kicad_sch]
2025-12-20 updating the projects
    [shish-lan.kicad_sch]
2025-12-21 library: update to get all necessary componenents and footprints for the switch
2025-12-21 library: adding newer inductors symbols and footprints
2025-12-21 switch: finished 1st version
    [buck_1v1.kicad_sch, buck_2v5.kicad_sch, buck_3v3.kicad_sch, shish-lan.kicad_sch, switch.kicad_sch, switch_decoupling.kicad_sch, switch_gpios.kicad_sch, switch_phys.kicad_sch]
2025-12-21 minor footprint fixing
    [buck_1v1.kicad_sch, buck_2v5.kicad_sch, buck_3v3.kicad_sch, switch.kicad_sch, switch_gpios.kicad_sch, switch_phys.kicad_sch, switch_power.kicad_sch]
2025-12-28 review of +3V3 converter
    [buck_3v3.kicad_sch]
2025-12-28 review of +2V5 converter
    [buck_2v5.kicad_sch]
2025-12-28 review of +1V1 converter
    [buck_1v1.kicad_sch]
2026-01-05 switch: buck v1.1 -> v1.15 as requested by the switch
    [buck_1v15.kicad_sch]
2026-01-05 This commit intends to fix multiple issues:
    - 1.1 -> 1.15 v buck rails
    - Revision consistently using Rev. A
    - Issue with the Switch symbol when moving library
    - Adding new footprint and symbol for 2.54mm Headers
    [buck_1v15.kicad_sch, buck_2v5.kicad_sch, buck_3v3.kicad_sch, switch.kicad_sch, switch_gpios.kicad_sch, switch_phys.kicad_sch, switch_power.kicad_sch]
2026-01-05 switch: annotations on switch IC and connectors
    [switch.kicad_sch, switch_gpios.kicad_sch, switch_phys.kicad_sch, switch_power.kicad_sch]
2026-01-05 fixing issue related to symbol changes, and updating components
    [buck_1v15.kicad_sch, buck_2v5.kicad_sch, buck_3v3.kicad_sch, switch.kicad_sch, switch_gpios.kicad_sch, switch_phys.kicad_sch, switch_power.kicad_sch]
2026-01-06 updates test points
    [switch_power.kicad_sch]
2026-01-06 reviews GPIOS, improves readability, clean up
    [LAN96455F-GPIO.ods, switch_gpio_config.kicad_sch, switch_gpios.kicad_sch]
2026-01-20 updates all symbols to the project only paths. My bad - sorry
    [buck_1v15.kicad_sch, buck_2v5.kicad_sch, buck_3v3.kicad_sch, switch.kicad_sch, switch_gpio_config.kicad_sch, switch_gpios.kicad_sch]
2026-01-20 review of power part, cleanups, increase readability
    [switch_power.kicad_sch, switch_power_buffer_caps.kicad_sch]
2026-01-20 updates power sheet.
    [switch_power.kicad_sch]
2026-01-20 cleans up PHY section and moves connectors into separate subpages
    [RJ45_Connector_Port0.kicad_sch, RJ45_Connector_Port1.kicad_sch, RJ45_Connector_Port2.kicad_sch, RJ45_Connector_Port3.kicad_sch, switch_phys.kicad_sch]
2026-01-20 moves GND to common GND symbol
    [buck_1v15.kicad_sch, buck_2v5.kicad_sch, buck_3v3.kicad_sch]
2026-01-20 adds GND test points because there is always one missing for the perfect measurement
    [shish-lan.kicad_sch, switch.kicad_sch]
2026-01-20 fixes most critical ERC errors
    [buck_1v15.kicad_sch, buck_2v5.kicad_sch, buck_3v3.kicad_sch, switch.kicad_sch, switch_power_buffer_caps.kicad_sch]
2026-01-20 adds pin out documentation for stm32h7. Refs: #1
    [STM32H742_LQFP100_Pinout.ods]
2026-01-20 Initial commit for STM power. Refs: #1
    [controller.kicad_sch]
2026-01-20 updates documentation. Refs: #1
    [STM32H742_LQFP100_Pinout.ods]
2026-01-20 updates project file and schematic. Refs: #1
    [shish-lan.kicad_sch]
2026-01-20 documentation: stm32h7: adding RMII connection
2026-01-20 documentation: stm32h7: adding used orange signals
    [STM32H742_LQFP100_Pinout.ods]
2026-01-20 initial commit for GPIOs of STM32. Needs to resolve naming conflicts. Refs: #1
    [STM32H742_LQFP100_Pinout.ods, controller.kicad_sch, shish-lan.kicad_sch, switch.kicad_sch, switch_gpios.kicad_sch]
2026-01-23 adds enable pins for voltage converters. Refs: #1
    [STM32H742_LQFP100_Pinout.ods]
2026-01-23 udpating the pinout document
    [STM32H742_LQFP100_Pinout_updated_switch_io.ods]
2026-01-23 Adding missing I/O in red highlightings
    [STM32H742_LQFP100_Pinout_updated_switch_io.ods]
2026-01-23 updates kicad lib
2026-01-23 updates resistors and inductor symbol in 3V3 converter
    [buck_3v3.kicad_sch]
2026-01-23 updates resistors and inductor symbol in 2V5 converter
    [buck_2v5.kicad_sch]
2026-01-23 updates resistors and inductor symbol in 1V15 converter
    [buck_1v15.kicad_sch]
2026-01-23 renames 2V5 related nets
    [shish-lan.kicad_sch, switch.kicad_sch]
2026-01-23 renames 3V3 related nets
    [shish-lan.kicad_sch, switch.kicad_sch]
2026-01-23 renames 3V15 related nets
    [shish-lan.kicad_sch, switch.kicad_sch]
2026-01-23 updates IRQ0 related nets
    [shish-lan.kicad_sch, switch.kicad_sch, switch_gpios.kicad_sch]
2026-01-23 updates nRESET SWITCH related nets
    [switch.kicad_sch, switch_power.kicad_sch]
2026-01-23 updates 25MHz clock
    [shish-lan.kicad_sch, switch.kicad_sch]
2026-01-23 connects SYNCE pins directly to the component
    [switch.kicad_sch]
2026-01-23 updates RGMII bus to STM
    [shish-lan.kicad_sch, switch.kicad_sch]
2026-01-23 updates MIIM bus to STM
    [shish-lan.kicad_sch, switch.kicad_sch]
2026-01-23 excludes optional resistors from BOM
    [switch_gpios.kicad_sch]
2026-01-23 removes todo to check nreset logic in switch
    [switch_power.kicad_sch]
2026-01-23 aligns power blocks in the switch sheet
    [switch.kicad_sch]
2026-01-23 updates buck enable, rst and IRQ to new naming scheme. Refs: #1
    [controller.kicad_sch, crystal.kicad_sch, shish-lan.kicad_sch]
2026-01-24 adds crystal for STM. Refs: #1
    [STM32H742_LQFP100_Pinout_updated_switch_io.ods, controller.kicad_sch, crystal.kicad_sch]
2026-01-24 updates SPI pins. Refs: #1
    [STM32H742_LQFP100_Pinout_updated_switch_io.ods, controller.kicad_sch]
2026-01-24 adds uart support. Refs:#1
    [STM32H742_LQFP100_Pinout_updated_switch_io.ods, controller.kicad_sch]
2026-01-24 initial commit for jtag header. WIP. Refs: #1
    [STM32H742_LQFP100_Pinout_updated_switch_io.ods, controller.kicad_sch, jtag_header_arm.kicad_sch]
2026-01-24 Adding page title, and confidential for now
    [RJ45_Connector_Port0.kicad_sch, RJ45_Connector_Port1.kicad_sch, RJ45_Connector_Port2.kicad_sch, RJ45_Connector_Port3.kicad_sch, switch_power.kicad_sch, switch_power_buffer_caps.kicad_sch]
2026-01-24 Adding page title, and confidential for now, fixing gpio strapping and fixing comment for gpios strappings
    [switch_gpio_config.kicad_sch]
2026-01-24 excludes strapping resistors that are DNP from BOM
    [switch_gpio_config.kicad_sch]
2026-01-24 excludes optional CLK_25M resistor from BOM.
    [switch_power.kicad_sch]
2026-01-24 adds I2C Pull up and test points. Refs: #1
    [shish-lan.kicad_sch]
2026-01-24 adds boot0 configuration header. Refs: #1
    [STM32H742_LQFP100_Pinout_updated_switch_io.ods, controller.kicad_sch]
2026-01-24 adds testpoint to nrst pin for easier accessibility. Refs: #1
    [STM32H742_LQFP100_Pinout_updated_switch_io.ods, controller.kicad_sch]
2026-01-25 Fixing signal name for the RMII, instead of RGMII.TX_CTLR[0] call it RGMII.TXCTL-TX_DV
    [STM32H742_LQFP100_Pinout_updated_switch_io.ods]
2026-01-25 Fixing pinout for the U(S)ART
    [STM32H742_LQFP100_Pinout_updated_switch_io.ods]
2026-01-25 connects SPI from STM to Switch. Refs: #1
    [controller.kicad_sch, shish-lan.kicad_sch, switch.kicad_sch, switch_gpios.kicad_sch]
2026-01-25 connects MIIM bus from STM to Switch. Refs: #1
    [controller.kicad_sch, shish-lan.kicad_sch, switch.kicad_sch, switch_gpios.kicad_sch]
2026-01-25 connects RGMII1 bus between Switch and STM. Refs: #1
    [STM32H742_LQFP100_Pinout_updated_switch_io.ods, controller.kicad_sch, shish-lan.kicad_sch, switch.kicad_sch, switch_gpios.kicad_sch]
2026-01-25 connects nRST for switch. Refs: #1
    [shish-lan.kicad_sch]
2026-01-25 top level clean up. Refs: #1
    [shish-lan.kicad_sch]
2026-01-25 Uses crystal sheet in all places. Refs: #1
    [controller.kicad_sch, crystal.kicad_sch, shish-lan.kicad_sch, switch_power.kicad_sch]
2026-01-25 modularizes xtal at STM and switch power. Refs: #1
    [controller.kicad_sch, crystal.kicad_sch, switch_power.kicad_sch]
2026-01-25 connects JTAG header. Refs: #1
    [STM32H742_LQFP100_Pinout_updated_switch_io.ods, controller.kicad_sch, jtag_header_arm.kicad_sch]
2026-01-25 unused RGMII lanes are pull-up in Switch. Refs: #1
    [controller.kicad_sch]
2026-01-25 renames I2C to I2C1. Refs: #1
    [controller.kicad_sch, shish-lan.kicad_sch]
2026-01-25 updates UART to USART. Refs: #1
    [controller.kicad_sch]
2026-01-25 puts unused pins to GND as per design recommendation. Refs: #1
    [controller.kicad_sch]
2026-01-25 removes pull-up todo. Refs: #1
    [controller.kicad_sch]
2026-01-25 moves +3V3 converter to root. Refs: #1
    [buck_3v3.kicad_sch, controller.kicad_sch, shish-lan.kicad_sch, switch.kicad_sch]
2026-01-26 connects 1V15 and 2V5 to STM. Refs: #1
    [shish-lan.kicad_sch, switch.kicad_sch]
2026-01-26 fixes RGMII1 TX and RX resistors and duplicate name. Refs: #1
    [controller.kicad_sch, jtag_header_arm.kicad_sch, switch.kicad_sch, switch_gpios.kicad_sch]
2026-01-26 fixes duplicate R13. Refs: #1
    [controller.kicad_sch]
2026-01-26 removes unused en-3v3 signal from STM. Refs: #1
    [controller.kicad_sch]
2026-01-26 fixes duplicate buffer caps for STM. Refs: #1
    [controller.kicad_sch]
2026-01-26 fixes duplicate c83. Refs: #1
    [switch_power.kicad_sch]
2026-01-26 fixes duplicate R85. Refs: #1
    [jtag_header_arm.kicad_sch]
2026-01-27 fixes ERC errors in DC/DC converters
    [RJ45_Connector_Port0.kicad_sch, RJ45_Connector_Port1.kicad_sch, RJ45_Connector_Port2.kicad_sch, RJ45_Connector_Port3.kicad_sch, buck_1v15.kicad_sch, buck_2v5.kicad_sch, buck_3v3.kicad_sch, controller.kicad_sch]
2026-01-27 updates pin headers
    [controller.kicad_sch, shish-lan.kicad_sch, switch.kicad_sch]
2026-01-27 updates components from my library misconfiguration. Refs: #1
    [RJ45_Connector_Port0.kicad_sch, RJ45_Connector_Port1.kicad_sch, RJ45_Connector_Port2.kicad_sch, RJ45_Connector_Port3.kicad_sch, buck_1v15.kicad_sch, buck_2v5.kicad_sch, controller.kicad_sch, switch.kicad_sch]
2026-01-27 removes unused busses, adds cheaper 0R resistor, clean up to fix ERC errors. Refs: #1
    [RJ45_Connector_Port0.kicad_sch, RJ45_Connector_Port1.kicad_sch, RJ45_Connector_Port2.kicad_sch, RJ45_Connector_Port3.kicad_sch, STM32H742_LQFP100_Pinout_updated_switch_io.ods, buck_1v15.kicad_sch, buck_2v5.kicad_sch, buck_3v3.kicad_sch]
2026-01-27 consistent naming for hierarchical pin and attached net. Refs: #1
    [switch.kicad_sch, switch_phys.kicad_sch, switch_power.kicad_sch]
2026-01-27 puts unused STM pins to NC. Refs: #1
    [controller.kicad_sch]
2026-01-27 removes old ods file. Refs: #1
    [STM32H742_LQFP100_Pinout.ods, STM32H742_LQFP100_Pinout_updated_switch_io.ods]
2026-01-27 result after updating all components. Refs: #1
    [RJ45_Connector_Port0.kicad_sch, RJ45_Connector_Port1.kicad_sch, RJ45_Connector_Port2.kicad_sch, RJ45_Connector_Port3.kicad_sch, buck_1v15.kicad_sch, buck_2v5.kicad_sch, buck_3v3.kicad_sch, controller.kicad_sch]
2026-01-29 uses SPI2 instead of SPI in name. Refs: #1
    [controller.kicad_sch, shish-lan.kicad_sch, switch.kicad_sch, switch_gpios.kicad_sch]
2026-01-31 fixes incorrect SPI2 naming on switch sheets. Refs: #1
    [switch.kicad_sch, switch_gpios.kicad_sch]
2026-01-31 removes 25M CLK input for switch. Refs: #1
    [shish-lan.kicad_sch, switch.kicad_sch, switch_power.kicad_sch]
2026-01-31 RGMII1 bus uses Microchip names. Refs: #1
    [controller.kicad_sch, shish-lan.kicad_sch, switch.kicad_sch, switch_gpios.kicad_sch, switch_phys.kicad_sch, switch_power.kicad_sch]
2026-01-31 moves enable and IRQ GPIOs to PD0 to PD3 and reserves pins for I2S3. Refs: #1
    [controller.kicad_sch]
2026-01-31 updates JTAG header naming etc. Refs: #1
    [controller.kicad_sch, jtag_header_arm.kicad_sch]
2026-02-01 adds debug headers on STM side. Refs: #1
    [controller.kicad_sch, stm_dbg_header.kicad_sch]
2026-02-01 adds footprint for VXM7. Refs: #1
    [controller.kicad_sch, crystal.kicad_sch, switch.kicad_sch]
2026-02-01 adds footprint for ferrite bead. Refs: #1
    [switch_power.kicad_sch]
2026-02-01 aligns items to grid. Refs: #1
    [controller.kicad_sch]
2026-02-01 updates component details for ordering. Refs: #1
    [RJ45_Connector_Port0.kicad_sch, RJ45_Connector_Port1.kicad_sch, RJ45_Connector_Port2.kicad_sch, RJ45_Connector_Port3.kicad_sch, buck_1v15.kicad_sch, buck_2v5.kicad_sch, buck_3v3.kicad_sch, controller.kicad_sch]
2026-02-08 1: ading 0R on the JTAG TRST
    [jtag_header_arm.kicad_sch]
2026-02-13 final clean up. Refs: #1
    [RJ45_Connector_Port0.kicad_sch, RJ45_Connector_Port2.kicad_sch, jtag_header_arm.kicad_sch, shish-lan.kicad_sch]
2026-02-13 moves 0R rail resistors for switch and controller to correct position. Refs: #1
    [controller.kicad_sch, switch_power.kicad_sch]
2026-02-13 moves overseen 0R rail resistors to the correct place. Refs: #1
    [controller.kicad_sch, switch_power.kicad_sch]
2026-02-14 1: adding JTAG header sheet name
    [jtag_header_arm.kicad_sch]
2026-02-14 1: adding crystal sheet name
    [crystal.kicad_sch]
2026-02-14 1: adding controller sheet name
    [controller.kicad_sch]
2026-02-22 initial commit for automatic current consumption calculation. Refs: #9
    [controller.kicad_sch, switch.kicad_sch, switch_gpios.kicad_sch, switch_phys.kicad_sch, switch_power.kicad_sch]
2026-02-22 adds dc/dc converters to current consumption. Refs: #9
    [buck_1v15.kicad_sch, buck_2v5.kicad_sch, buck_3v3.kicad_sch]
2026-02-22 updates symbols and fixes ERC errors. Refs: #9
    [RJ45_Connector_Port0.kicad_sch, RJ45_Connector_Port1.kicad_sch, RJ45_Connector_Port2.kicad_sch, RJ45_Connector_Port3.kicad_sch, buck_1v15.kicad_sch, buck_2v5.kicad_sch, buck_3v3.kicad_sch, controller.kicad_sch]
2026-02-22 adds green status LED to buck converters. Refs: #7
    [buck_1v15.kicad_sch, buck_2v5.kicad_sch, buck_3v3.kicad_sch]
2026-02-23 adds green, orange and red LED to controller. Refs: #7
    [controller.kicad_sch]
2026-02-25 auto naming of the output file. Refs: #11
    [LAN96455F-GPIO.ods, STM32H742_LQFP100_Pinout.ods]
2026-02-25 adds power connector. Refs: #8
    [shish-lan.kicad_sch]
2026-02-26 20: swapping RGMII port from RGMII1 to RGMII0
    [shish-lan.kicad_sch, switch.kicad_sch, switch_gpios.kicad_sch]
2026-02-28 updates LEDs. Refs: #7
    [buck_1v15.kicad_sch, buck_2v5.kicad_sch, buck_3v3.kicad_sch, controller.kicad_sch]
2026-02-28 initial commit for SMA connector. WIP. Refs: #10
2026-02-28 clean up and fix on controller. Refs: #20
    [controller.kicad_sch, shish-lan.kicad_sch, switch.kicad_sch, switch_gpios.kicad_sch]
2026-02-28 updates footprints on separate branch in kebag_logic_libs. Refs: #24
2026-02-28 proper name for SMA connector. Refs: #10
2026-03-03 initial commit for mounting holes. WIP. Refs: #26
2026-03-03 towards a merge conflict free schematic. Refs: #9
    [buck_1v15.kicad_sch, buck_2v5.kicad_sch, buck_3v3.kicad_sch, switch.kicad_sch, switch_gpio_config.kicad_sch, switch_gpios.kicad_sch]
2026-03-03 fixes footprints. Refs: #24
2026-03-03 adds mounting holes. Refs: #26
    [shish-lan.kicad_pcb, shish-lan.kicad_sch]
2026-03-03 fixes SMA footprint. Refs: #10
2026-03-03 updates footprints in kebag lib and fixes old reference in controller. Refs: #33
    [controller.kicad_sch]
2026-03-10 increases the courtyard distance for mounting holes. Refs: #26
2026-03-10 adds SMA connector to both PTP0 pins. Refs: #10
    [switch_gpios.kicad_sch]
2026-03-10 updates 0R resistor to 0603. Refs: #31
    [jtag_header_arm.kicad_sch]
2026-03-24 updates kicad library. Refs: #29
2026-03-24 updates footprints. Refs: #33
2026-03-24 removes unnecessary 0R resistors. Refs: #30
    [switch_power.kicad_sch]
2026-03-24 updates components to latest library. Refs: #30
    [RJ45_Connector_Port0.kicad_sch, RJ45_Connector_Port1.kicad_sch, RJ45_Connector_Port2.kicad_sch, RJ45_Connector_Port3.kicad_sch, buck_1v15.kicad_sch, buck_2v5.kicad_sch, buck_3v3.kicad_sch, controller.kicad_sch]
2026-03-27 updates RJ45 to latest version. Refs: #33
    [RJ45_Connector_Port0.kicad_sch, RJ45_Connector_Port1.kicad_sch, RJ45_Connector_Port2.kicad_sch, RJ45_Connector_Port3.kicad_sch]
2026-04-16 open project in KiCAD10. Refs: #41
    [RJ45_Connector_Port0.kicad_sch, RJ45_Connector_Port1.kicad_sch, RJ45_Connector_Port2.kicad_sch, RJ45_Connector_Port3.kicad_sch, buck_1v15.kicad_sch, buck_2v5.kicad_sch, buck_3v3.kicad_sch, controller.kicad_sch]
2026-04-16 updates components in shish-lan. Refs: #41
    [shish-lan.kicad_sch]
2026-04-16 updates switch. Refs: #41
    [switch.kicad_sch]
2026-04-16 updates buck_1v15. Refs: #41
    [buck_1v15.kicad_sch]
2026-04-16 updates buck_2v5. Refs: #41
    [buck_2v5.kicad_sch]
2026-04-16 updates switch_gpios. Refs: #41
    [switch_gpios.kicad_sch]
2026-04-16 updates switch_gpio_config. Refs: #41
    [switch_gpio_config.kicad_sch]
2026-04-16 updates switch_power. Refs: #41
    [switch_power.kicad_sch]
2026-04-16 updates switch_power_buffer_caps. Refs:#41
    [switch_power_buffer_caps.kicad_sch]
2026-04-16 updates switch_phys. Refs: #41
    [switch_phys.kicad_sch]
2026-04-16 updates RJ45_Connector_Port0. Refs: #41
    [RJ45_Connector_Port0.kicad_sch]
2026-04-16 updates RJ45_Connector_Port1. Refs: #41
    [RJ45_Connector_Port1.kicad_sch]
2026-04-16 updates RJ45_Connector_Port2. Refs: #41
    [RJ45_Connector_Port2.kicad_sch]
2026-04-16 updates RJ45_Connector_Port3. Refs: #41
    [RJ45_Connector_Port3.kicad_sch]
2026-04-16 updates buck_3v3. Refs: #41
    [buck_3v3.kicad_sch]
2026-04-16 updates controller. Refs: #41
    [controller.kicad_sch]
2026-04-16 updates jtag_header_arm. Refs: #41
    [jtag_header_arm.kicad_sch]
2026-04-16 updates stm_dbg_header. Refs: #41
    [stm_dbg_header.kicad_sch]
2026-04-16 updates crystal. Refs: #41
    [crystal.kicad_sch]
2026-04-16 updates components in RJ45_Connector_Port0. Refs: #41
    [RJ45_Connector_Port0.kicad_sch]
2026-04-16 updates components in switch. Refs: #41
    [switch.kicad_sch]
2026-04-16 updates components in switch_gpios. Refs: #41
    [switch_gpios.kicad_sch]
2026-04-17 initial commit for RJ45 header, mounting holes, power connectors, PPS, GND TP. Refs: #43
    [shish-lan.kicad_pcb]
2026-04-19 shish-lan: pbc: adding proposition, movin sma and moving power, adding header as well
    [shish-lan.kicad_pcb]
2026-05-11 updates 2u2 capacitors. Refs: #41
    [controller.kicad_sch]
2026-05-11 updates 10pF capacitor. Refs: #41
    [buck_2v5.kicad_sch, buck_3v3.kicad_sch, crystal.kicad_sch]
2026-05-21 replaces 0402 100n caps with 0603 100n cap. Refs: #46
    [switch_power.kicad_sch]
2026-05-23 adds output jumper for +3V3. Refs: #49
    [buck_3v3.kicad_sch]
2026-05-23 adds output jumper for +1V15. Refs: #49
    [buck_1v15.kicad_sch]
2026-05-23 adds output jumper for +2V5. Refs: #49
    [buck_2v5.kicad_sch]
2026-05-23 connects the shield pins to GND. Refs: #50
    [RJ45_Connector_Port0.kicad_sch]
2026-05-23 replaces all capacitors with 10u. Refs: #52
    [buck_1v15.kicad_sch]
2026-05-24 moves 0R resistor in front of buffering caps. Refs: #57
    [controller.kicad_sch]
2026-05-24 moves all STM32 power behind the 0R resistor. Refs: #57
    [controller.kicad_sch, jtag_header_arm.kicad_sch]
2026-05-24 puts switch power rails behind 0R resistor. Refs: #57
    [switch_power.kicad_sch]
2026-05-29 layout v1
    [buck_1v15.kicad_sch, buck_2v5.kicad_sch, buck_3v3.kicad_sch, controller.kicad_sch, shish-lan.kicad_pcb, switch.kicad_sch, switch_gpios.kicad_sch]
2026-09-26 Rename Net Class property to Netclass
    Refs #109
    [buck_1v15.kicad_sch, buck_2v5.kicad_sch, buck_3v3.kicad_sch, controller.kicad_sch, switch.kicad_sch, switch_gpios.kicad_sch, switch_power.kicad_sch]
2026-09-26 Remove stale foreign instance records
    Refs #79
    [buck_1v15.kicad_sch, buck_2v5.kicad_sch, switch.kicad_sch, switch_decoupling.kicad_sch, switch_gpio_config.kicad_sch, switch_gpios.kicad_sch, switch_phys.kicad_sch, switch_power.kicad_sch]
2026-09-26 Pull JTAG_ENB high: fit R41, DNP R53
    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
    [switch_gpio_config.kicad_sch, switch_gpios.kicad_sch]
2026-09-26 Udpate text to not confuse people Refs: #79
    [switch_gpio_config.kicad_sch]
2026-09-26 Managed mode: boot 000, DNP unmanaged straps
    Refs #62
    [switch_gpio_config.kicad_sch]
2026-09-26 RMII: cross TX_EN and CRS_DV
    Refs #68
    [controller.kicad_sch]
2026-09-26 BOOT0: 10k to GND, remove J6
    Refs #70
    [controller.kicad_sch]
2026-09-26 Boot mode note: mark managed (0) as default
    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
    [switch_gpio_config.kicad_sch]
2026-09-26 NTRST pull-up: R133 10K to 3V3
    Refs #93
    [switch_gpios.kicad_sch]
2026-09-26 MDIO pull-up R69: 10K to 1K5
    Refs #78
    [switch_gpios.kicad_sch]
2026-09-26 NTRST pull-up to VDDIO_SWITCH instead of +3V3
    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
    [switch_gpios.kicad_sch]
2026-09-26 Buck EN tied to 3V3, remove controller test points
    Refs #94
    [controller.kicad_sch, shish-lan.kicad_sch, switch.kicad_sch, switch_gpios.kicad_sch]
2026-09-26 Remove leftover EN sheet pins on switch sheet
    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
    [shish-lan.kicad_sch]
2026-09-26 Fit R97/R109 for ST-LINK VDD sense
    Refs #96
    [jtag_header_arm.kicad_sch]
2026-09-26 U1: pin 123 = XO, 124 = XI
    Refs #72
    [switch.kicad_sch, switch_gpios.kicad_sch, switch_power.kicad_sch]
2026-09-29 Add 22R R138 on STM32 TX_EN (PB11)
    Refs #119
    [controller.kicad_sch]
2026-09-29 fixing 121 and udpate all components without their right reference Refs #121
    [controller.kicad_sch, shish-lan.kicad_sch, switch.kicad_sch, switch_gpios.kicad_sch, switch_phys.kicad_sch, switch_power.kicad_sch]
2026-09-29 Refs: 108 preparing the pcb for next revision B
    [shish-lan.kicad_pcb]
2026-09-29 PCB rev B: DNP sync, RMII GND vias, R102 silk
    Refs #108
    [shish-lan.kicad_pcb]
2026-09-29 Add rev B production files for JLCPCB
    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
    [shish-lan-B_Cu.gbl, shish-lan-B_Mask.gbs, shish-lan-B_Paste.gbp, shish-lan-B_Silkscreen.gbo, shish-lan-Edge_Cuts.gm1, shish-lan-F_Cu.gtl, shish-lan-F_Mask.gts, shish-lan-F_Paste.gtp]
2026-11-08 Drive RJ45 bicolor LED from LED0 and LED1
    Refs #124
